MaltWhiskey/Technasium/Tech Cube/Documents/Pictures (used)/Frame test.JPEG

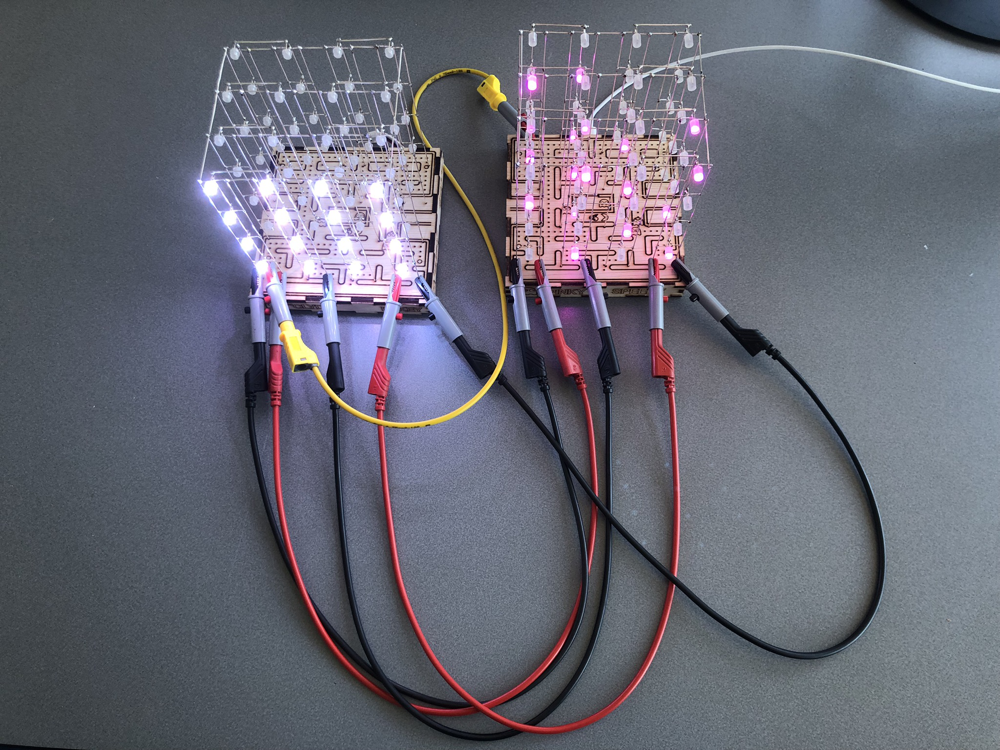
Tech Cube/Documents/Pictures (used)/Frame test.JPEG
