MaltWhiskey/Technasium/Tech Cube/Documents/Pictures/IMG_8260.JPEG

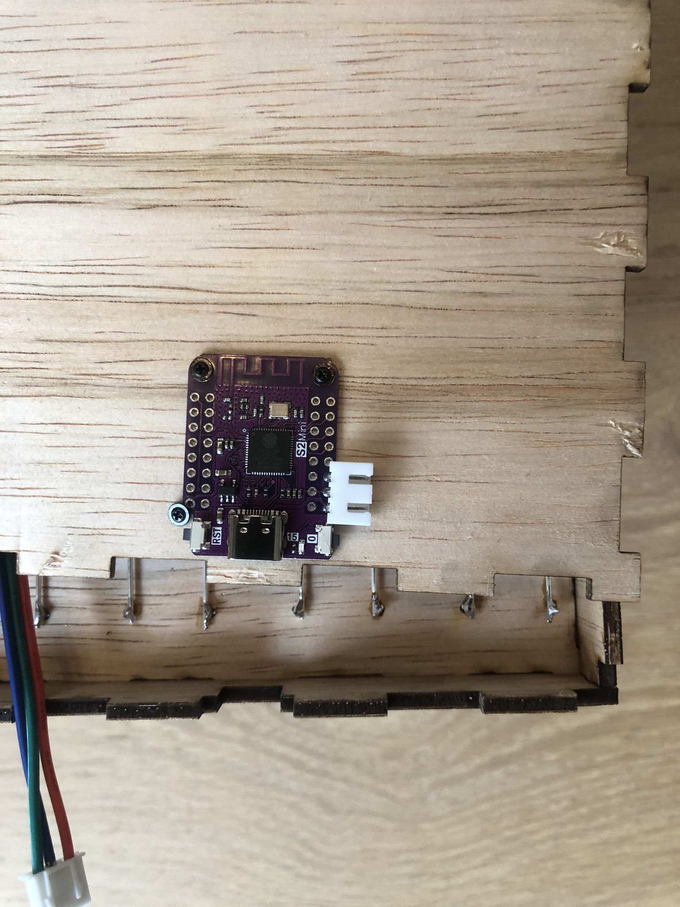
Tech Cube/Documents/Pictures/IMG_8260.JPEG
