MaltWhiskey/Technasium/Halloween/Sounds/Audacity.png

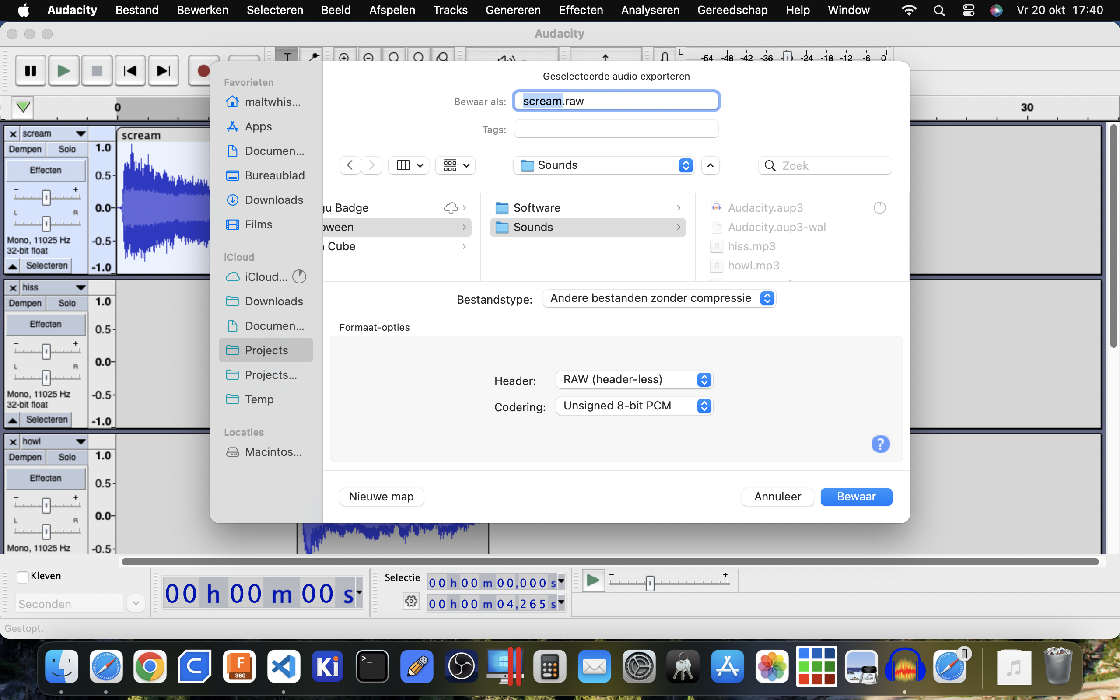
Halloween/Sounds/Audacity.png
