MaltWhiskey/Technasium/Tech Cube/Documents/Pictures (used)/Buigen.JPEG

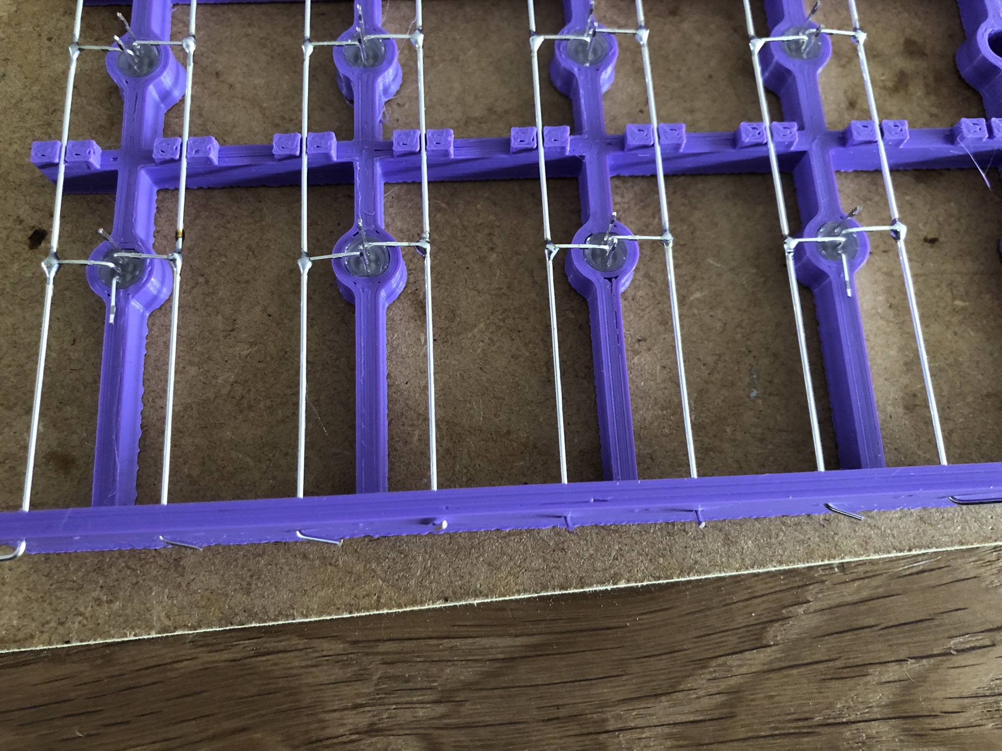
Tech Cube/Documents/Pictures (used)/Buigen.JPEG
