MaltWhiskey/Technasium/Tech Cube/Documents/Pictures (used)/F1.JPEG

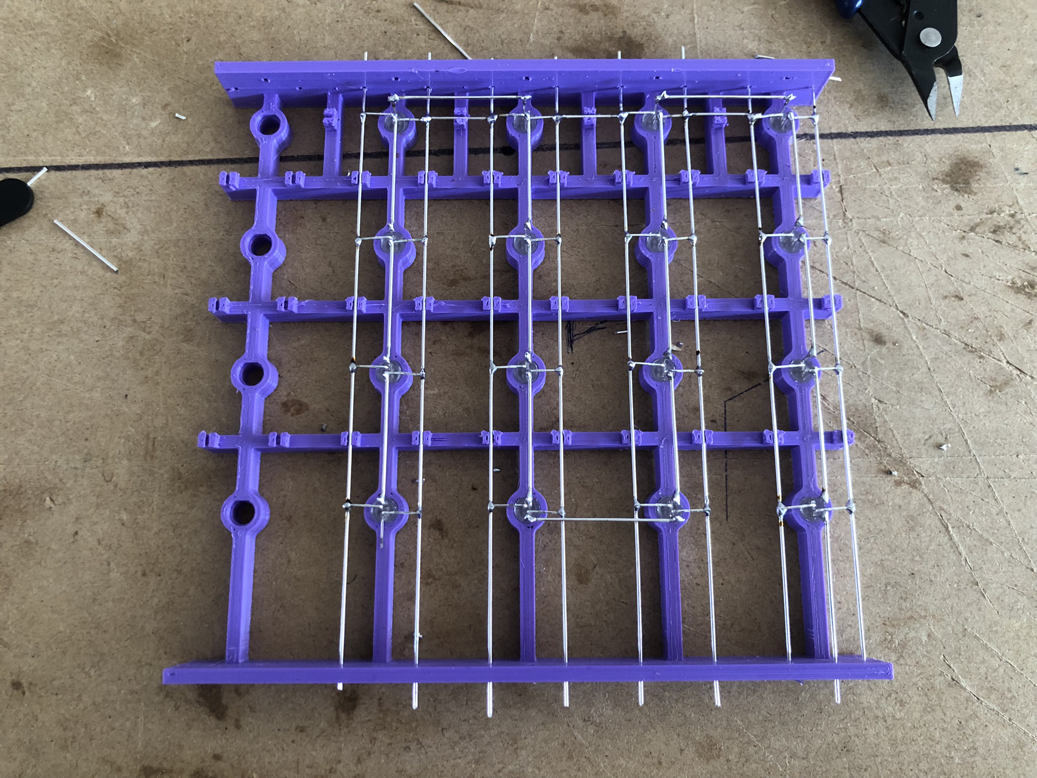
Tech Cube/Documents/Pictures (used)/F1.JPEG
