MaltWhiskey/Technasium/Tech Cube/Documents/Pictures (used)/F1F3 + Vormer.JPEG

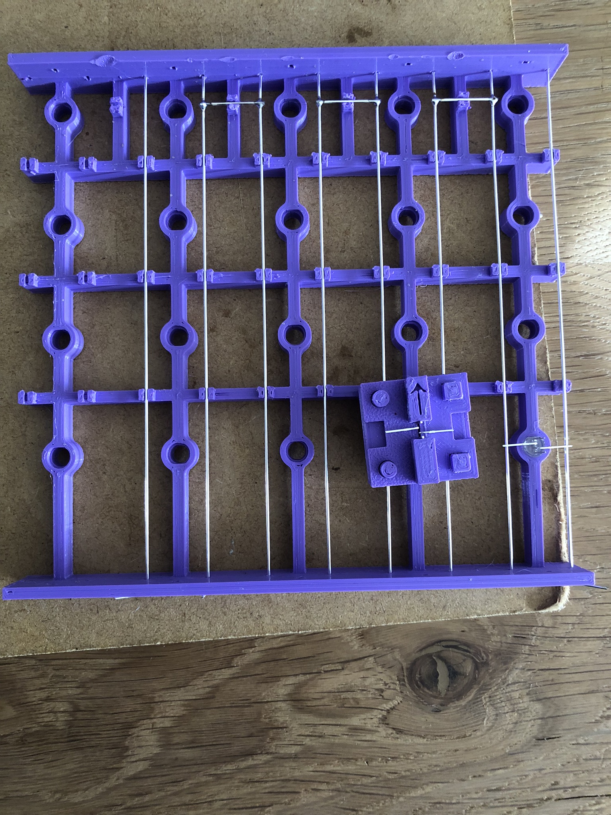
Tech Cube/Documents/Pictures (used)/F1F3 + Vormer.JPEG
