MaltWhiskey/Technasium/Tech Cube/Documents/Pictures (used)/F1F3 HOR.JPEG

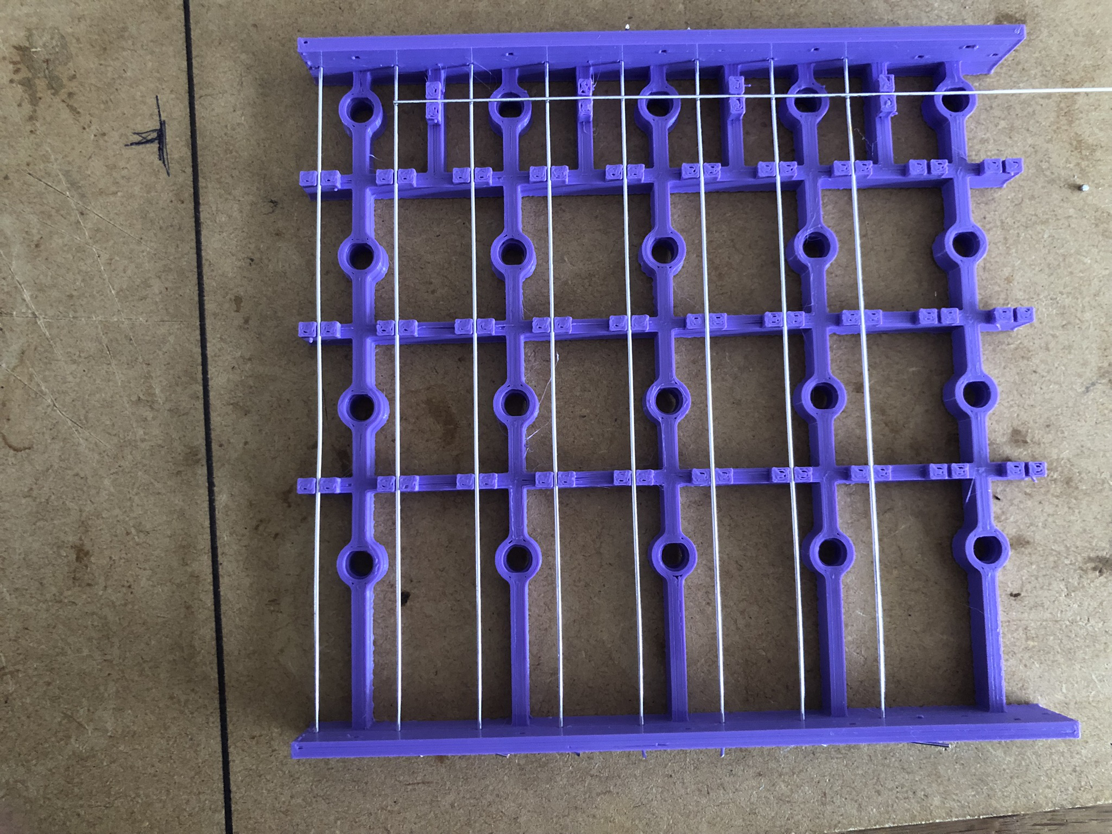
Tech Cube/Documents/Pictures (used)/F1F3 HOR.JPEG
