MaltWhiskey/Technasium/Tech Cube/Documents/Pictures (used)/F2F4 + Vormer.JPEG

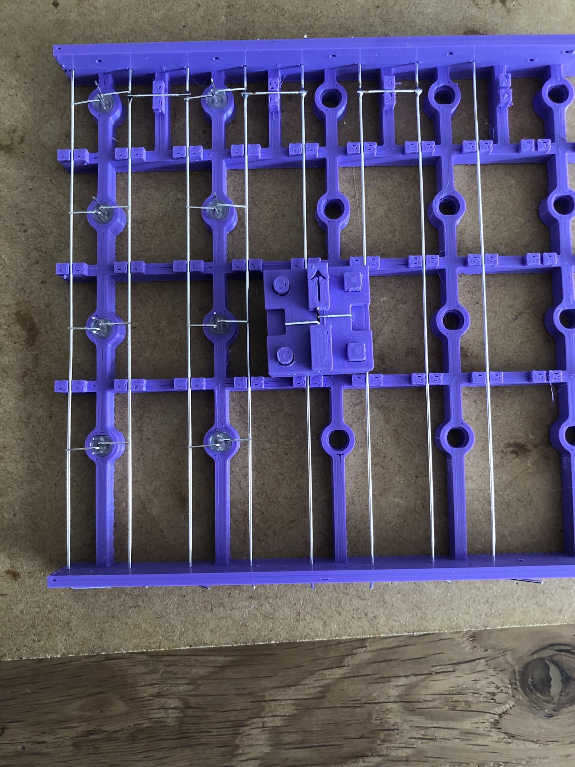
Tech Cube/Documents/Pictures (used)/F2F4 + Vormer.JPEG
