MaltWhiskey/Technasium/Tech Cube/Documents/Pictures (used)/F2F4 HOR.JPEG

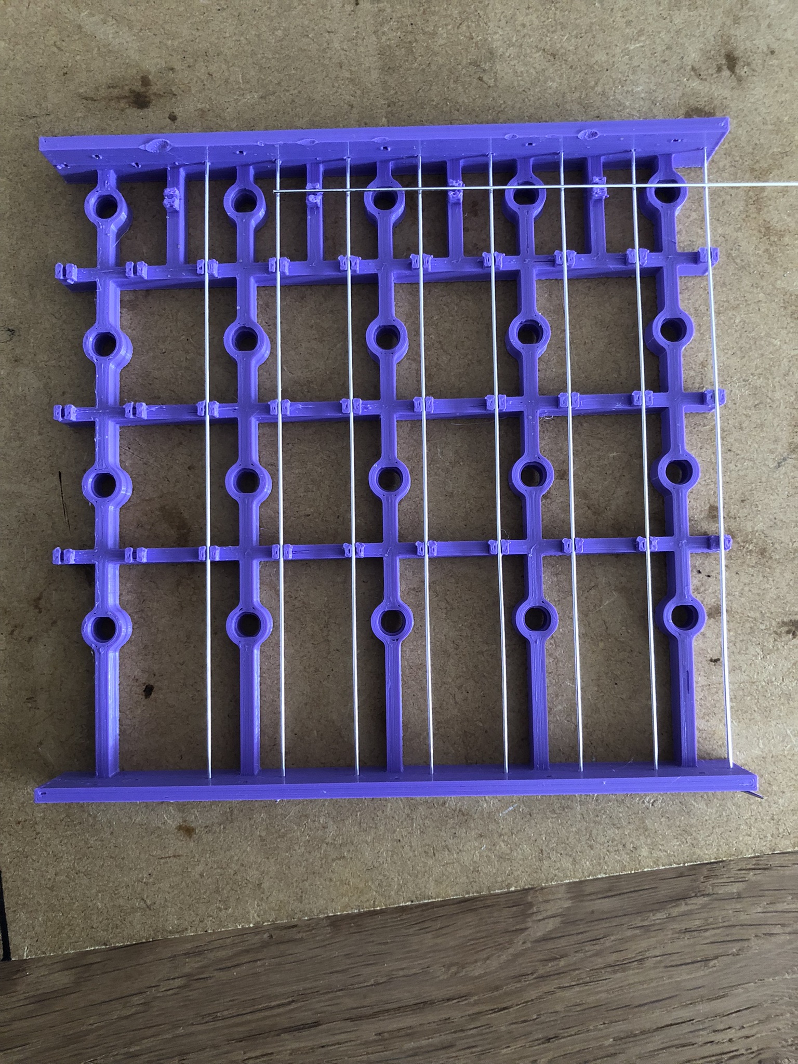
Tech Cube/Documents/Pictures (used)/F2F4 HOR.JPEG
