MaltWhiskey/Technasium/Tech Cube/Documents/Pictures (used)/H1.JPEG

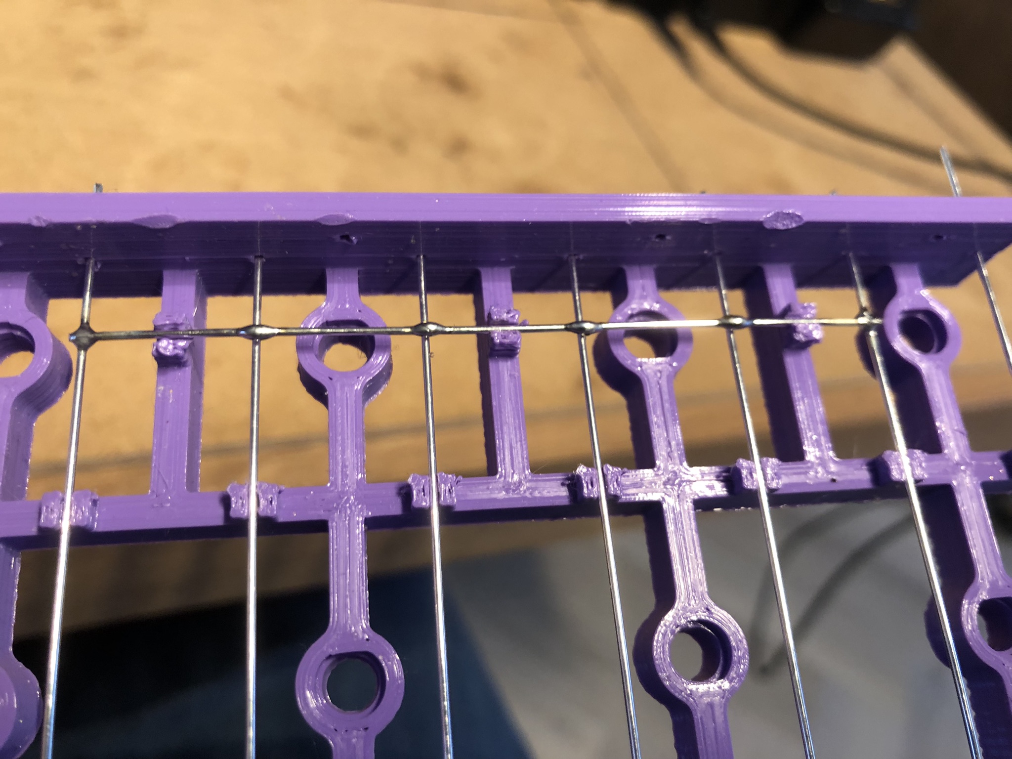
Tech Cube/Documents/Pictures (used)/H1.JPEG
