MaltWhiskey/Technasium/Tech Cube/Documents/Pictures (used)/H2.JPEG

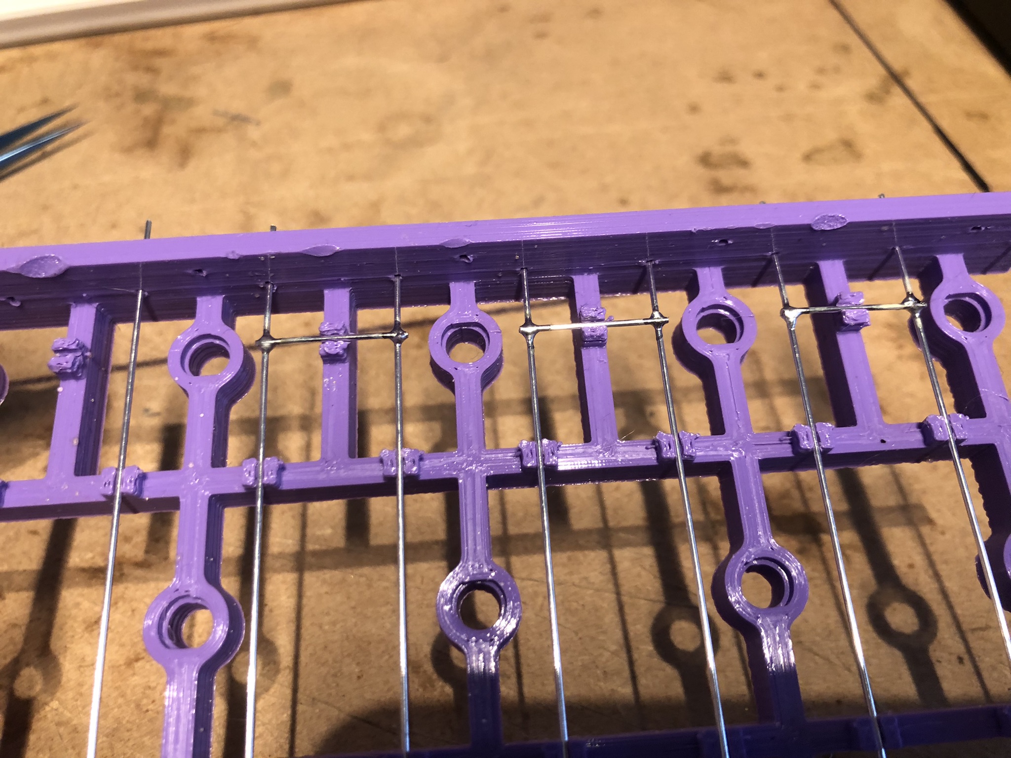
Tech Cube/Documents/Pictures (used)/H2.JPEG
