MaltWhiskey/Technasium/Tech Cube/Documents/Pictures (used)/H3.JPEG

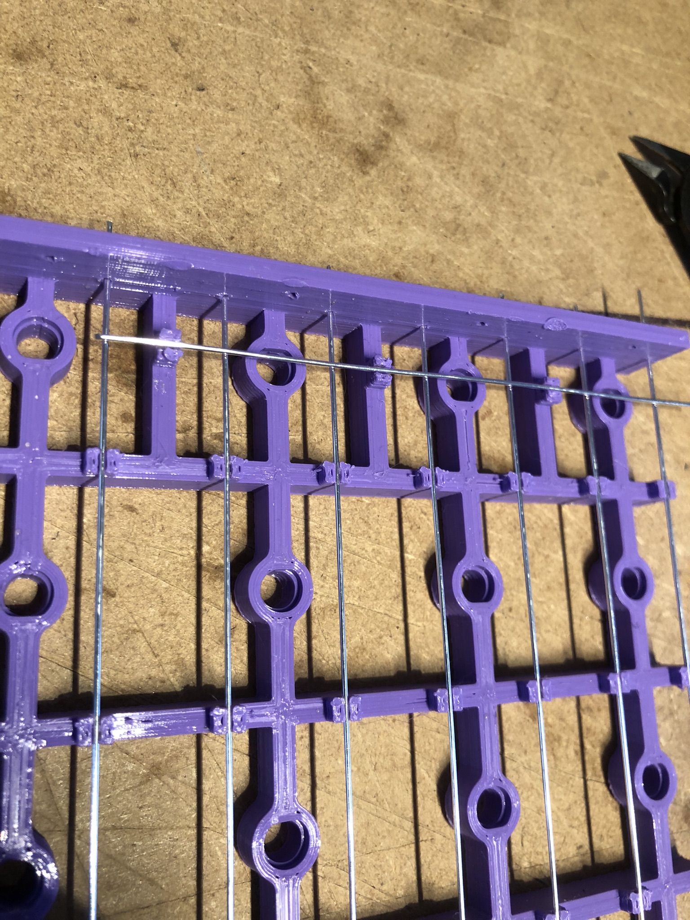
Tech Cube/Documents/Pictures (used)/H3.JPEG
