MaltWhiskey/Technasium/Tech Cube/Documents/Pictures (used)/Leds vorming.JPEG

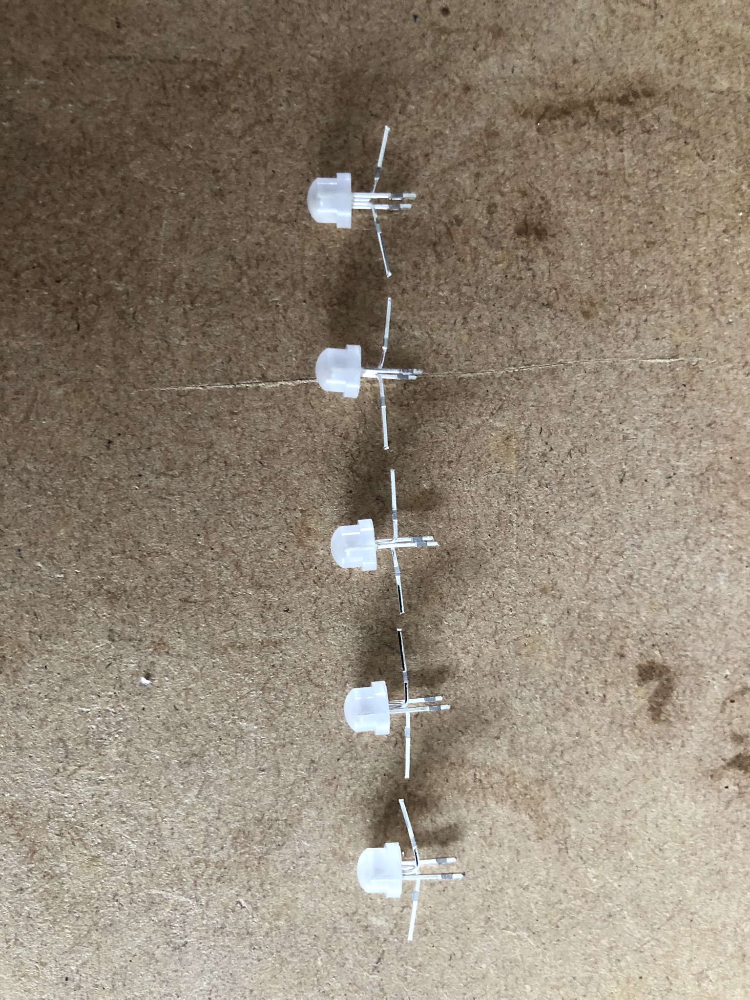
Tech Cube/Documents/Pictures (used)/Leds vorming.JPEG
