MaltWhiskey/Technasium/Tech Cube/Documents/Pictures (used)/Stangen.JPEG

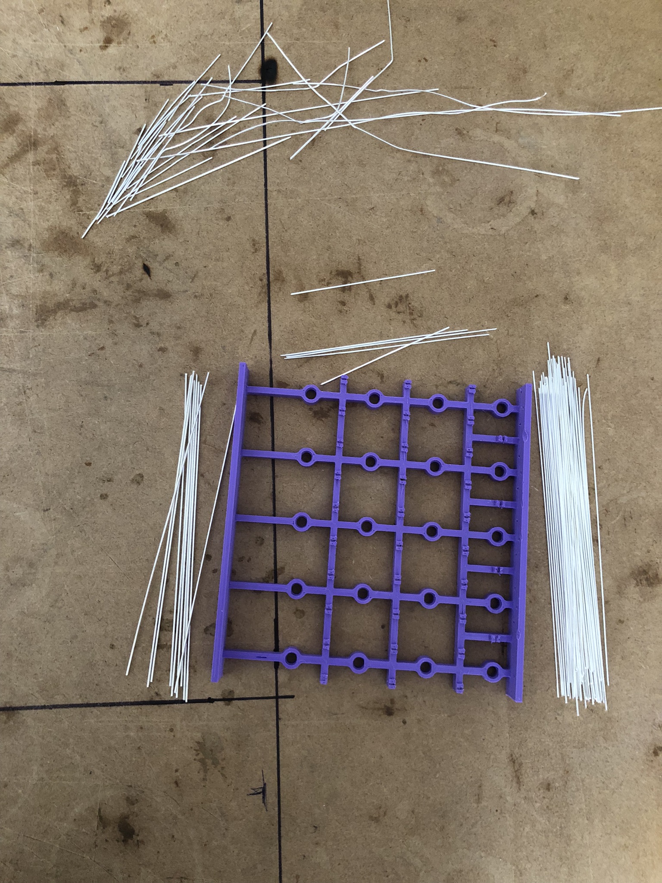
Tech Cube/Documents/Pictures (used)/Stangen.JPEG
