MaltWhiskey/Technasium/Tech Cube/Documents/Pictures (used)/Vormer.JPEG

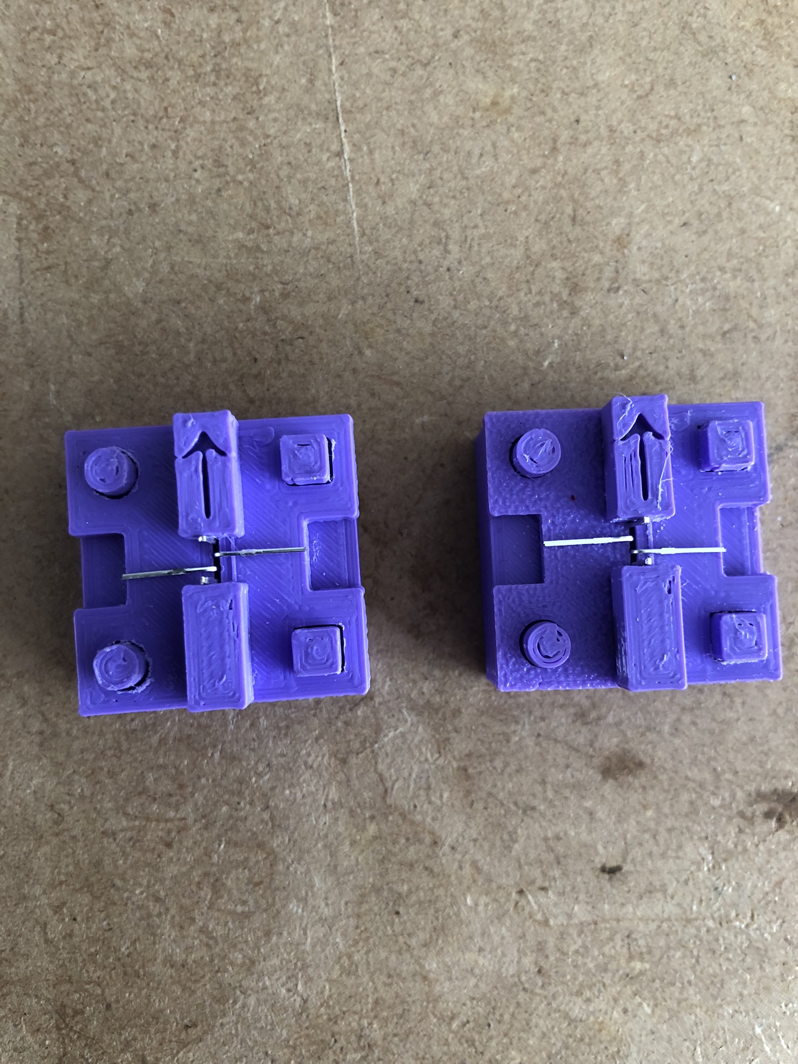
Tech Cube/Documents/Pictures (used)/Vormer.JPEG
