MaltWhiskey/Technasium/Tech Cube/Documents/Pictures (used)/Zelfde richting.JPEG

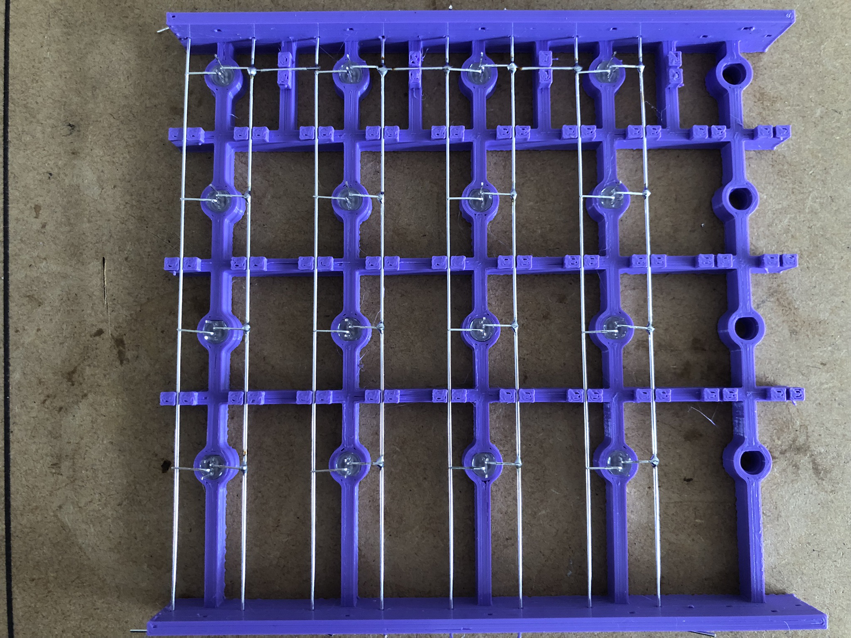
Tech Cube/Documents/Pictures (used)/Zelfde richting.JPEG
