MaltWhiskey/Technasium/Tech Cube/Documents/Pictures/IMG_1270.JPEG

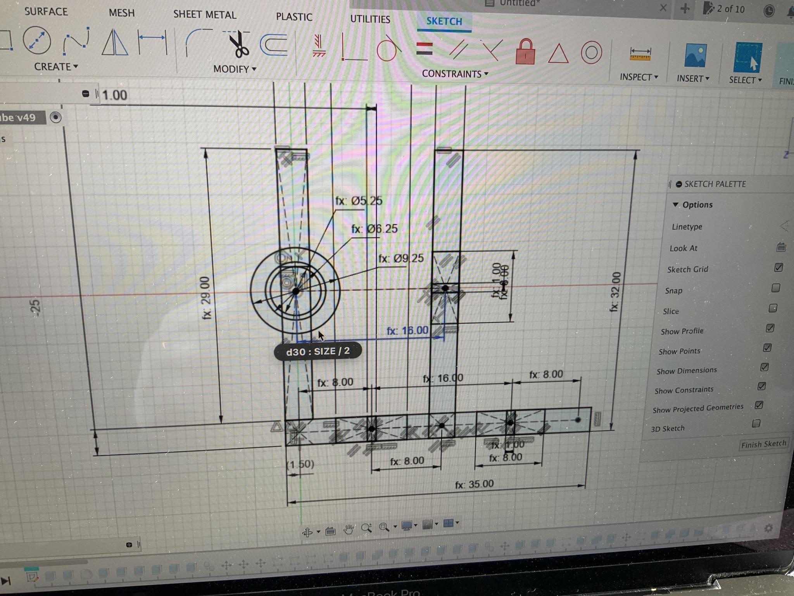
Tech Cube/Documents/Pictures/IMG_1270.JPEG
