MaltWhiskey/Technasium/Tech Cube/Documents/Pictures/IMG_8004.JPEG

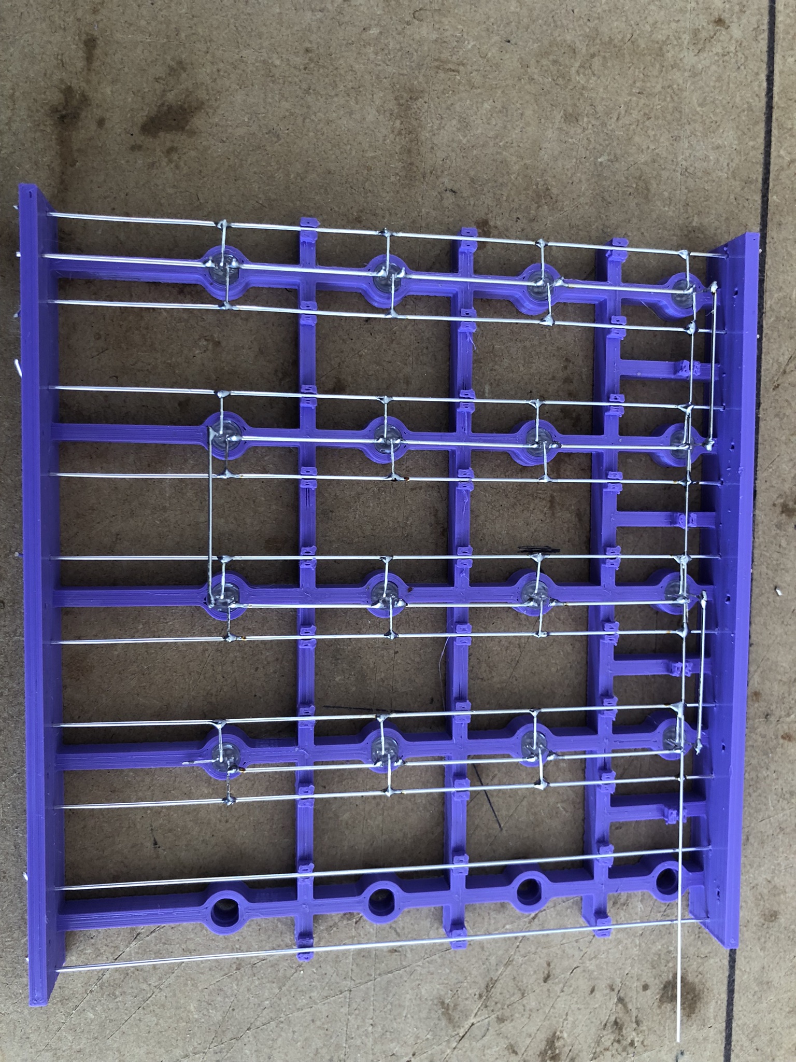
Tech Cube/Documents/Pictures/IMG_8004.JPEG
