MaltWhiskey/Technasium/Tech Cube/Documents/Pictures/IMG_8005.JPEG

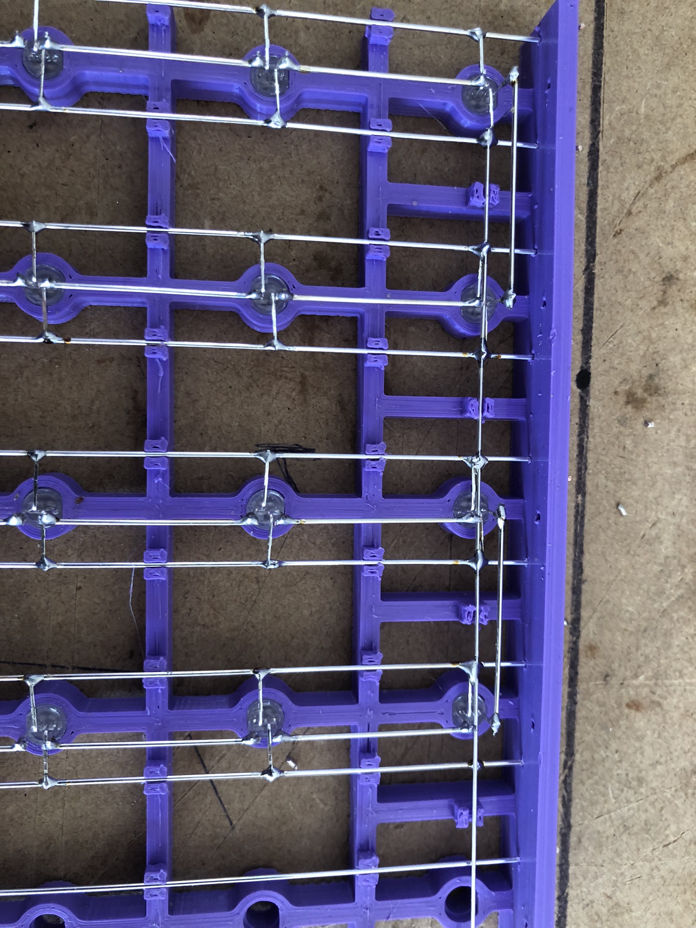
Tech Cube/Documents/Pictures/IMG_8005.JPEG
