MaltWhiskey/Technasium/Tech Cube/Documents/Pictures/IMG_8006.JPEG

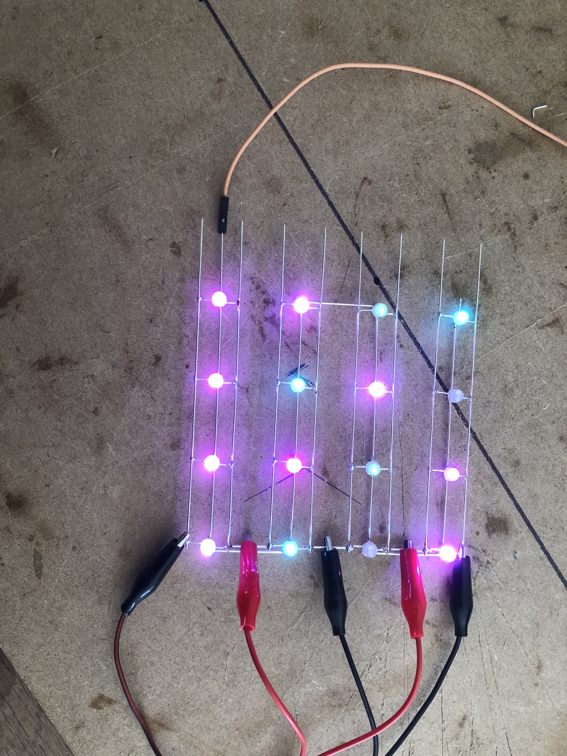
Tech Cube/Documents/Pictures/IMG_8006.JPEG
