MaltWhiskey/Technasium/Tech Cube/Documents/Pictures/IMG_8009.JPEG

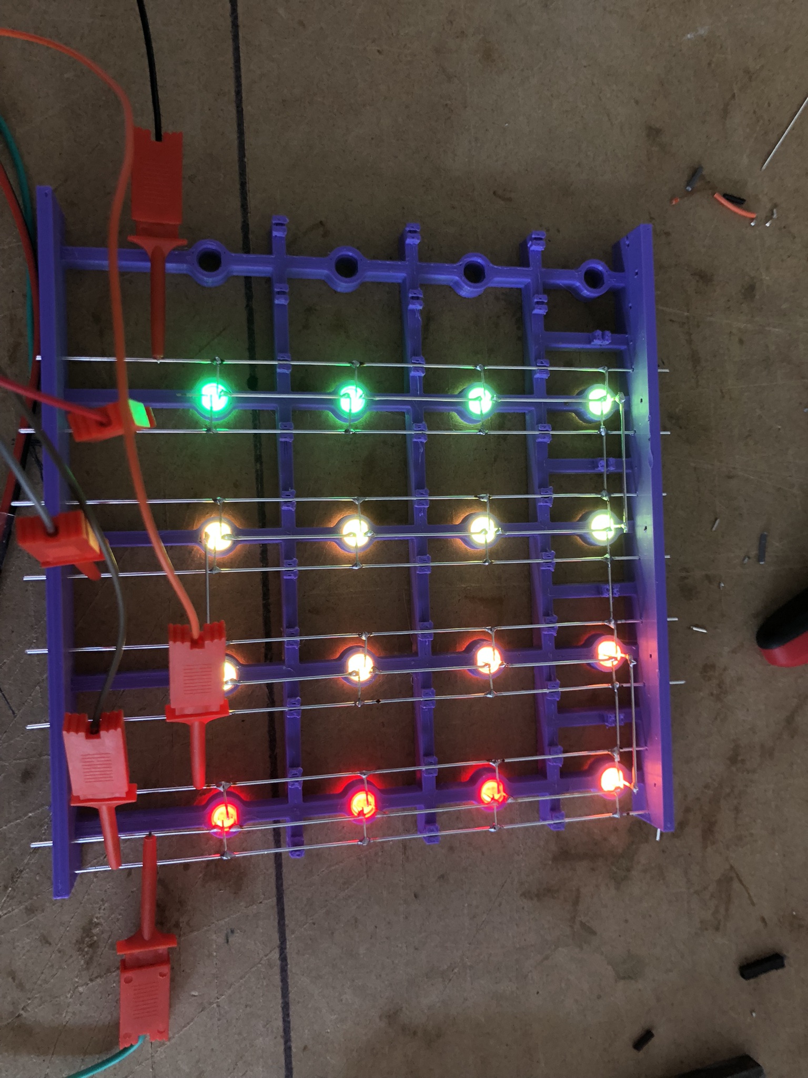
Tech Cube/Documents/Pictures/IMG_8009.JPEG
