MaltWhiskey/Technasium/Tech Cube/Documents/Pictures/IMG_8010.JPEG

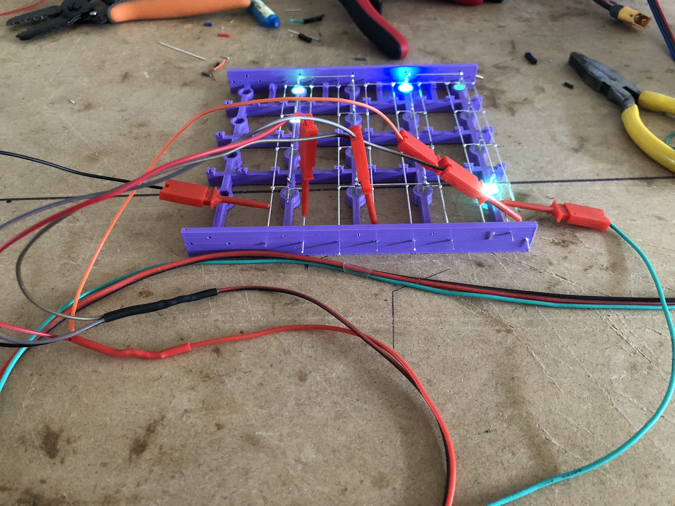
Tech Cube/Documents/Pictures/IMG_8010.JPEG
