MaltWhiskey/Technasium/Tech Cube/Documents/Pictures/IMG_8049.JPEG

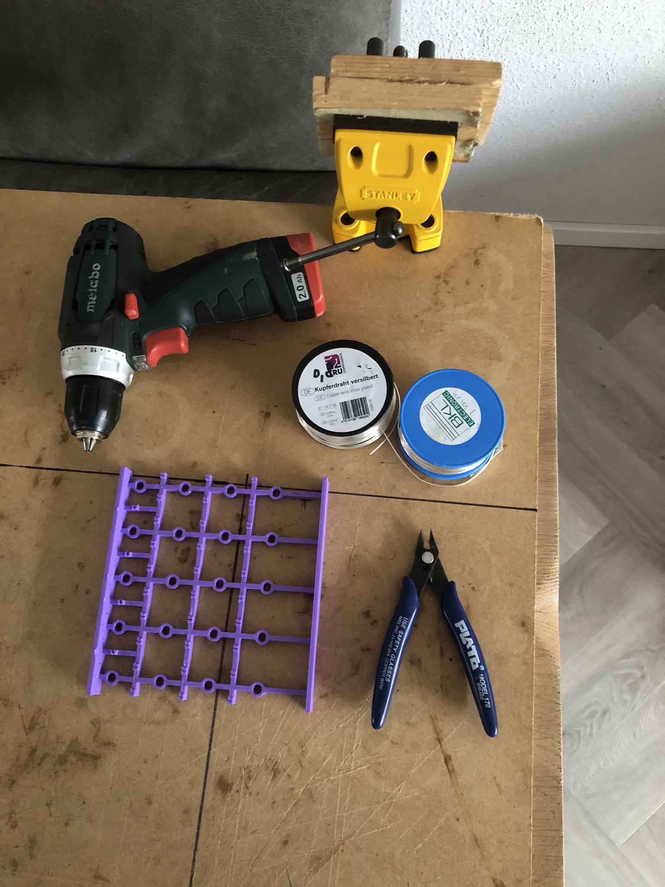
Tech Cube/Documents/Pictures/IMG_8049.JPEG
