MaltWhiskey/Technasium/Tech Cube/Documents/Pictures/IMG_8050.JPEG

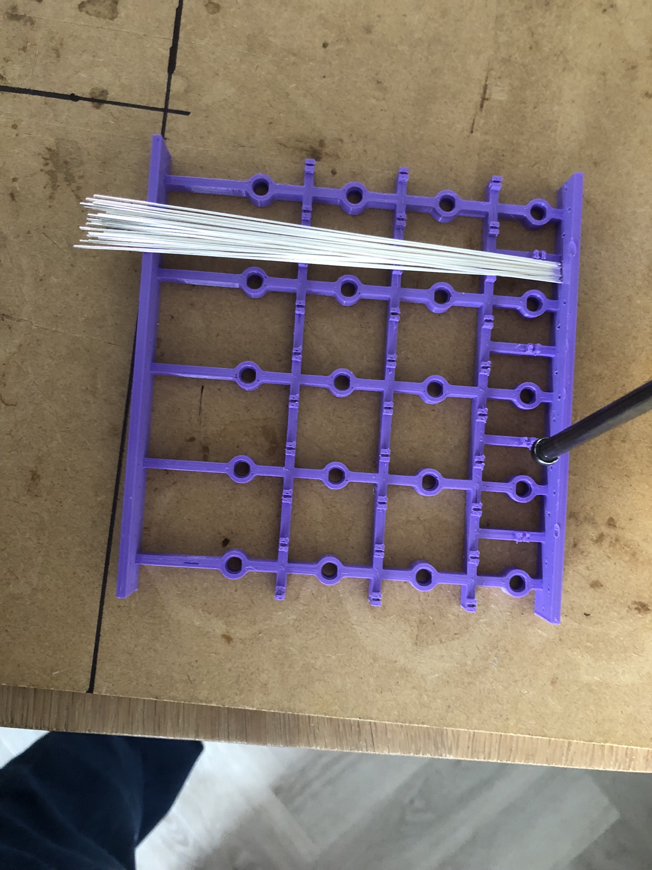
Tech Cube/Documents/Pictures/IMG_8050.JPEG
