MaltWhiskey/Technasium/Tech Cube/Documents/Pictures/IMG_8053.JPEG

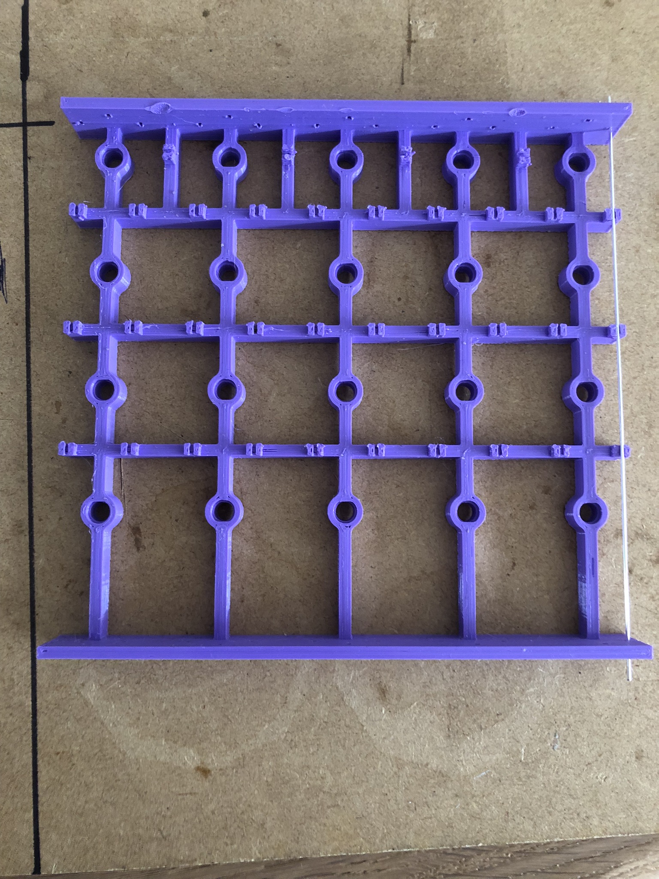
Tech Cube/Documents/Pictures/IMG_8053.JPEG
