MaltWhiskey/Technasium/Tech Cube/Documents/Pictures/IMG_8054.JPEG

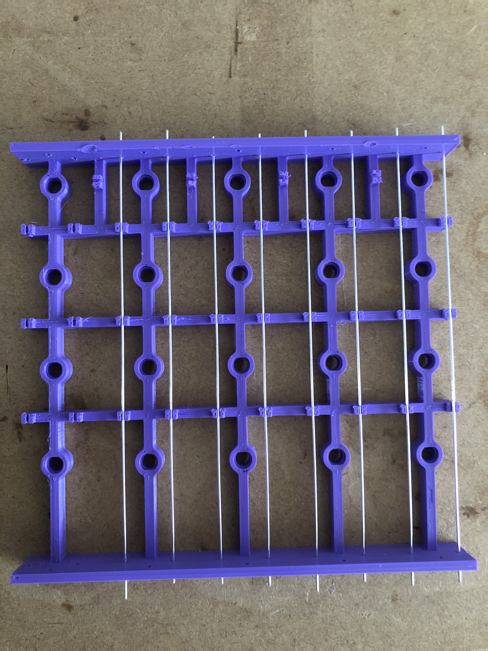
Tech Cube/Documents/Pictures/IMG_8054.JPEG
