MaltWhiskey/Technasium/Tech Cube/Documents/Pictures/IMG_8055.JPEG

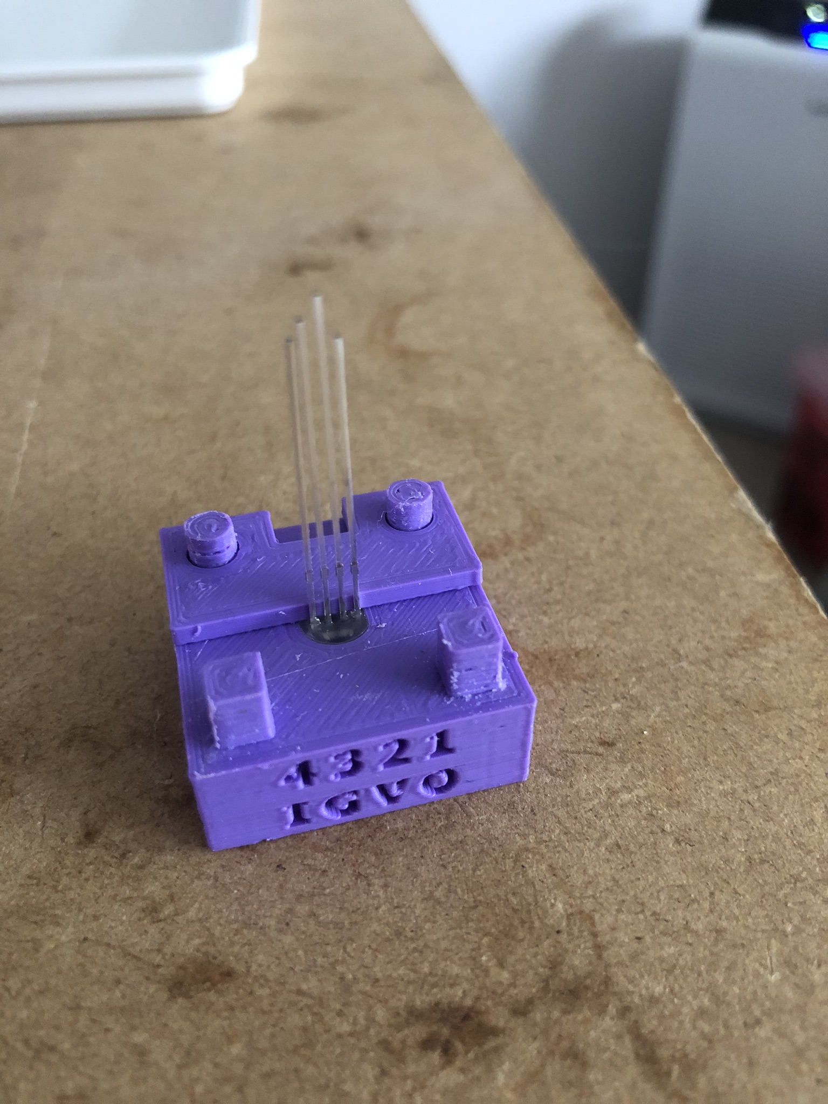
Tech Cube/Documents/Pictures/IMG_8055.JPEG
