MaltWhiskey/Technasium/Tech Cube/Documents/Pictures/IMG_8056.JPEG

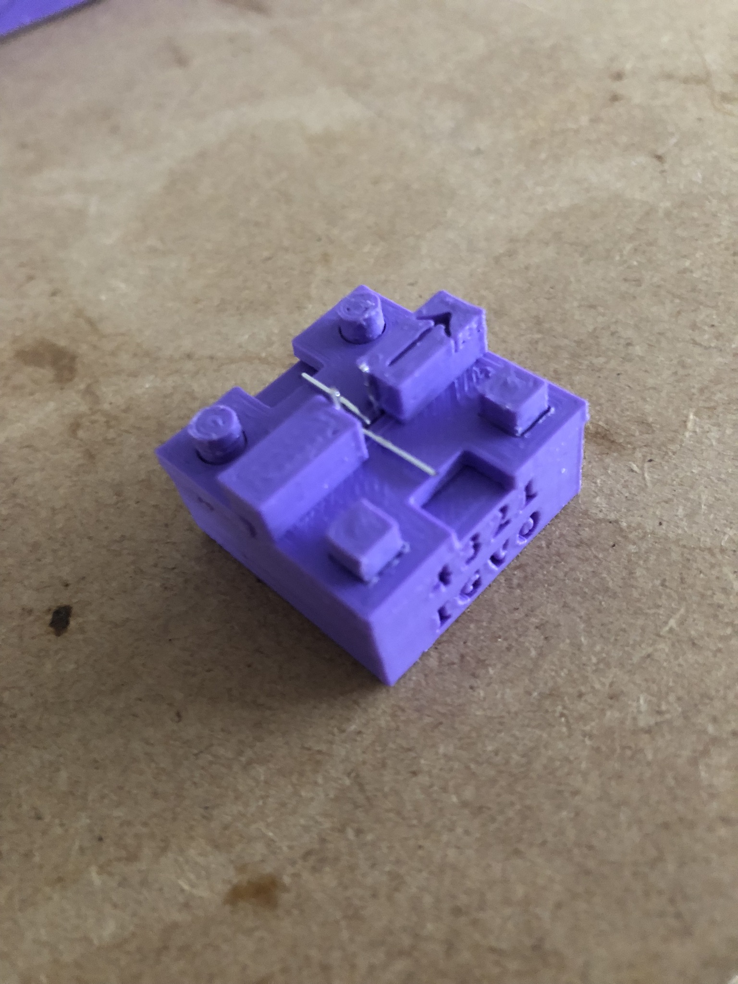
Tech Cube/Documents/Pictures/IMG_8056.JPEG
