MaltWhiskey/Technasium/Tech Cube/Documents/Pictures/IMG_8057.JPEG

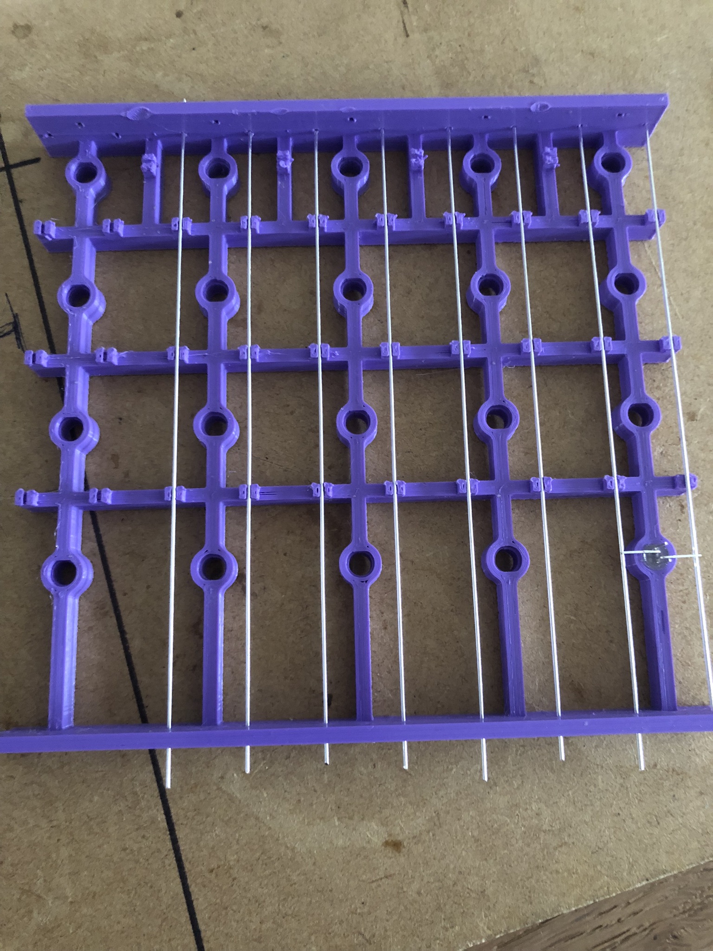
Tech Cube/Documents/Pictures/IMG_8057.JPEG
