MaltWhiskey/Technasium/Tech Cube/Documents/Pictures/IMG_8058.JPEG

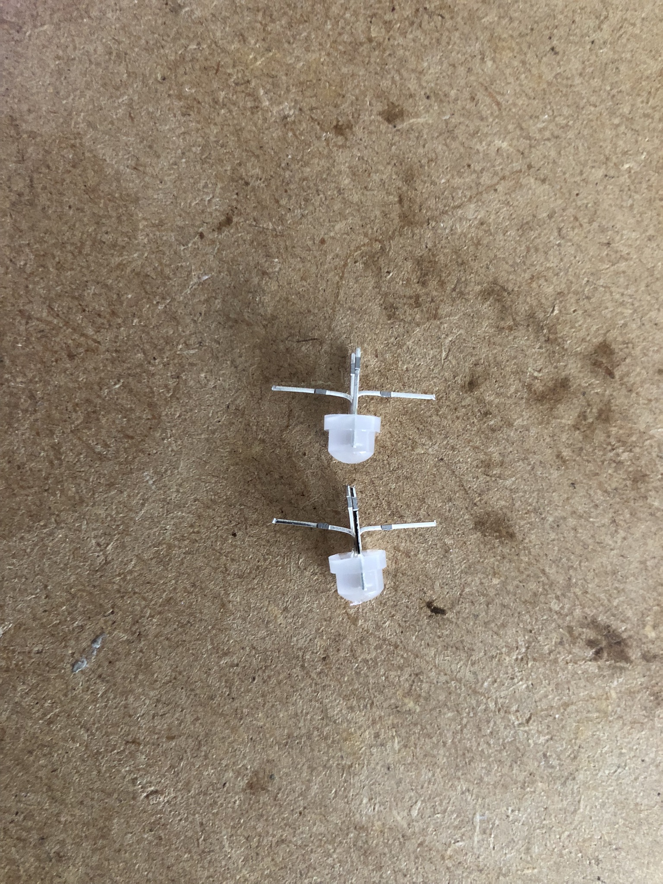
Tech Cube/Documents/Pictures/IMG_8058.JPEG
