MaltWhiskey/Technasium/Tech Cube/Documents/Pictures/IMG_8062.JPEG

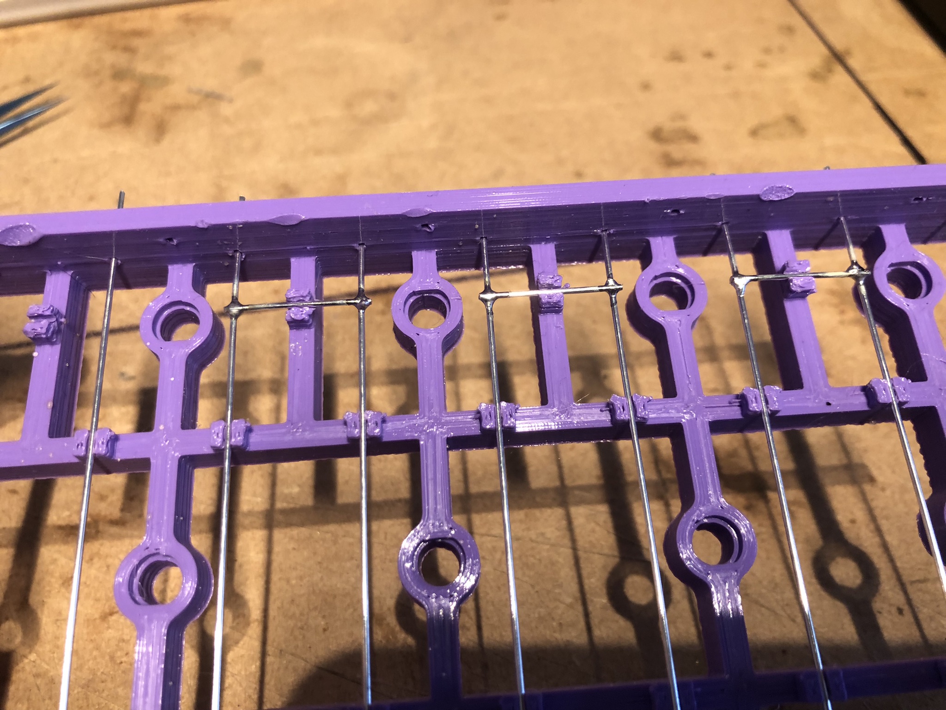
Tech Cube/Documents/Pictures/IMG_8062.JPEG
