MaltWhiskey/Technasium/Tech Cube/Documents/Pictures/IMG_8063.JPEG

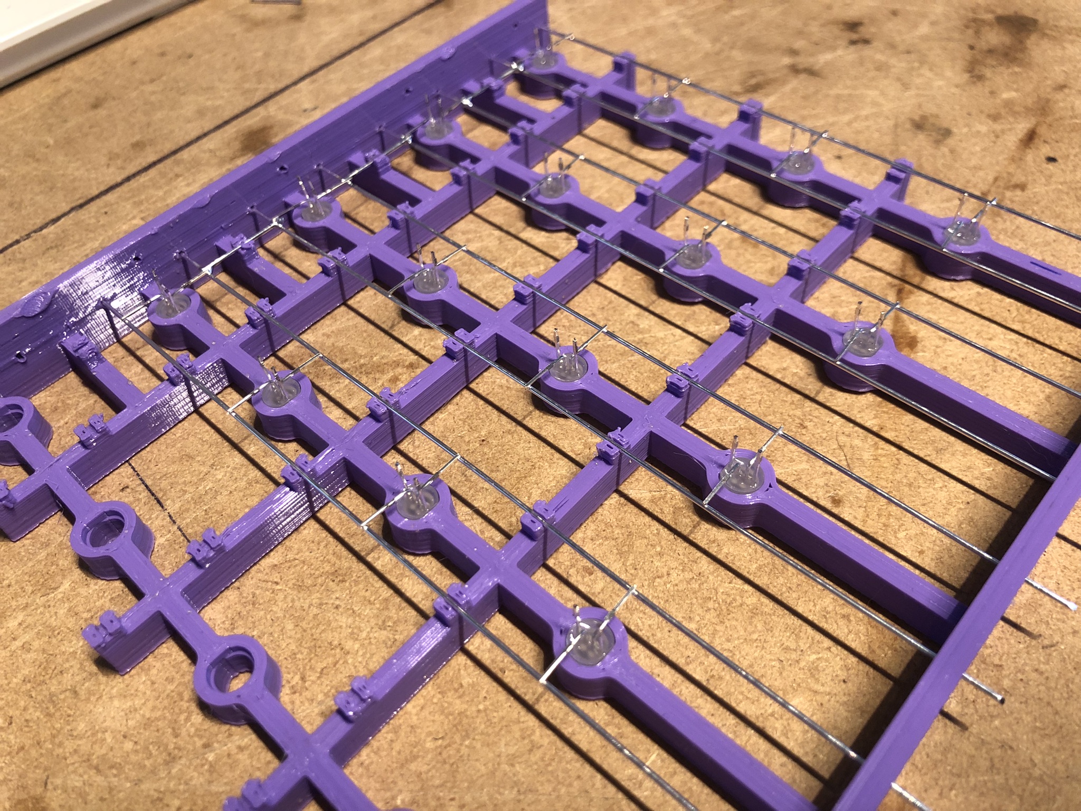
Tech Cube/Documents/Pictures/IMG_8063.JPEG
