MaltWhiskey/Technasium/Tech Cube/Documents/Pictures/IMG_8064.JPEG

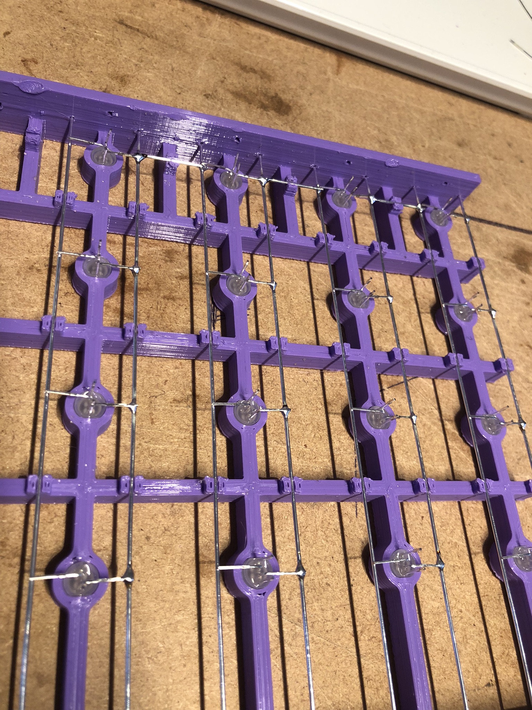
Tech Cube/Documents/Pictures/IMG_8064.JPEG
