MaltWhiskey/Technasium/Tech Cube/Documents/Pictures/IMG_8065.JPEG

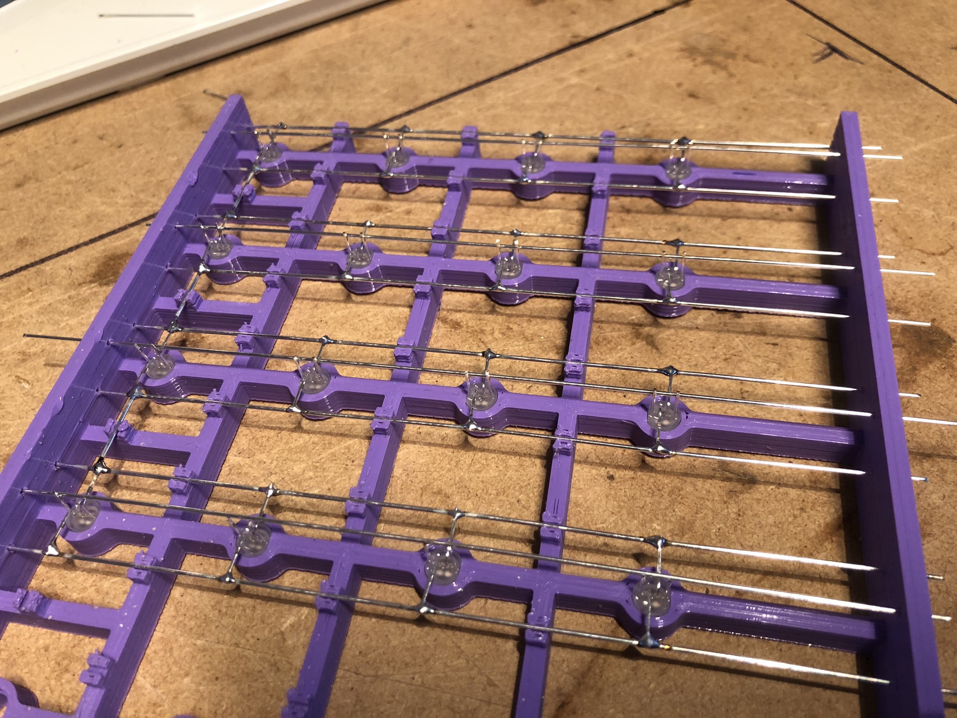
Tech Cube/Documents/Pictures/IMG_8065.JPEG
