MaltWhiskey/Technasium/Tech Cube/Documents/Pictures/IMG_8066.JPEG

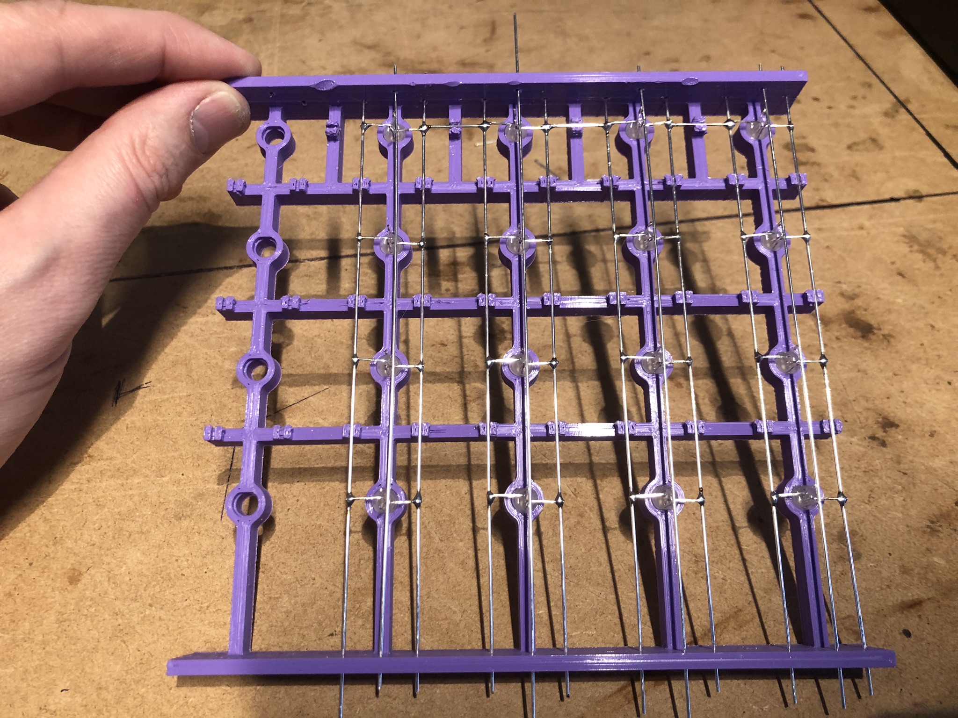
Tech Cube/Documents/Pictures/IMG_8066.JPEG
