MaltWhiskey/Technasium/Tech Cube/Documents/Pictures/IMG_8067.JPEG

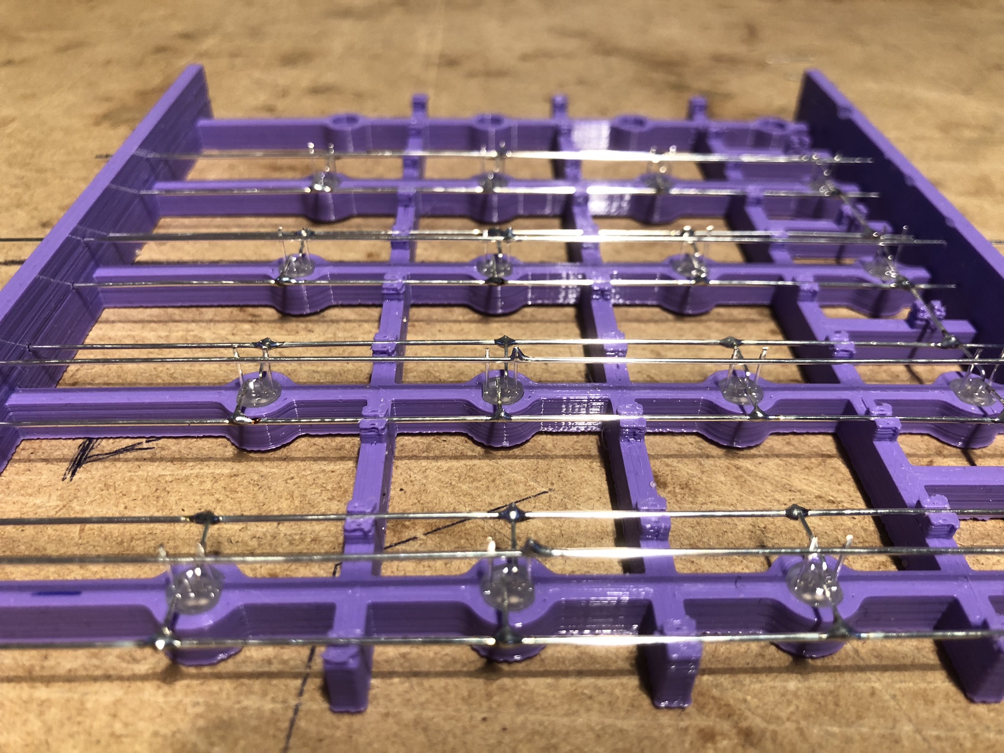
Tech Cube/Documents/Pictures/IMG_8067.JPEG
