MaltWhiskey/Technasium/Tech Cube/Documents/Pictures/IMG_8068.JPEG

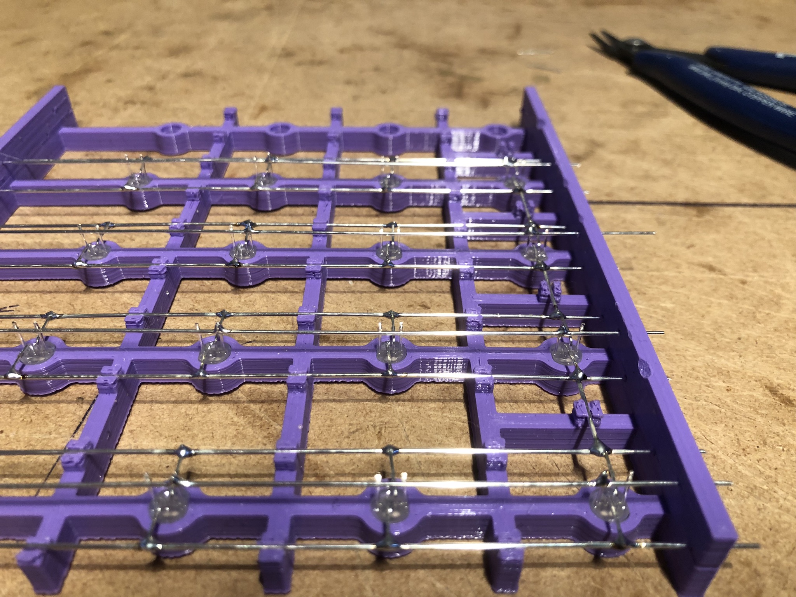
Tech Cube/Documents/Pictures/IMG_8068.JPEG
