MaltWhiskey/Technasium/Tech Cube/Documents/Pictures/IMG_8069.JPEG

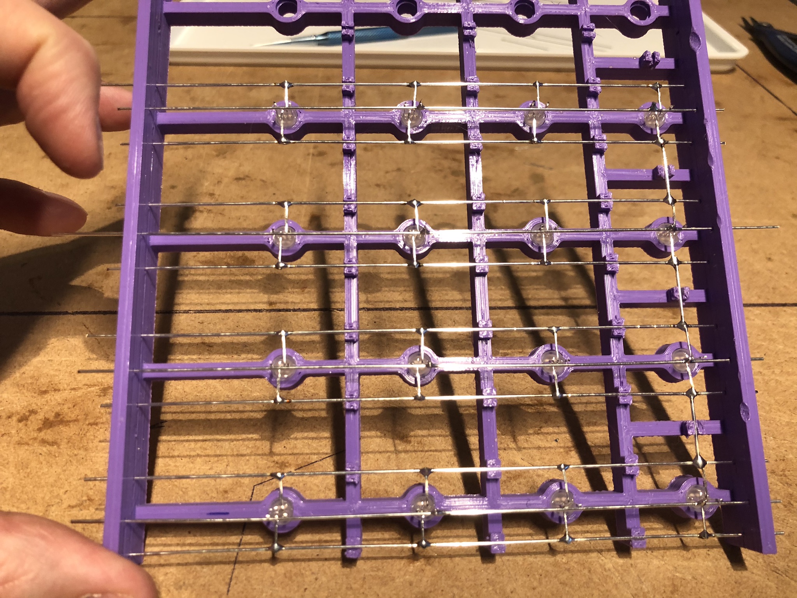
Tech Cube/Documents/Pictures/IMG_8069.JPEG
