MaltWhiskey/Technasium/Tech Cube/Documents/Pictures/IMG_8070.JPEG

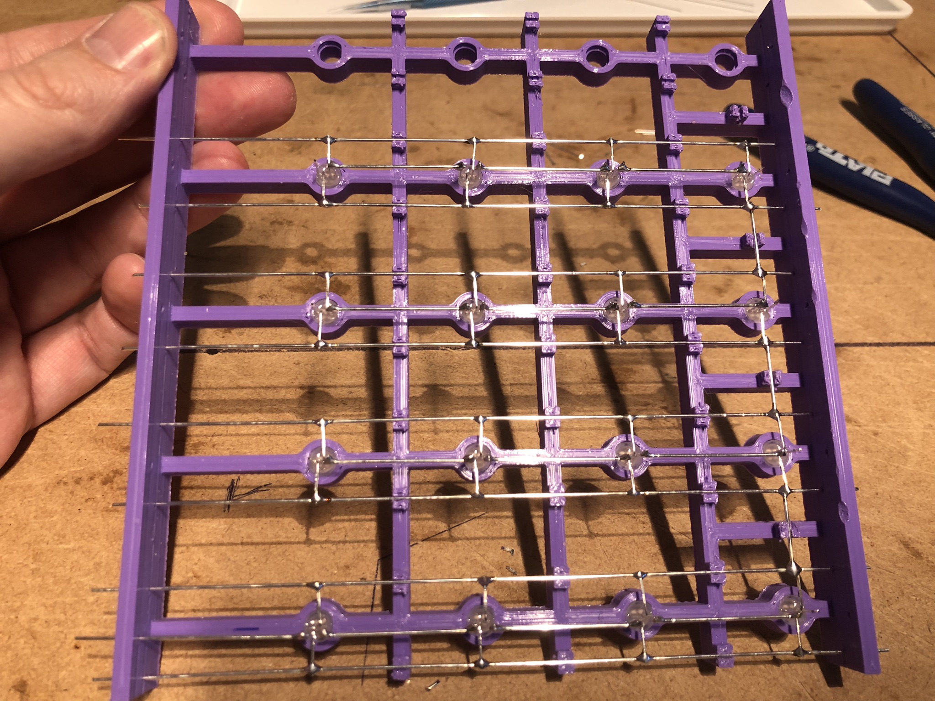
Tech Cube/Documents/Pictures/IMG_8070.JPEG
