MaltWhiskey/Technasium/Tech Cube/Documents/Pictures/IMG_8072.JPEG

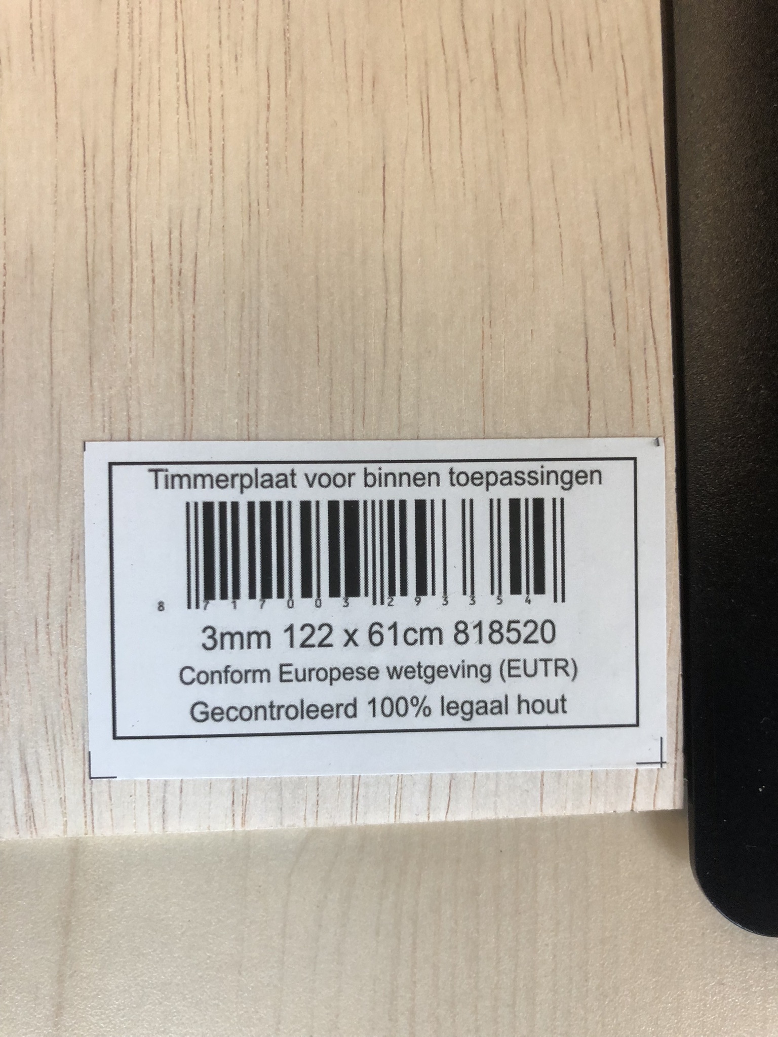
Tech Cube/Documents/Pictures/IMG_8072.JPEG
