MaltWhiskey/Technasium/Tech Cube/Documents/Pictures/IMG_8073.JPEG

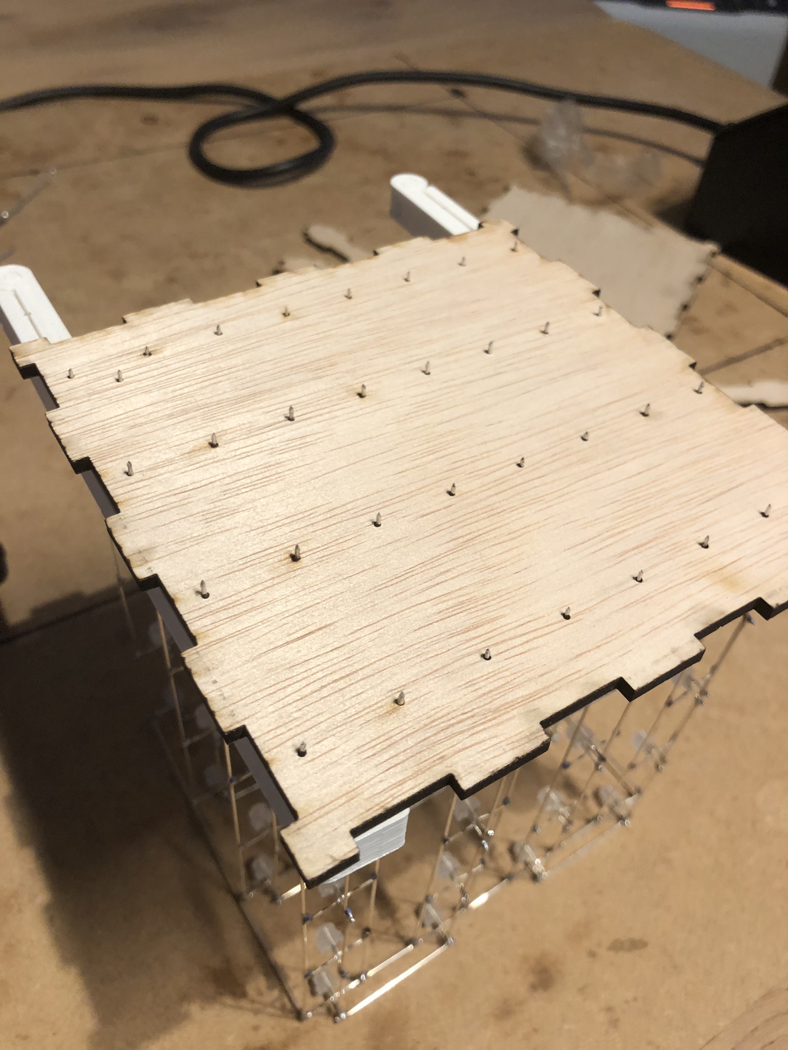
Tech Cube/Documents/Pictures/IMG_8073.JPEG
