MaltWhiskey/Technasium/Tech Cube/Documents/Pictures/IMG_8074.JPEG

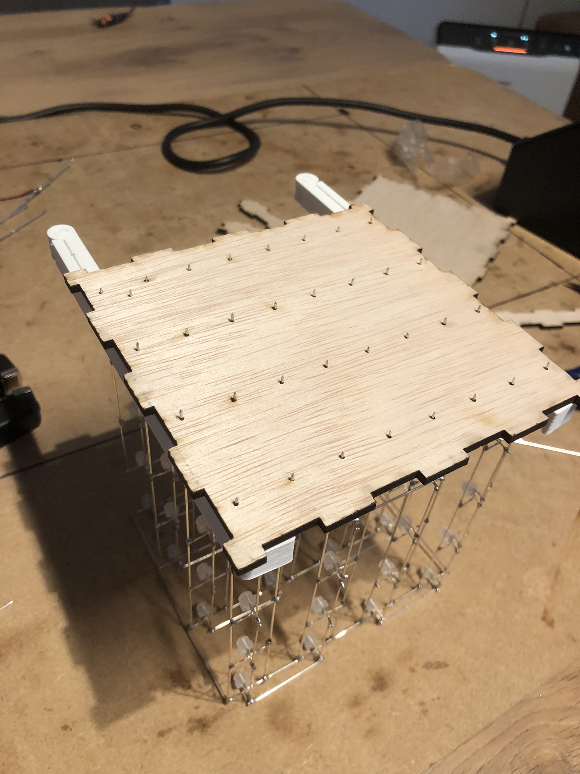
Tech Cube/Documents/Pictures/IMG_8074.JPEG
