MaltWhiskey/Technasium/Tech Cube/Documents/Pictures/IMG_8075.JPEG

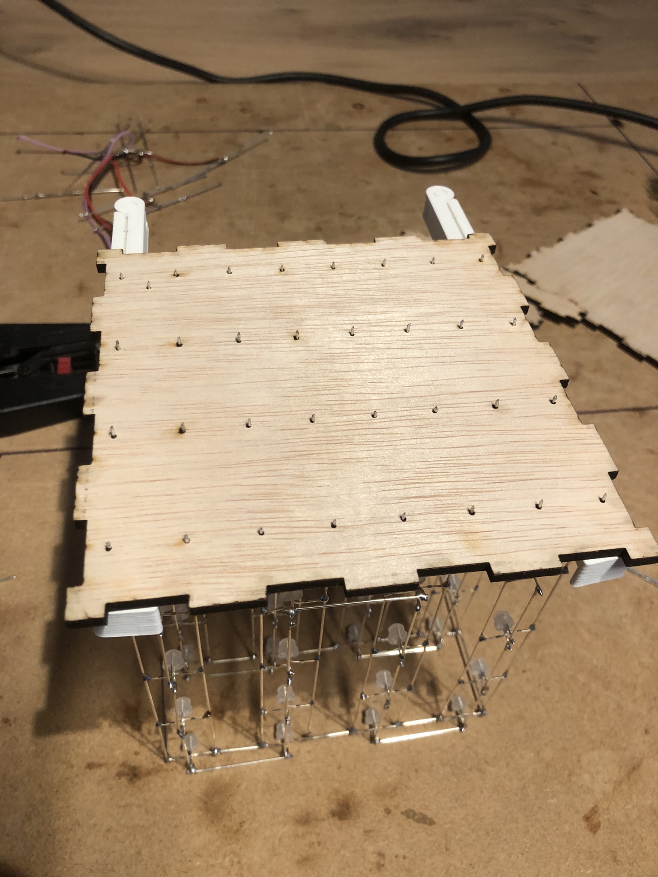
Tech Cube/Documents/Pictures/IMG_8075.JPEG
