MaltWhiskey/Technasium/Tech Cube/Documents/Pictures/IMG_8076.JPEG

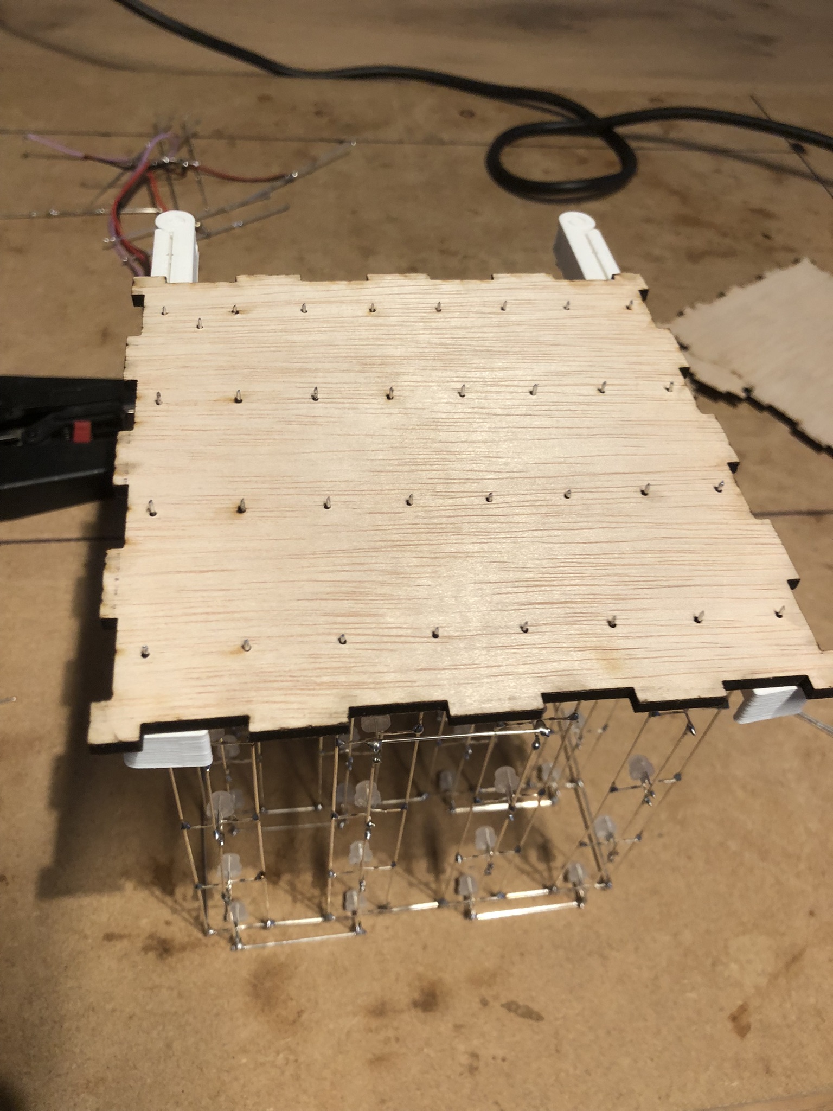
Tech Cube/Documents/Pictures/IMG_8076.JPEG
