MaltWhiskey/Technasium/Tech Cube/Documents/Pictures/IMG_8077.JPEG

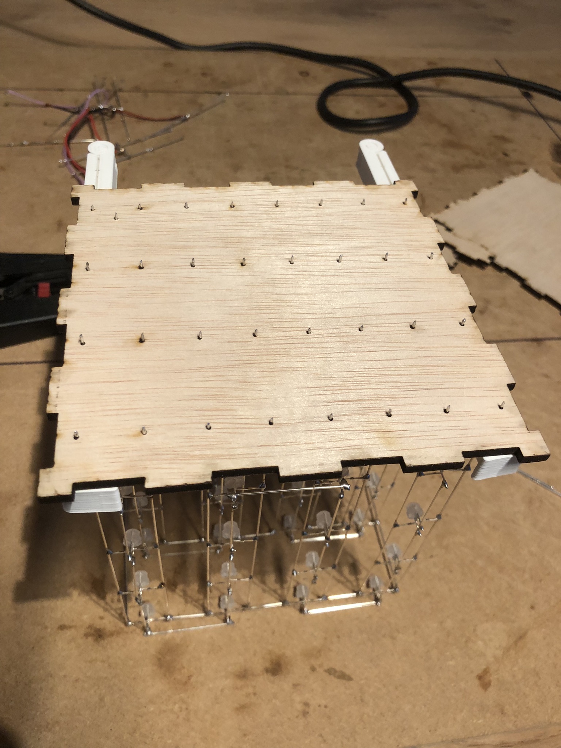
Tech Cube/Documents/Pictures/IMG_8077.JPEG
