MaltWhiskey/Technasium/Tech Cube/Documents/Pictures/IMG_8078.JPEG

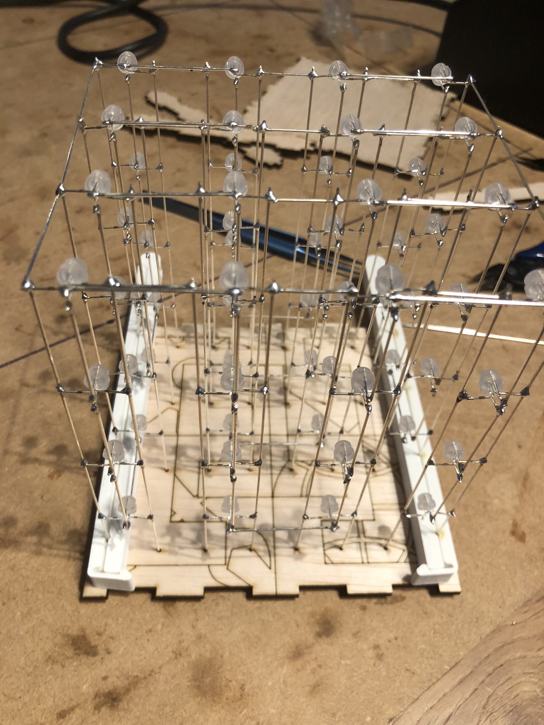
Tech Cube/Documents/Pictures/IMG_8078.JPEG
