MaltWhiskey/Technasium/Tech Cube/Documents/Pictures/IMG_8079.JPEG

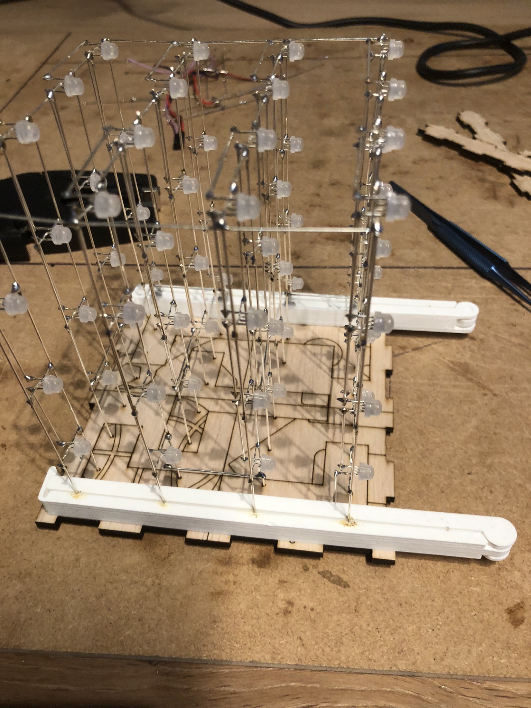
Tech Cube/Documents/Pictures/IMG_8079.JPEG
