MaltWhiskey/Technasium/Tech Cube/Documents/Pictures/IMG_8080.JPEG

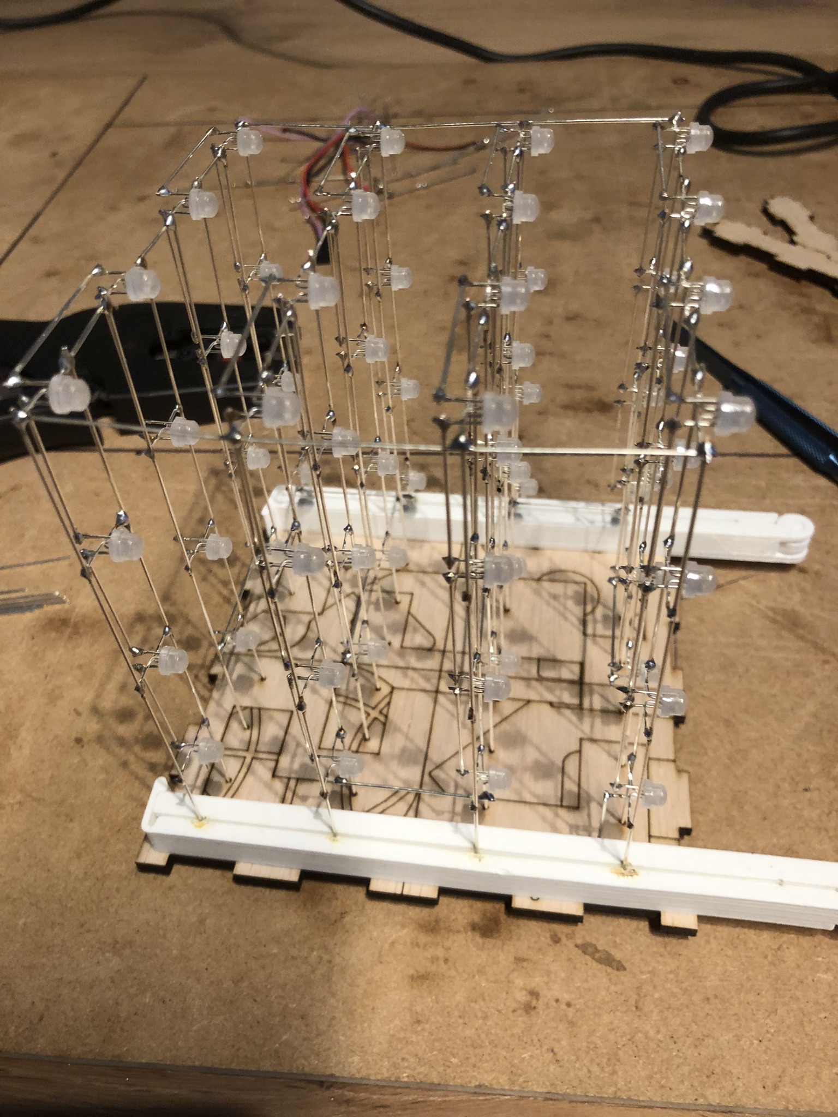
Tech Cube/Documents/Pictures/IMG_8080.JPEG
