MaltWhiskey/Technasium/Tech Cube/Documents/Pictures/IMG_8081.JPEG

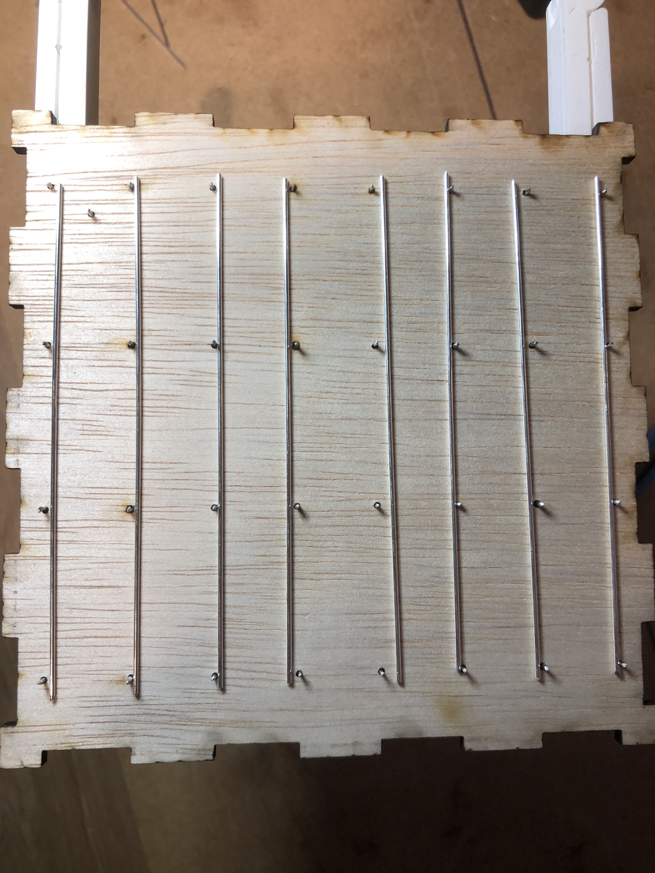
Tech Cube/Documents/Pictures/IMG_8081.JPEG
