MaltWhiskey/Technasium/Tech Cube/Documents/Pictures/IMG_8083.JPEG

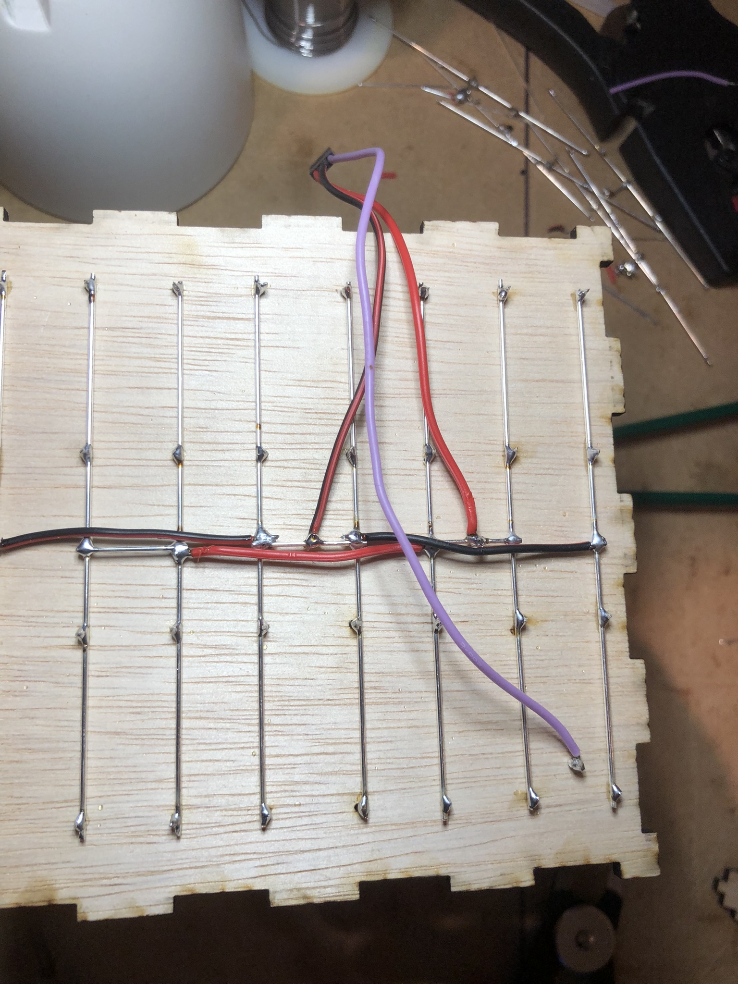
Tech Cube/Documents/Pictures/IMG_8083.JPEG
