MaltWhiskey/Technasium/Tech Cube/Documents/Pictures/IMG_8084.JPEG

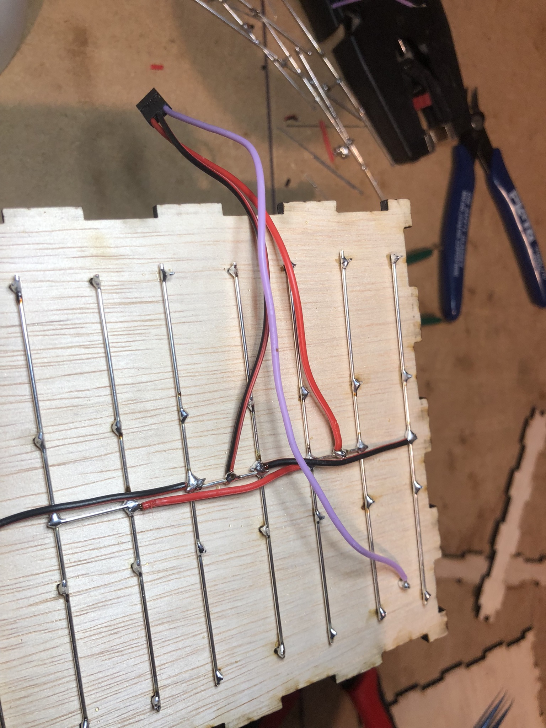
Tech Cube/Documents/Pictures/IMG_8084.JPEG
