MaltWhiskey/Technasium/Tech Cube/Documents/Pictures/IMG_8085.JPEG

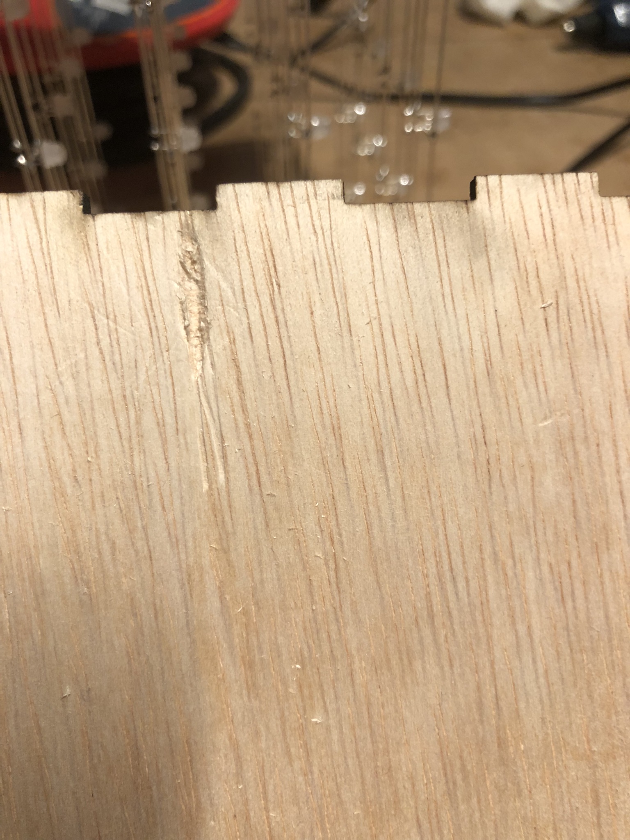
Tech Cube/Documents/Pictures/IMG_8085.JPEG
