MaltWhiskey/Technasium/Tech Cube/Documents/Pictures/IMG_8086.JPEG

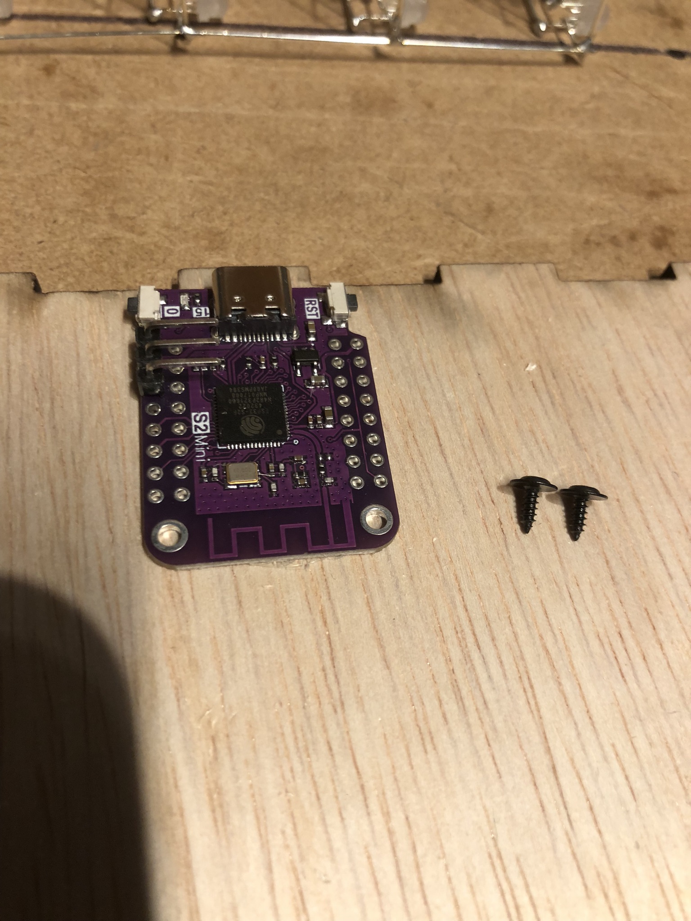
Tech Cube/Documents/Pictures/IMG_8086.JPEG
