MaltWhiskey/Technasium/Tech Cube/Documents/Pictures/IMG_8087.JPEG

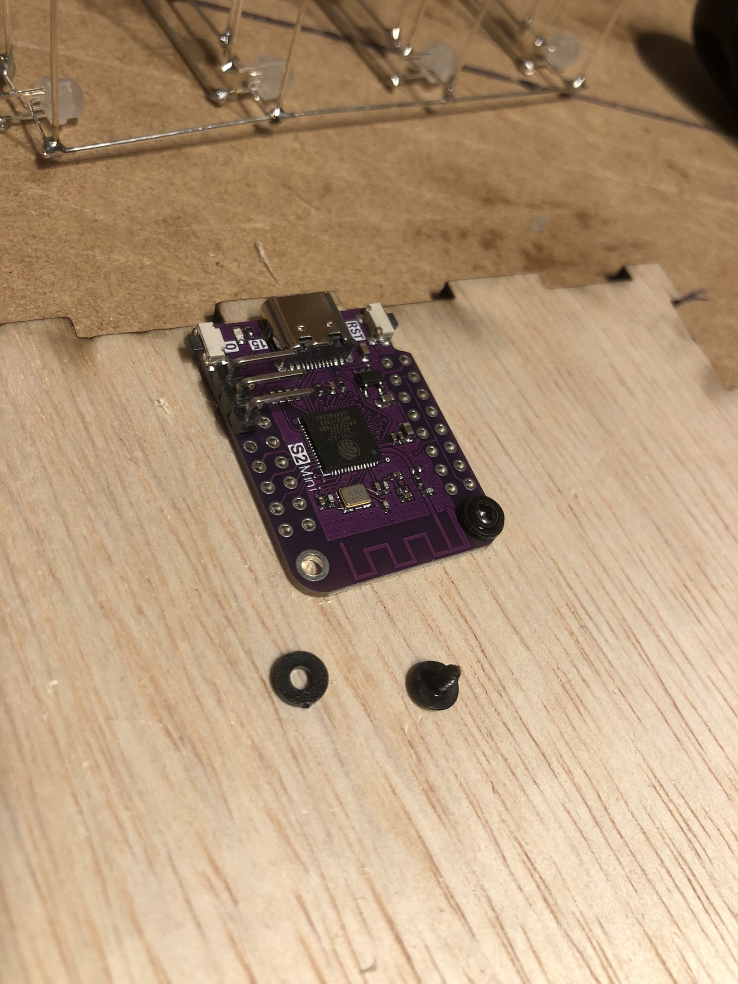
Tech Cube/Documents/Pictures/IMG_8087.JPEG
