MaltWhiskey/Technasium/Tech Cube/Documents/Pictures/IMG_8091.JPEG

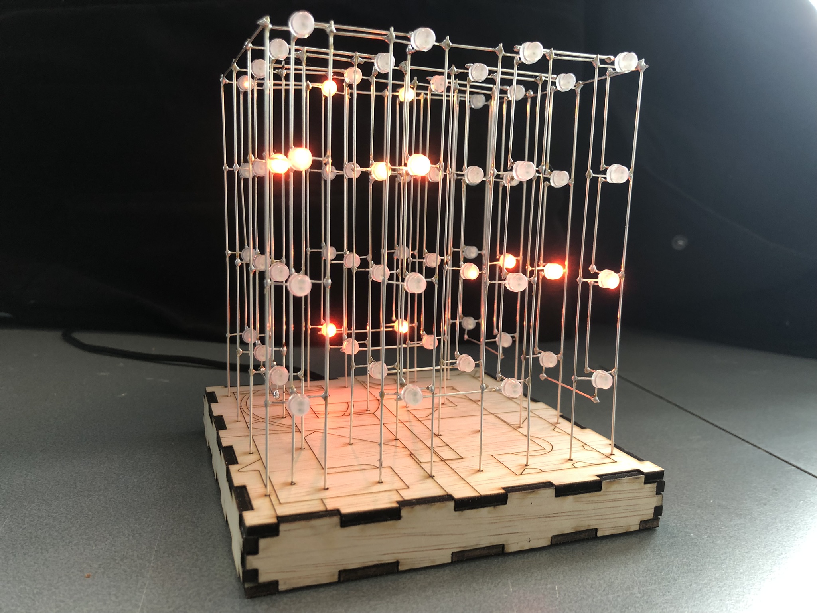
Tech Cube/Documents/Pictures/IMG_8091.JPEG
