MaltWhiskey/Technasium/Tech Cube/Documents/Pictures/IMG_8092.JPEG

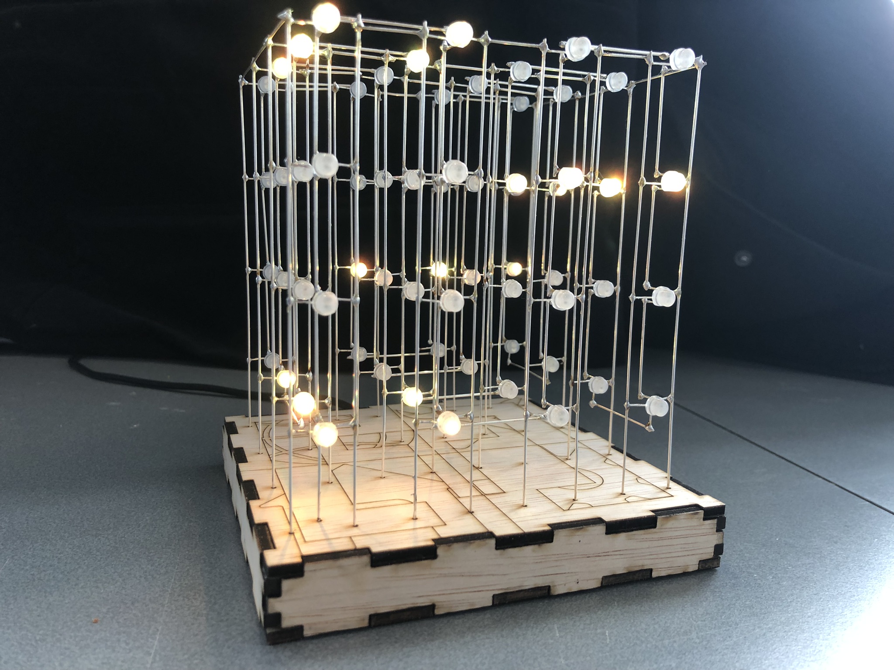
Tech Cube/Documents/Pictures/IMG_8092.JPEG
