MaltWhiskey/Technasium/Tech Cube/Documents/Pictures/IMG_8093.JPEG

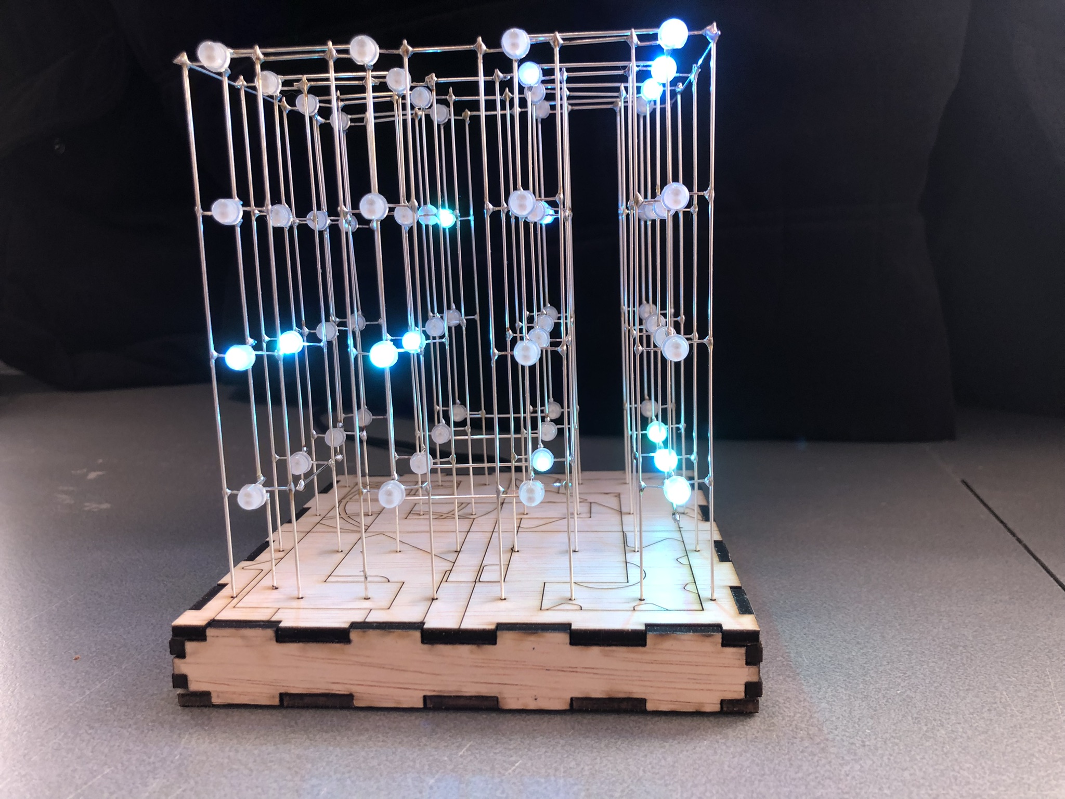
Tech Cube/Documents/Pictures/IMG_8093.JPEG
