MaltWhiskey/Technasium/Tech Cube/Documents/Pictures/IMG_8094.JPEG

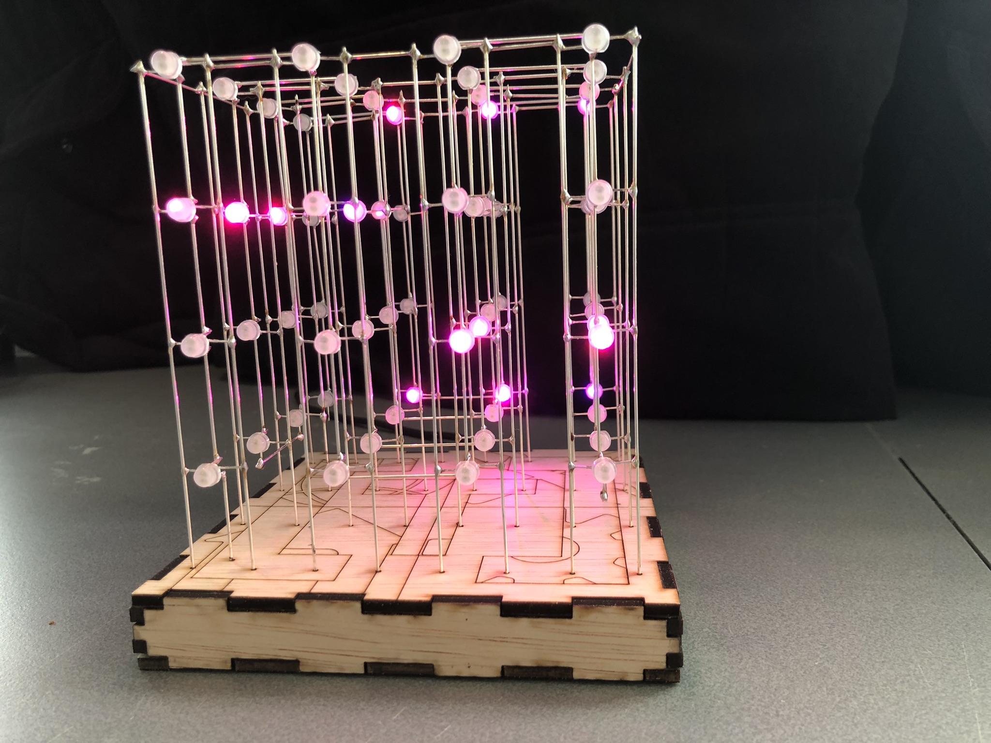
Tech Cube/Documents/Pictures/IMG_8094.JPEG
