MaltWhiskey/Technasium/Tech Cube/Documents/Pictures/IMG_8095.JPEG

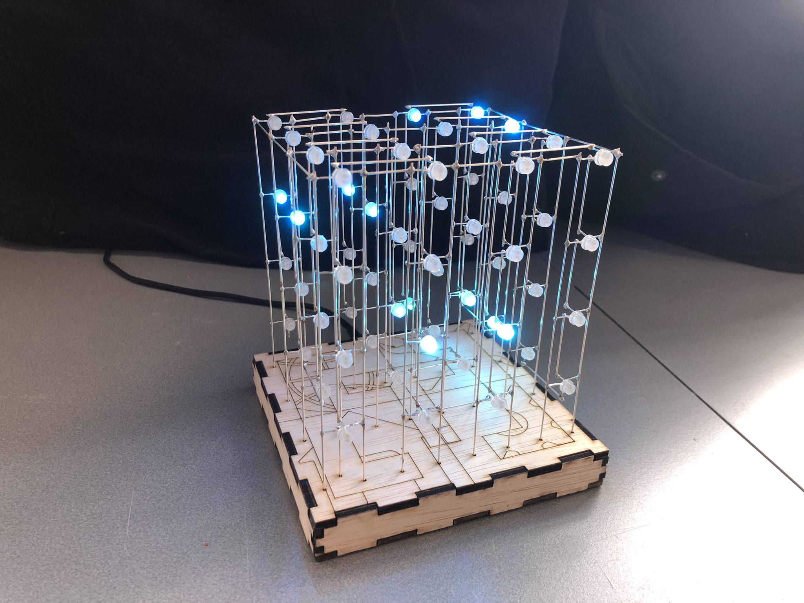
Tech Cube/Documents/Pictures/IMG_8095.JPEG
