MaltWhiskey/Technasium/Tech Cube/Documents/Pictures/IMG_8096.JPEG

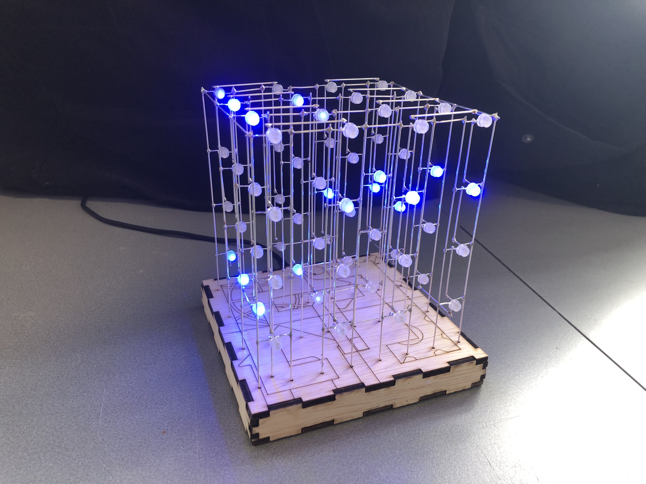
Tech Cube/Documents/Pictures/IMG_8096.JPEG
