MaltWhiskey/Technasium/Tech Cube/Documents/Pictures/IMG_8102.JPEG

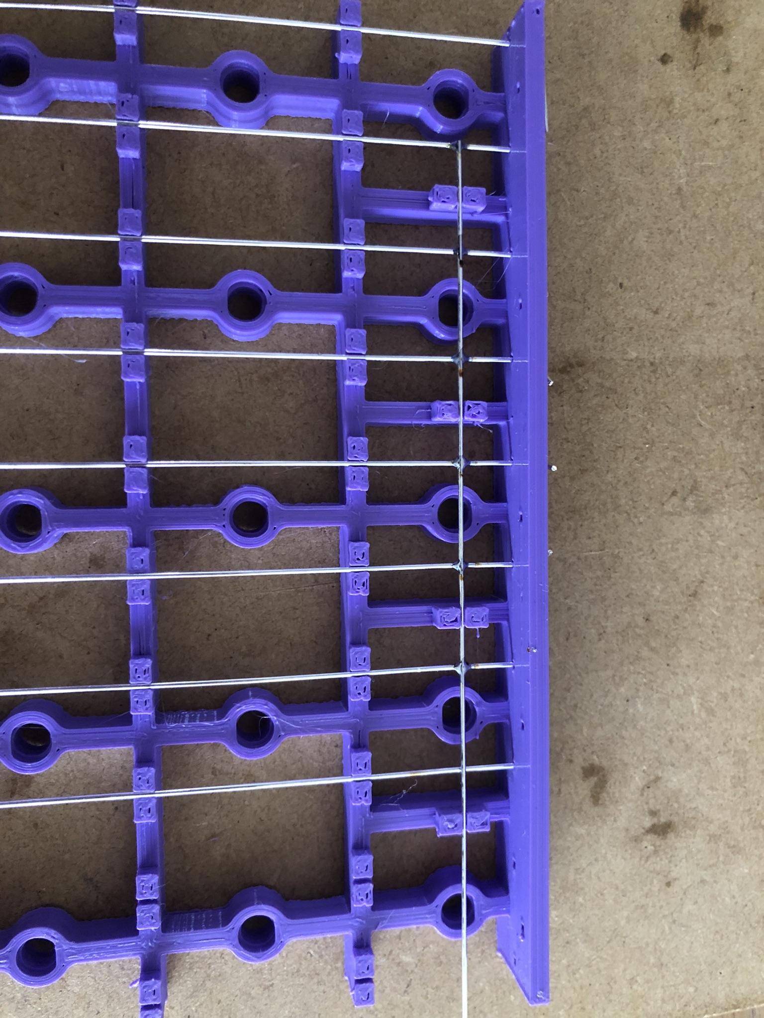
Tech Cube/Documents/Pictures/IMG_8102.JPEG
