MaltWhiskey/Technasium/Tech Cube/Documents/Pictures/IMG_8103.JPEG

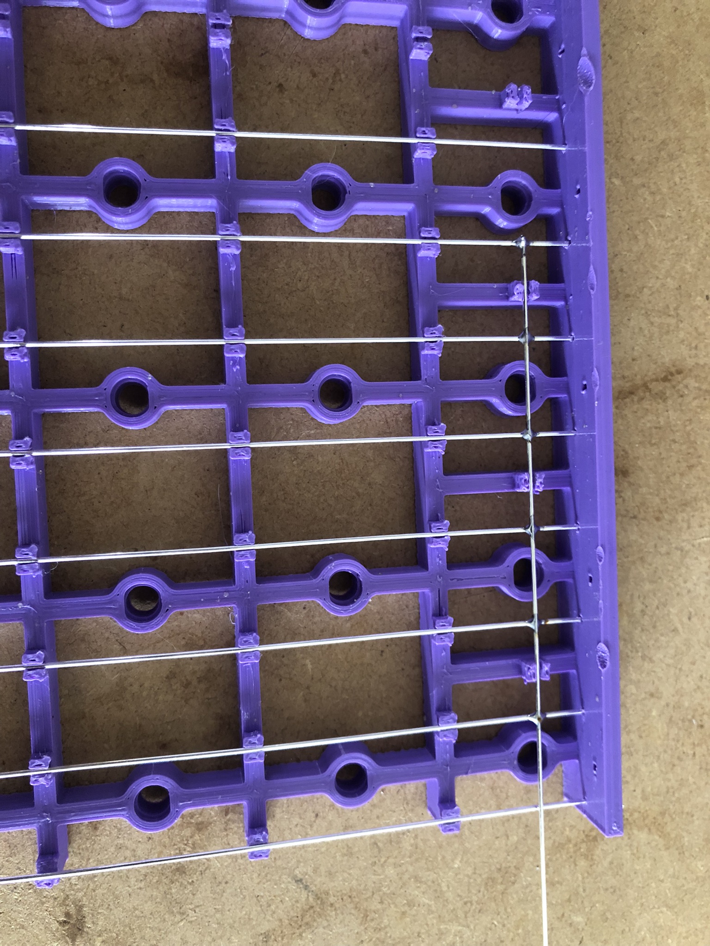
Tech Cube/Documents/Pictures/IMG_8103.JPEG
