MaltWhiskey/Technasium/Tech Cube/Documents/Pictures/IMG_8104.JPEG

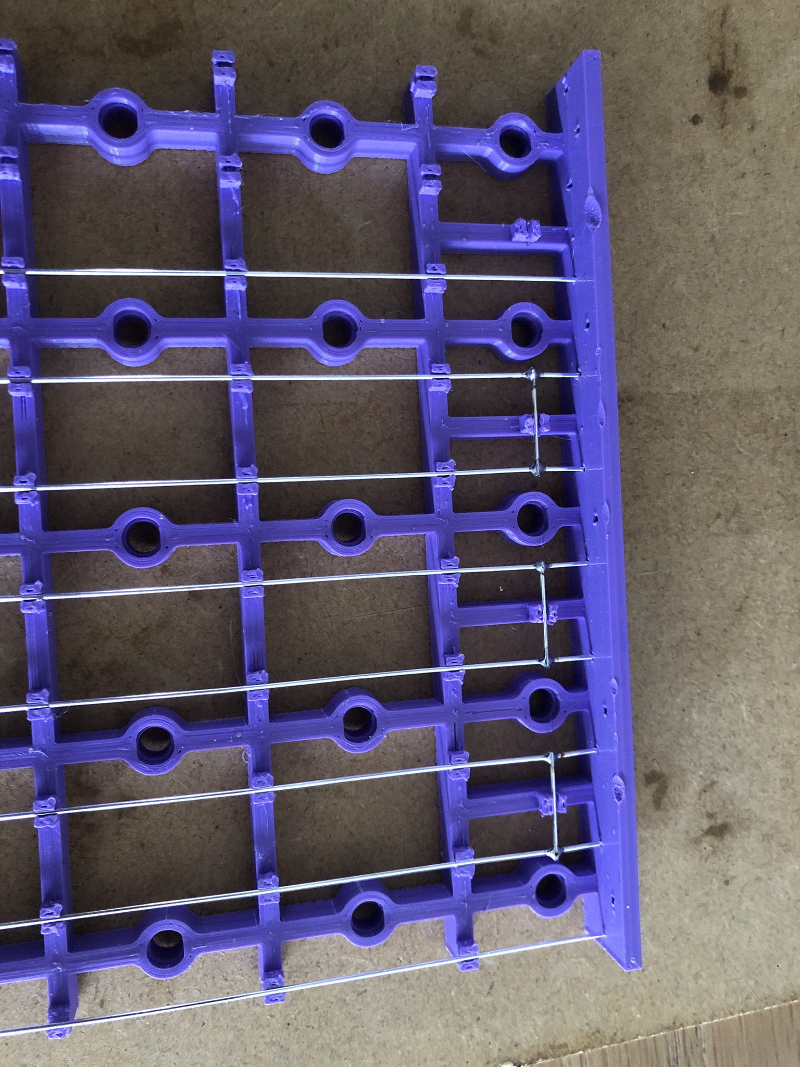
Tech Cube/Documents/Pictures/IMG_8104.JPEG
