MaltWhiskey/Technasium/Tech Cube/Documents/Pictures/IMG_8105.JPEG

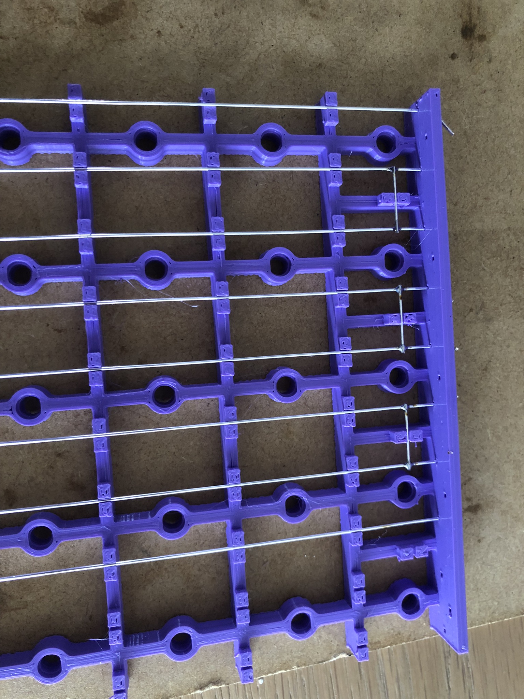
Tech Cube/Documents/Pictures/IMG_8105.JPEG
