MaltWhiskey/Technasium/Tech Cube/Documents/Pictures/IMG_8106.JPEG

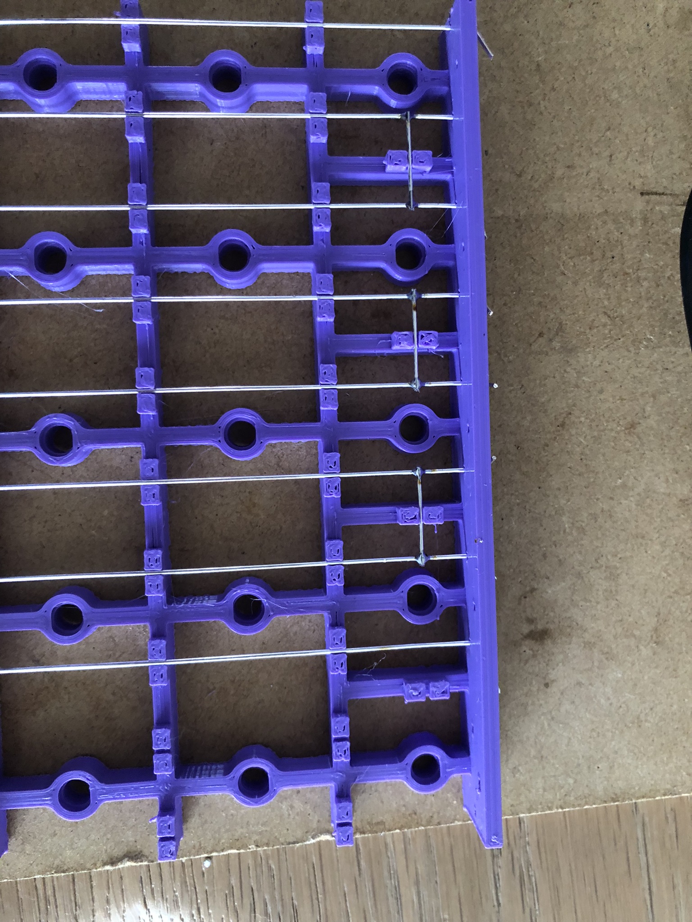
Tech Cube/Documents/Pictures/IMG_8106.JPEG
