MaltWhiskey/Technasium/Tech Cube/Documents/Pictures/IMG_8107.JPEG

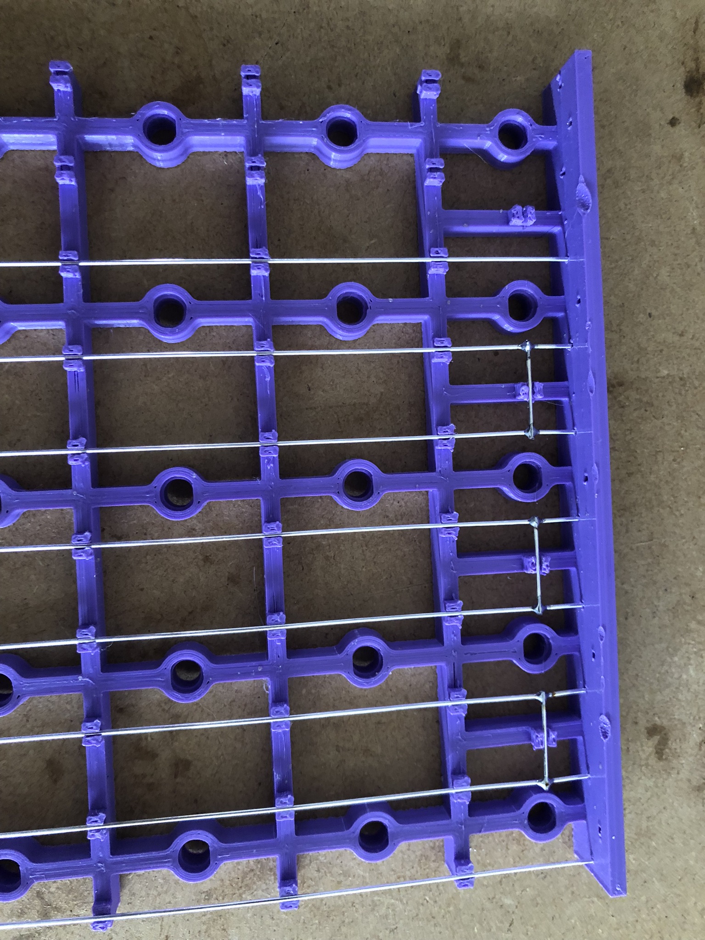
Tech Cube/Documents/Pictures/IMG_8107.JPEG
