MaltWhiskey/Technasium/Tech Cube/Documents/Pictures/IMG_8110.JPEG

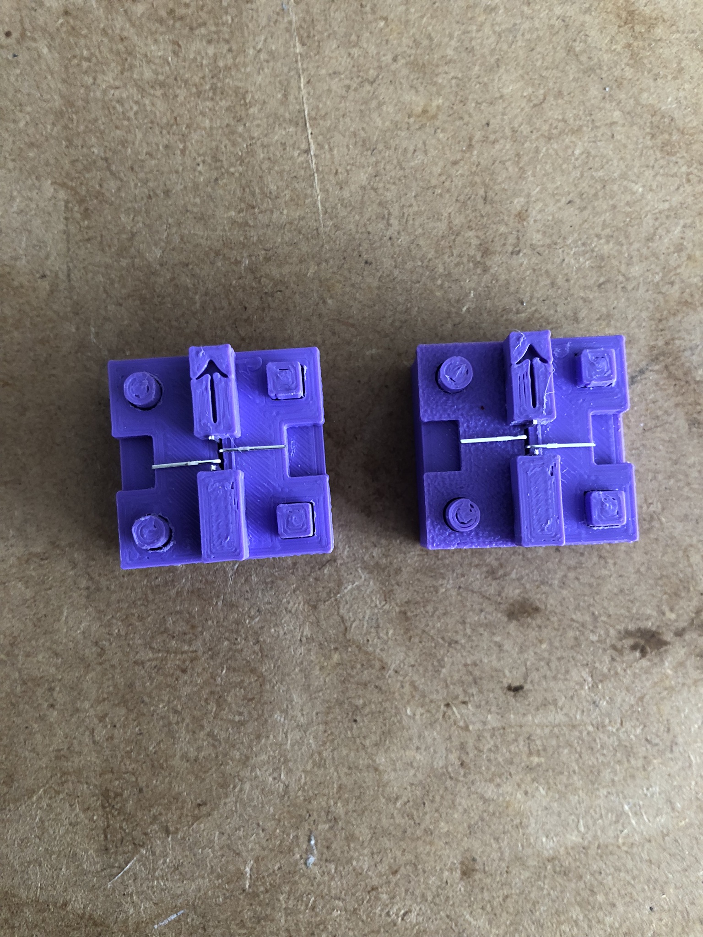
Tech Cube/Documents/Pictures/IMG_8110.JPEG
