MaltWhiskey/Technasium/Tech Cube/Documents/Pictures/IMG_8112.JPEG

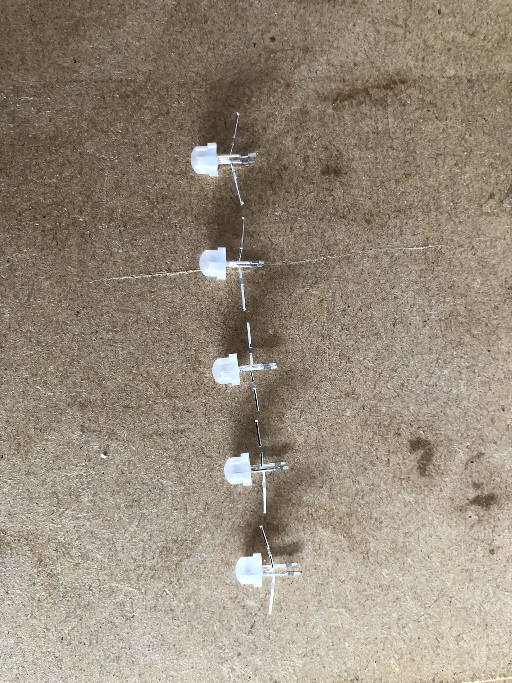
Tech Cube/Documents/Pictures/IMG_8112.JPEG
