MaltWhiskey/Technasium/Tech Cube/Documents/Pictures/IMG_8113.JPEG

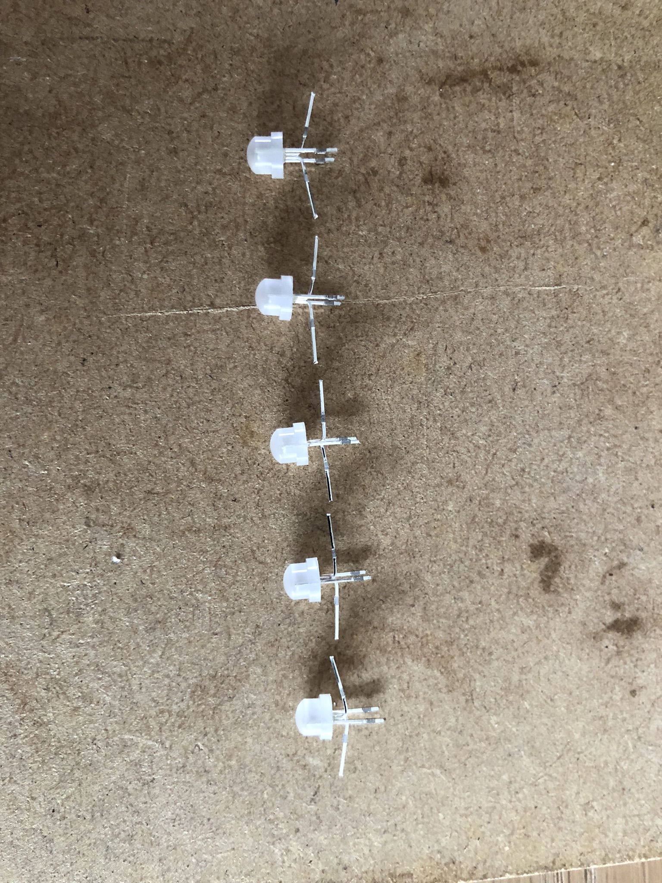
Tech Cube/Documents/Pictures/IMG_8113.JPEG
