MaltWhiskey/Technasium/Tech Cube/Documents/Pictures/IMG_8117.JPEG

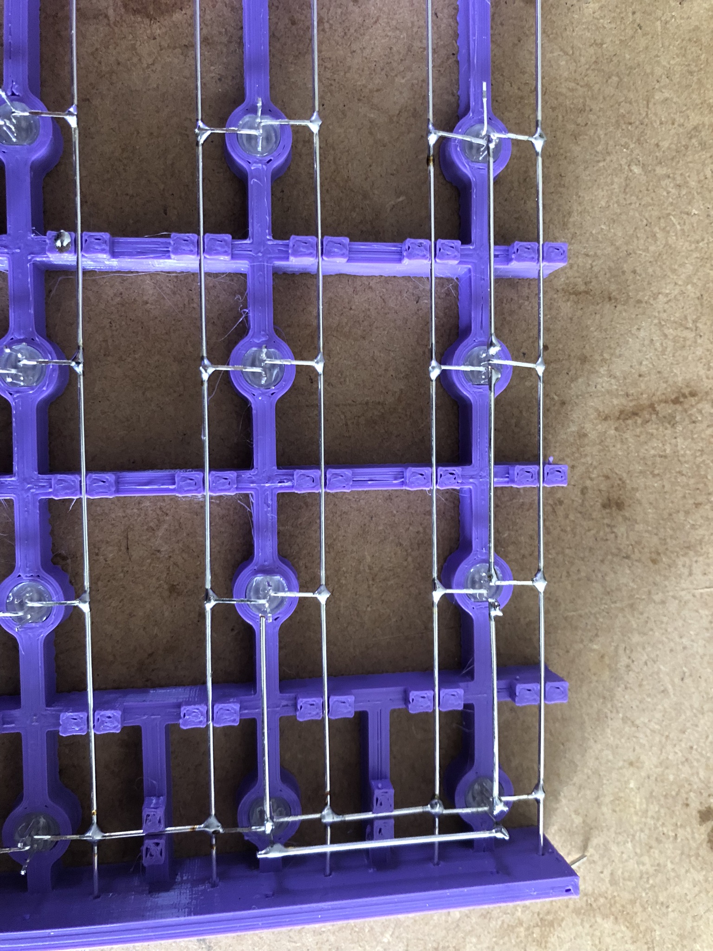
Tech Cube/Documents/Pictures/IMG_8117.JPEG
