MaltWhiskey/Technasium/Tech Cube/Documents/Pictures/IMG_8118.JPEG

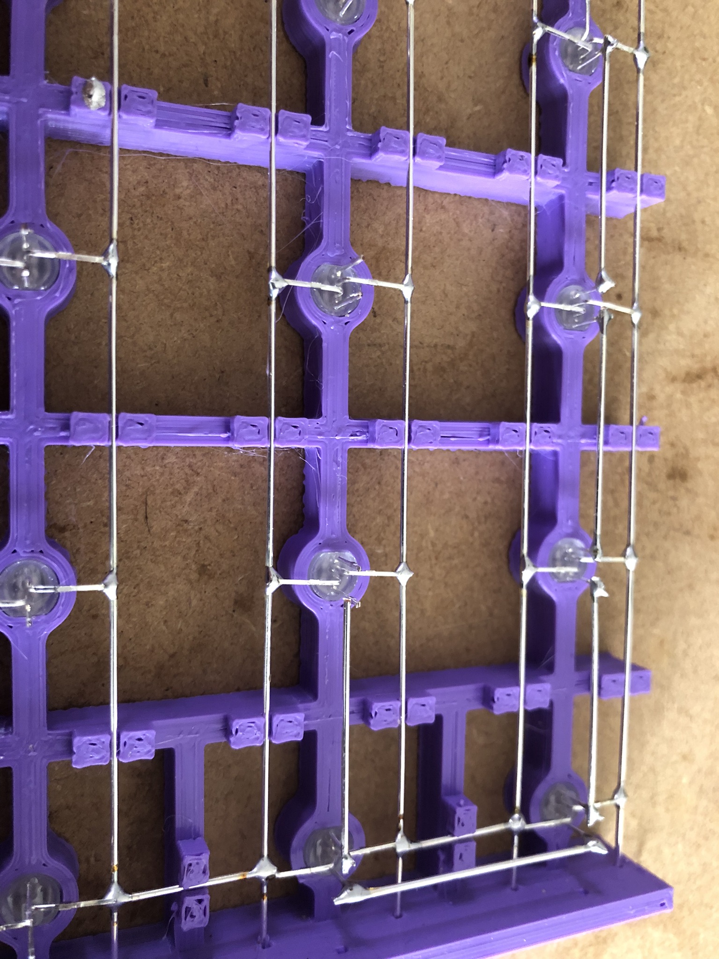
Tech Cube/Documents/Pictures/IMG_8118.JPEG
