MaltWhiskey/Technasium/Tech Cube/Documents/Pictures/IMG_8119.JPEG

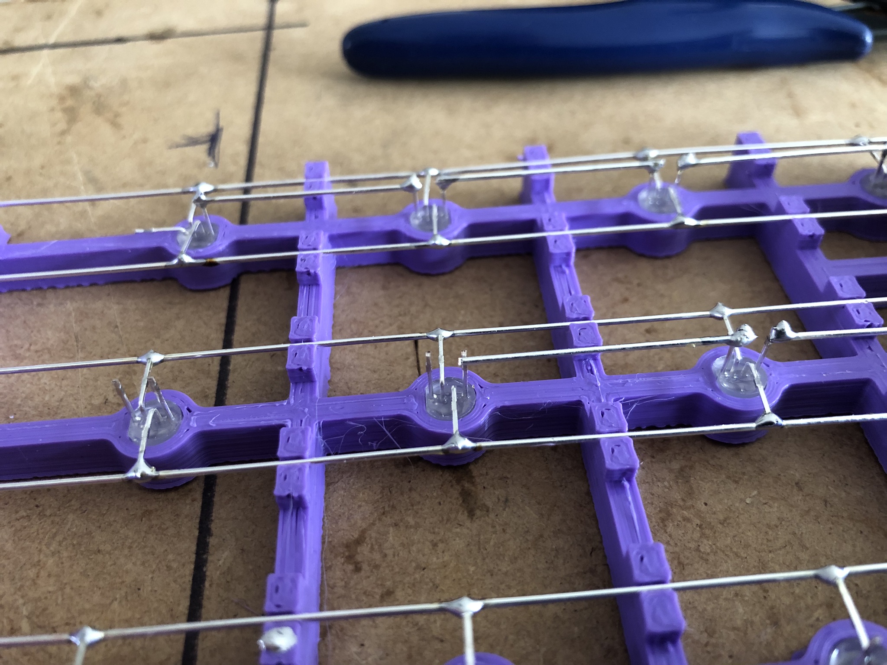
Tech Cube/Documents/Pictures/IMG_8119.JPEG
