MaltWhiskey/Technasium/Tech Cube/Documents/Pictures/IMG_8120.JPEG

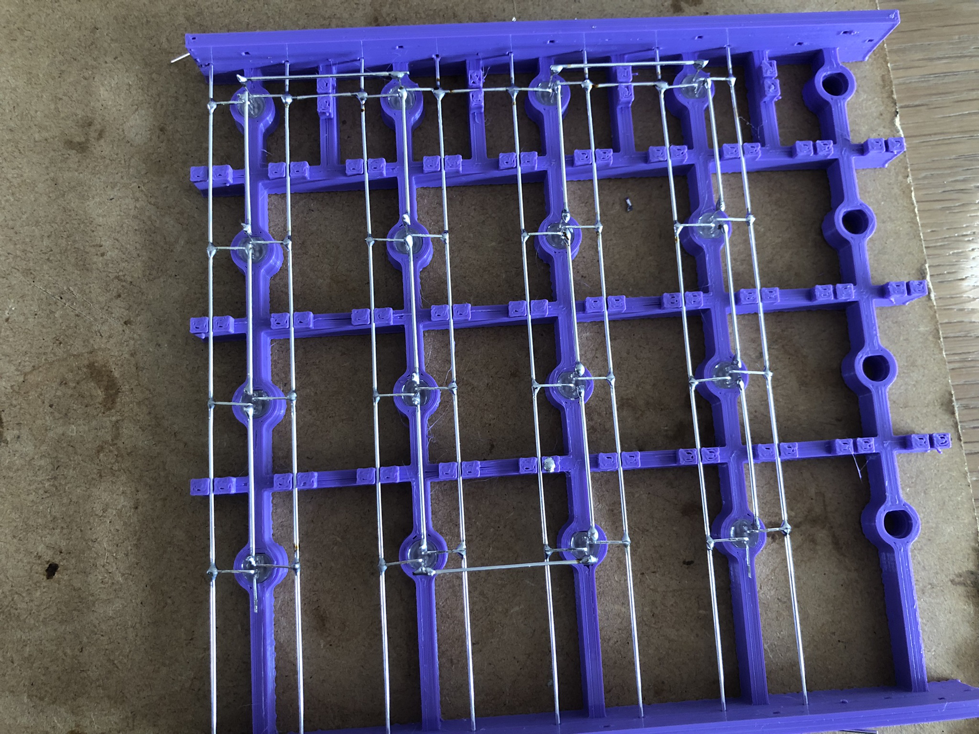
Tech Cube/Documents/Pictures/IMG_8120.JPEG
