MaltWhiskey/Technasium/Tech Cube/Documents/Pictures/IMG_8121.JPEG

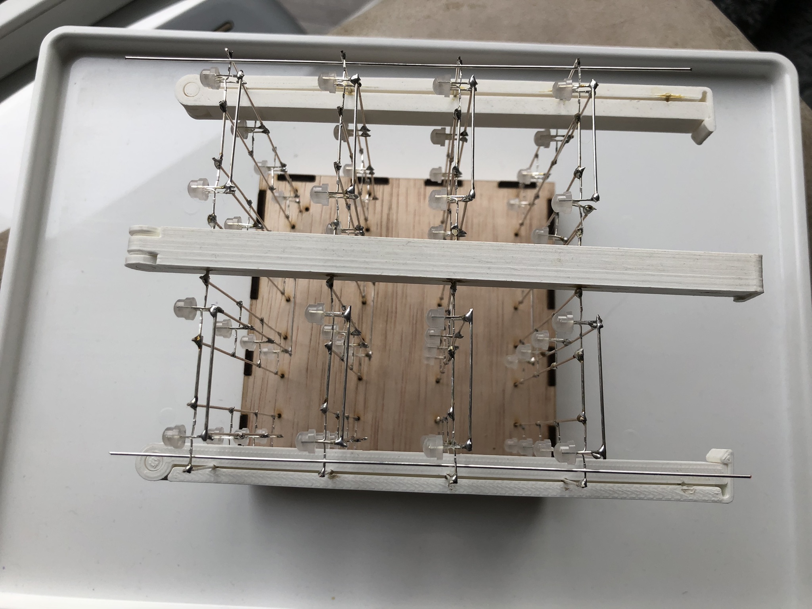
Tech Cube/Documents/Pictures/IMG_8121.JPEG
