MaltWhiskey/Technasium/Tech Cube/Documents/Pictures/IMG_8123.JPEG

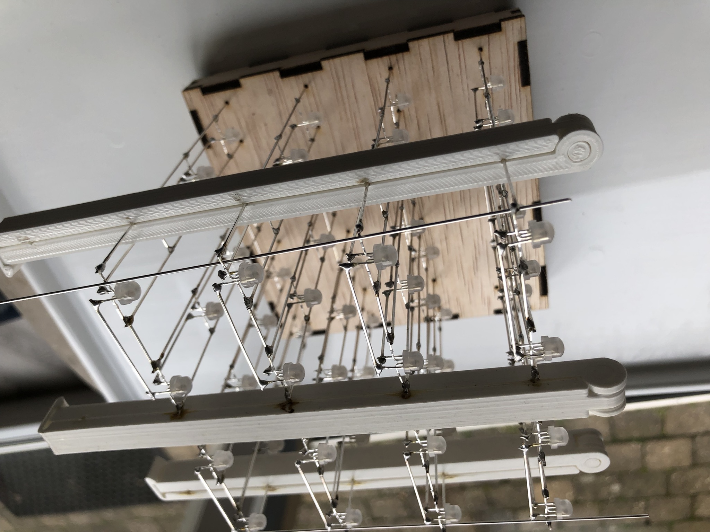
Tech Cube/Documents/Pictures/IMG_8123.JPEG
