MaltWhiskey/Technasium/Tech Cube/Documents/Pictures/IMG_8124.JPEG

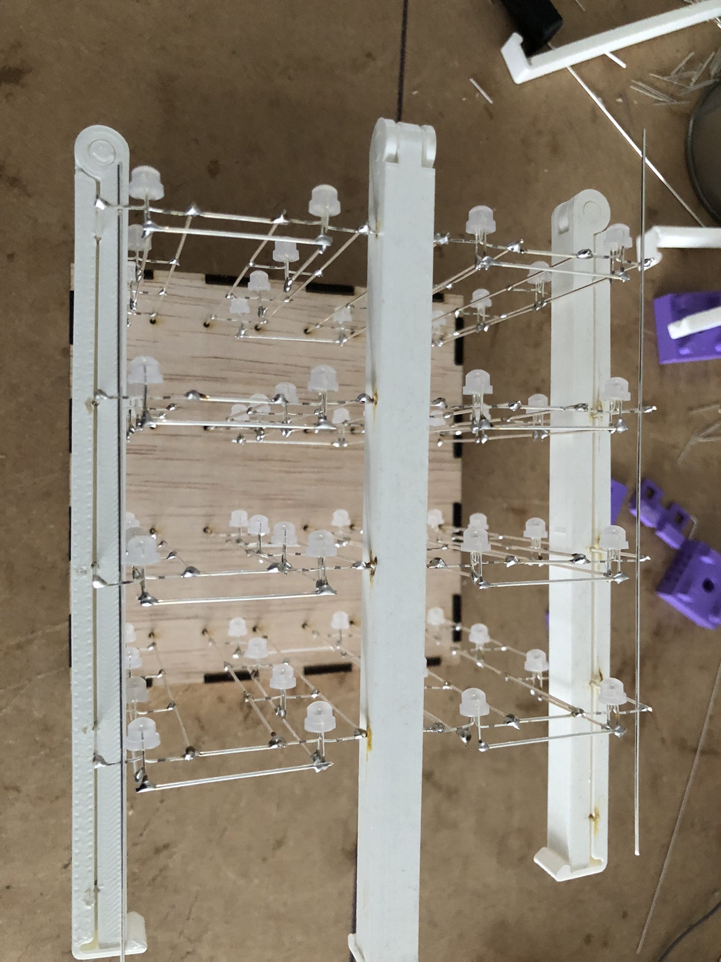
Tech Cube/Documents/Pictures/IMG_8124.JPEG
