MaltWhiskey/Technasium/Tech Cube/Documents/Pictures/IMG_8125.JPEG

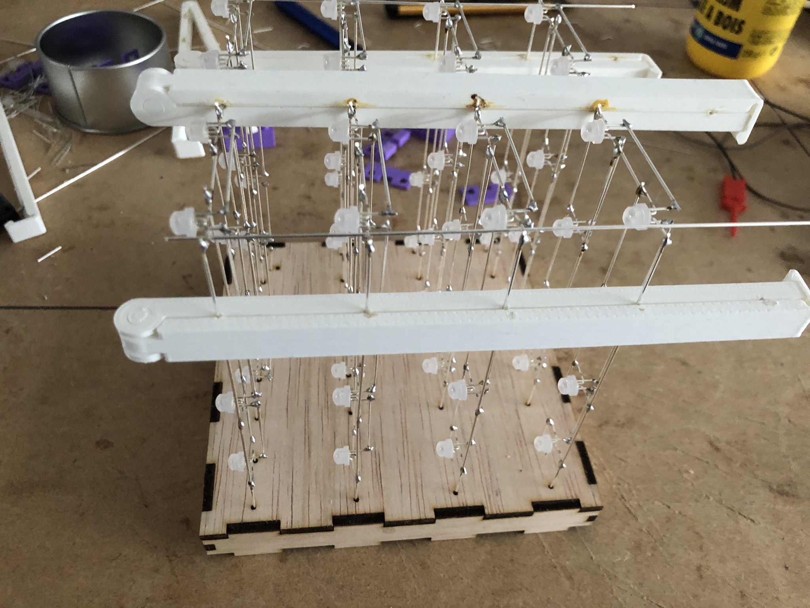
Tech Cube/Documents/Pictures/IMG_8125.JPEG
