MaltWhiskey/Technasium/Tech Cube/Documents/Pictures/IMG_8126.JPEG

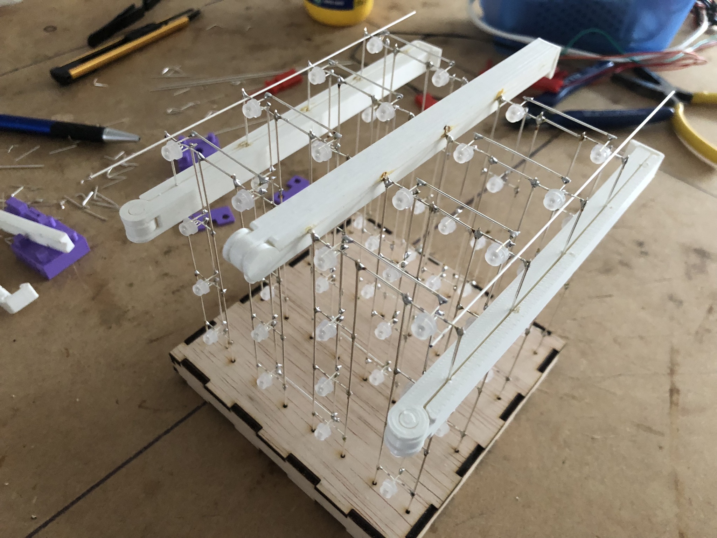
Tech Cube/Documents/Pictures/IMG_8126.JPEG
