MaltWhiskey/Technasium/Tech Cube/Documents/Pictures/IMG_8129.JPEG

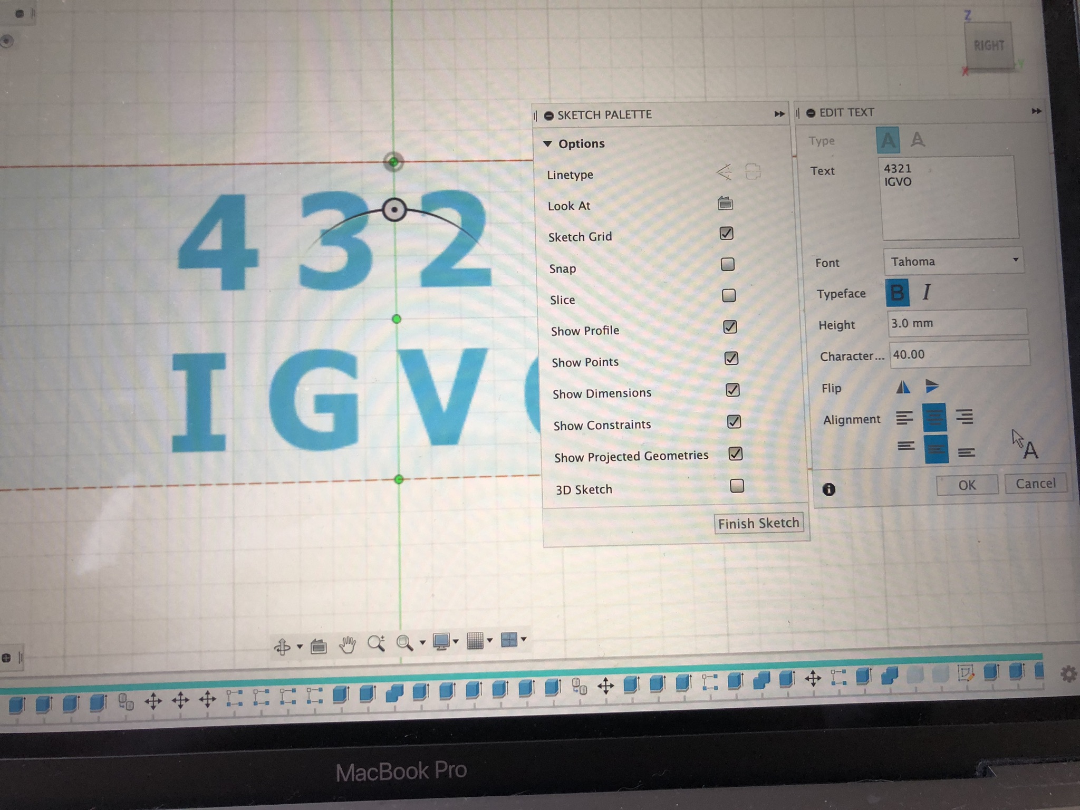
Tech Cube/Documents/Pictures/IMG_8129.JPEG
