MaltWhiskey/Technasium/Tech Cube/Documents/Pictures/IMG_8130.JPEG

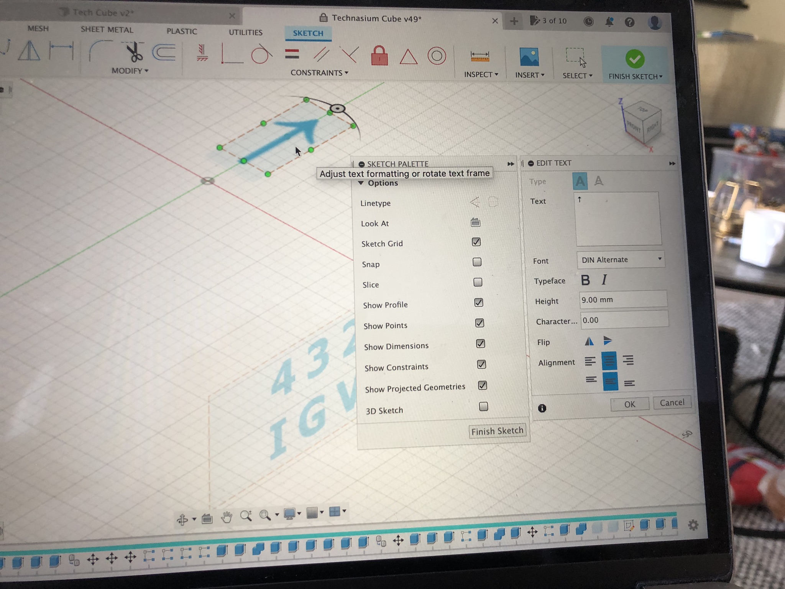
Tech Cube/Documents/Pictures/IMG_8130.JPEG
