MaltWhiskey/Technasium/Tech Cube/Documents/Pictures/IMG_8151.JPEG

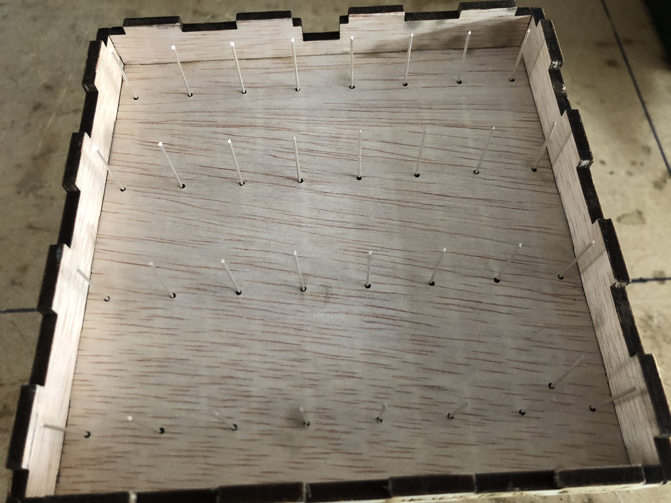
Tech Cube/Documents/Pictures/IMG_8151.JPEG
