MaltWhiskey/Technasium/Tech Cube/Documents/Pictures/IMG_8152.JPEG

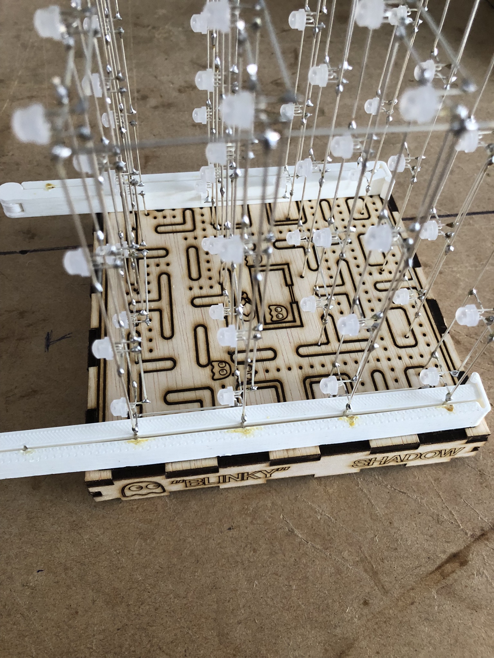
Tech Cube/Documents/Pictures/IMG_8152.JPEG
