MaltWhiskey/Technasium/Tech Cube/Documents/Pictures/IMG_8153.JPEG

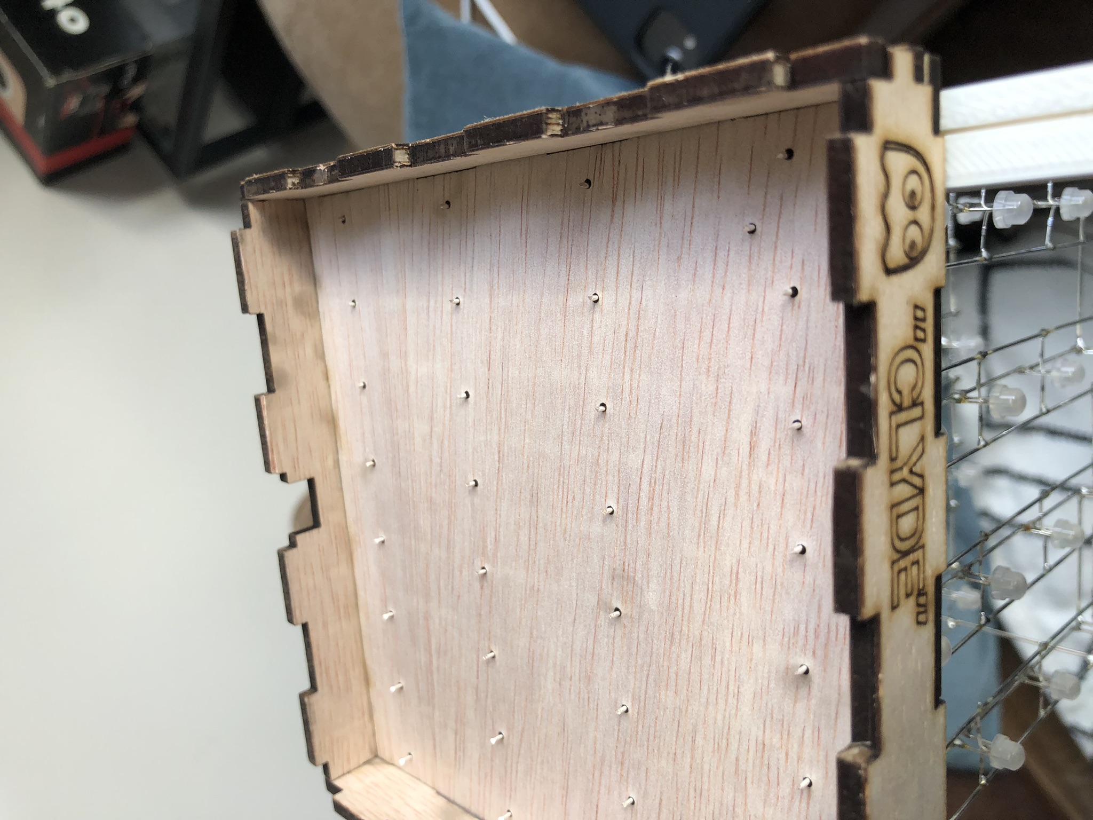
Tech Cube/Documents/Pictures/IMG_8153.JPEG
