MaltWhiskey/Technasium/Tech Cube/Documents/Pictures/IMG_8154.JPEG

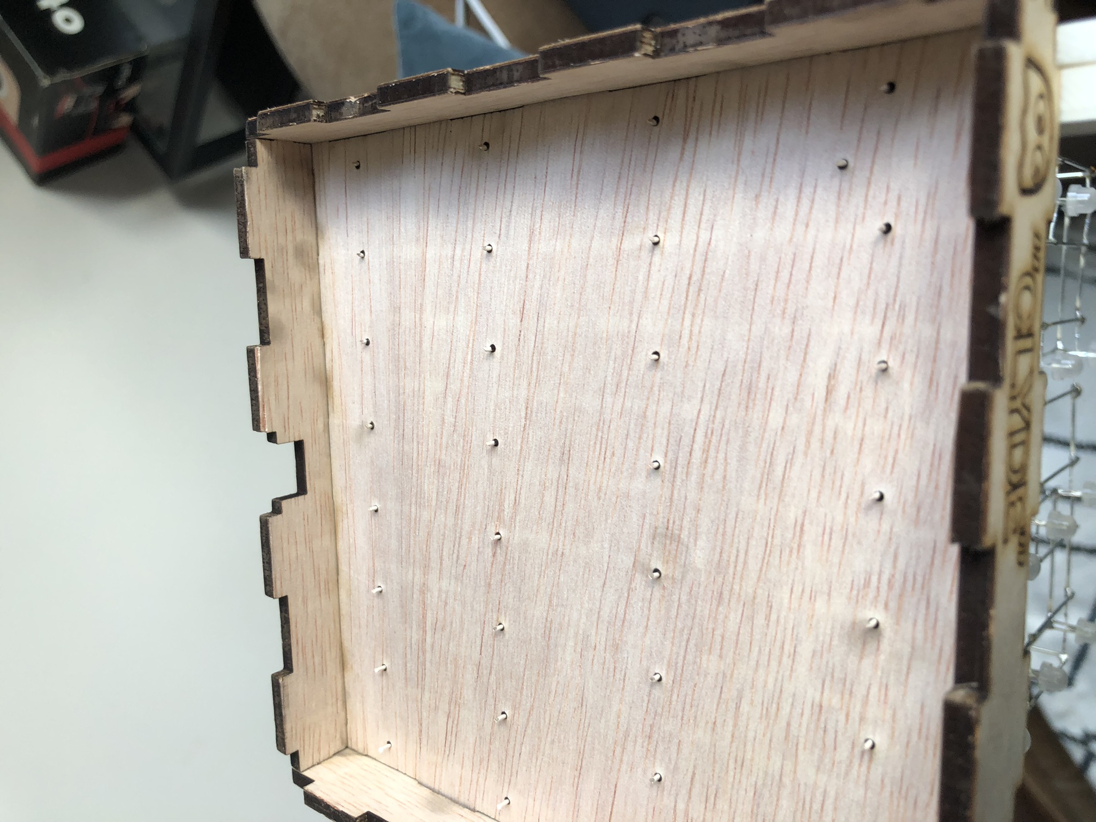
Tech Cube/Documents/Pictures/IMG_8154.JPEG
