MaltWhiskey/Technasium/Tech Cube/Documents/Pictures/IMG_8155.JPEG

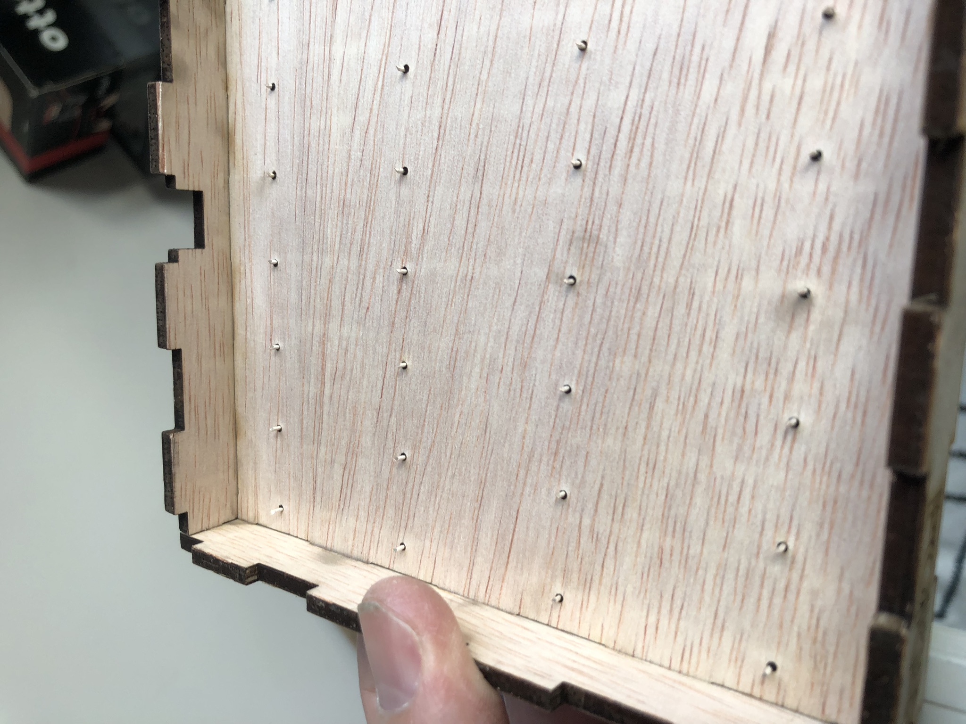
Tech Cube/Documents/Pictures/IMG_8155.JPEG
