MaltWhiskey/Technasium/Tech Cube/Documents/Pictures/IMG_8156.JPEG

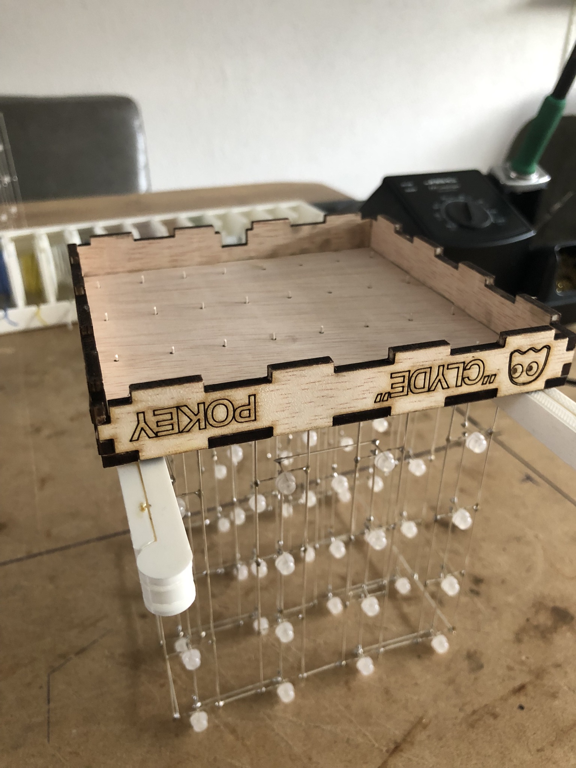
Tech Cube/Documents/Pictures/IMG_8156.JPEG
