MaltWhiskey/Technasium/Tech Cube/Documents/Pictures/IMG_8157.JPEG

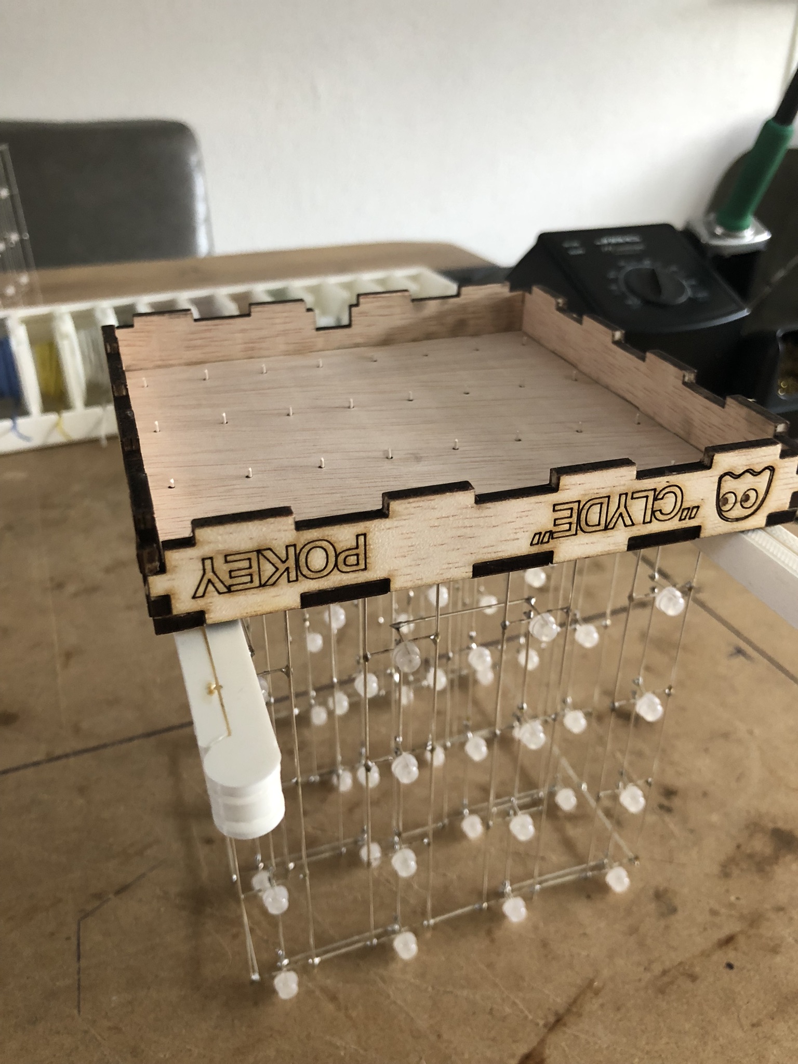
Tech Cube/Documents/Pictures/IMG_8157.JPEG
