MaltWhiskey/Technasium/Tech Cube/Documents/Pictures/IMG_8158.JPEG

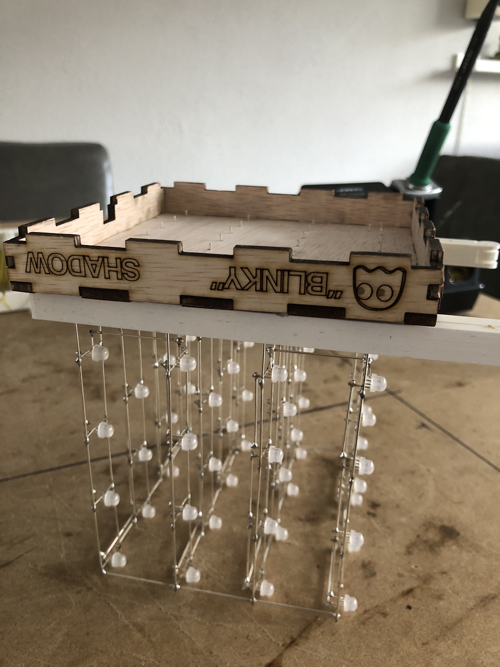
Tech Cube/Documents/Pictures/IMG_8158.JPEG
