MaltWhiskey/Technasium/Tech Cube/Documents/Pictures/IMG_8159.JPEG

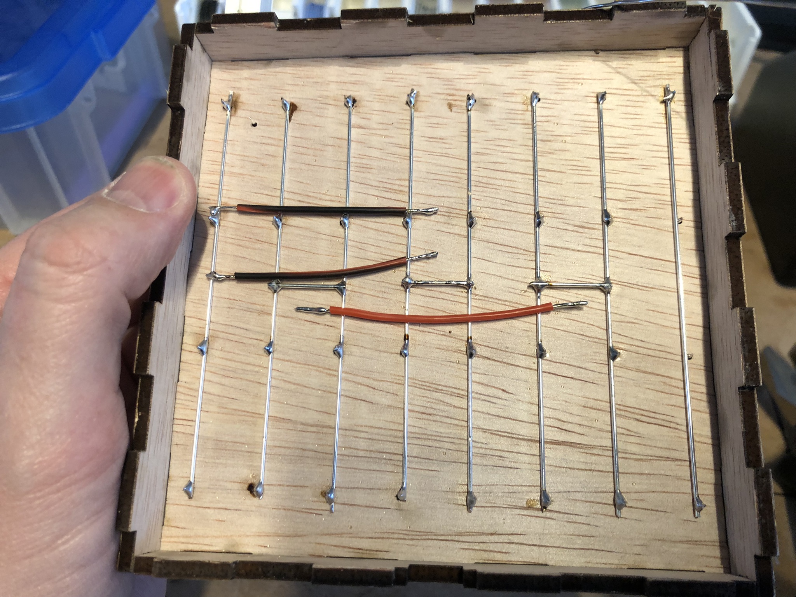
Tech Cube/Documents/Pictures/IMG_8159.JPEG
