MaltWhiskey/Technasium/Tech Cube/Documents/Pictures/IMG_8160.JPEG

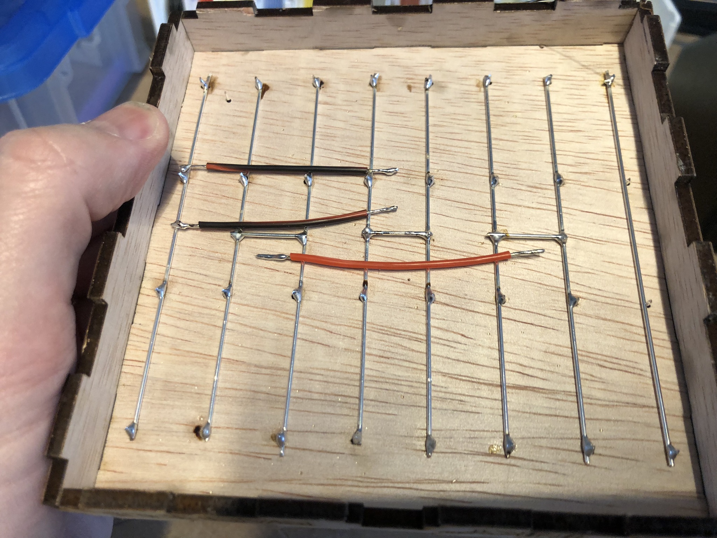
Tech Cube/Documents/Pictures/IMG_8160.JPEG
