MaltWhiskey/Technasium/Tech Cube/Documents/Pictures/IMG_8161.JPEG

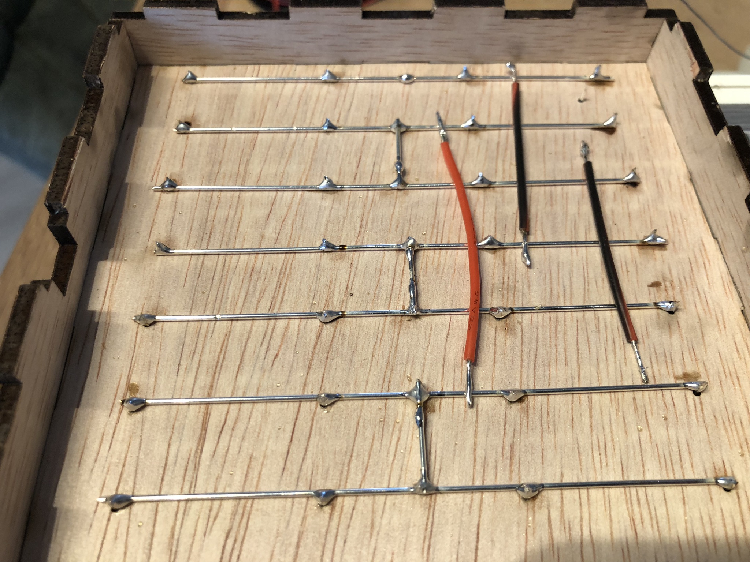
Tech Cube/Documents/Pictures/IMG_8161.JPEG
