MaltWhiskey/Technasium/Tech Cube/Documents/Pictures/IMG_8162.JPEG

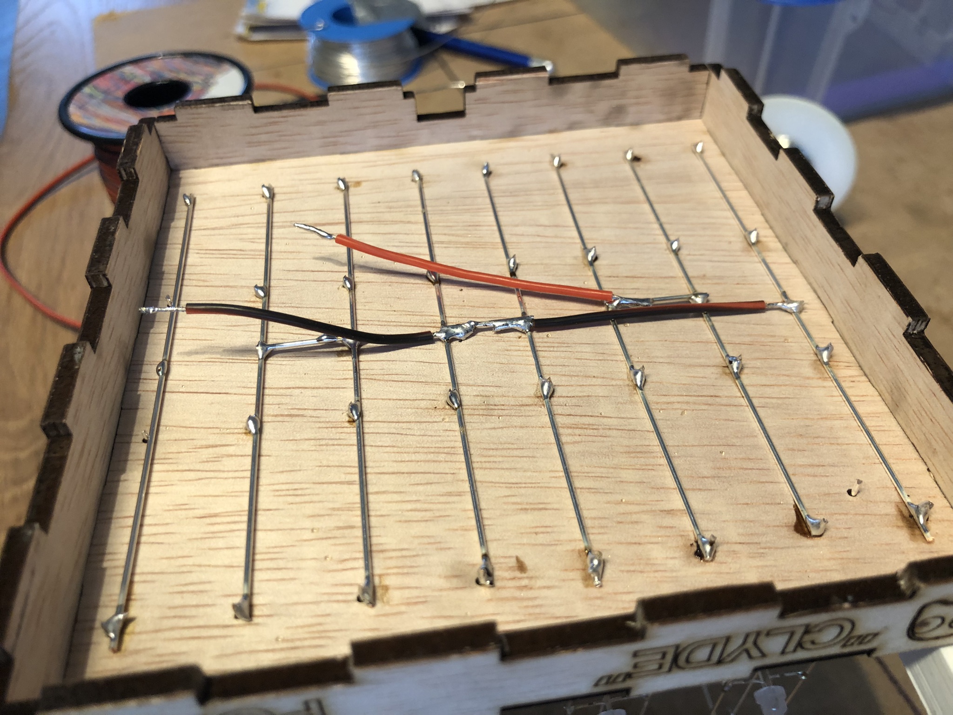
Tech Cube/Documents/Pictures/IMG_8162.JPEG
