MaltWhiskey/Technasium/Tech Cube/Documents/Pictures/IMG_8163.JPEG

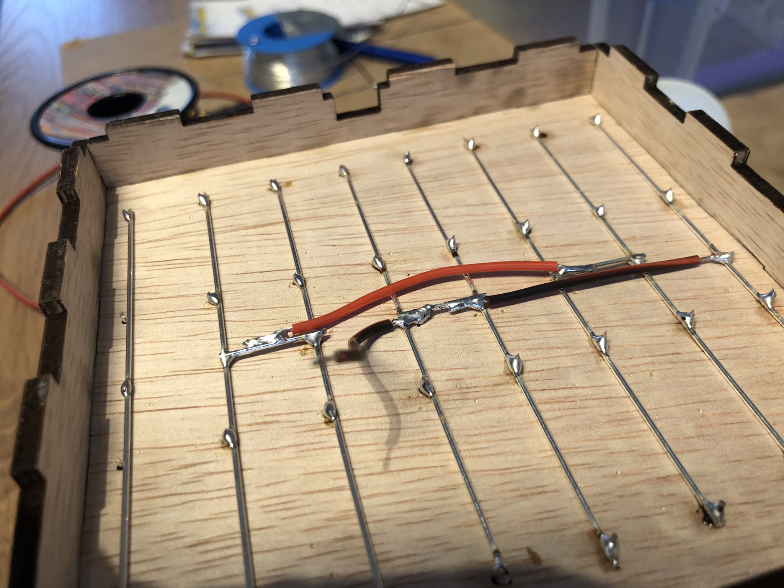
Tech Cube/Documents/Pictures/IMG_8163.JPEG
