MaltWhiskey/Technasium/Tech Cube/Documents/Pictures/IMG_8164.JPEG

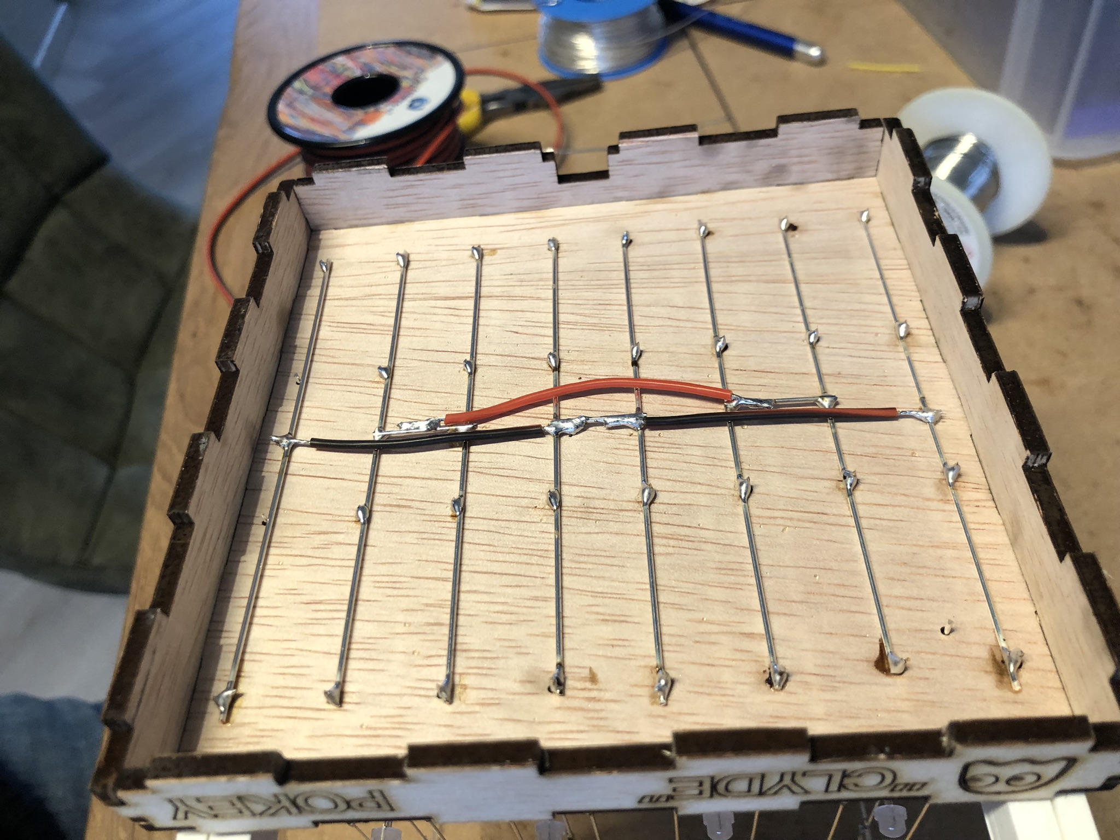
Tech Cube/Documents/Pictures/IMG_8164.JPEG
