MaltWhiskey/Technasium/Tech Cube/Documents/Pictures/IMG_8165.JPEG

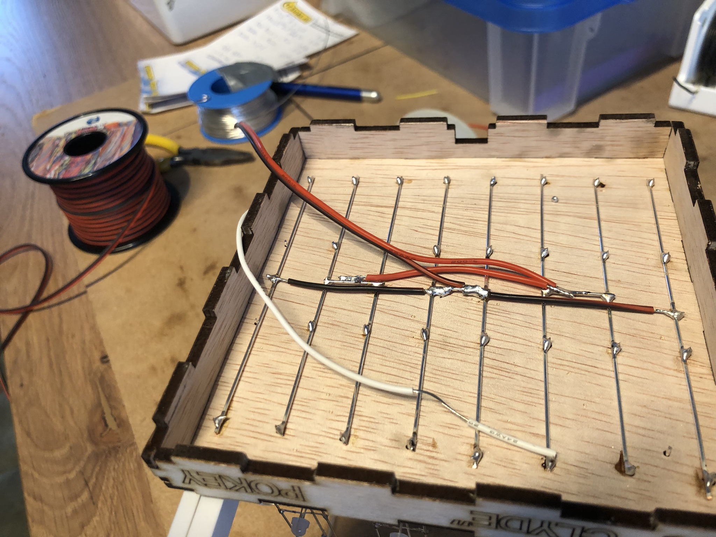
Tech Cube/Documents/Pictures/IMG_8165.JPEG
