MaltWhiskey/Technasium/Tech Cube/Documents/Pictures/IMG_8166.JPEG

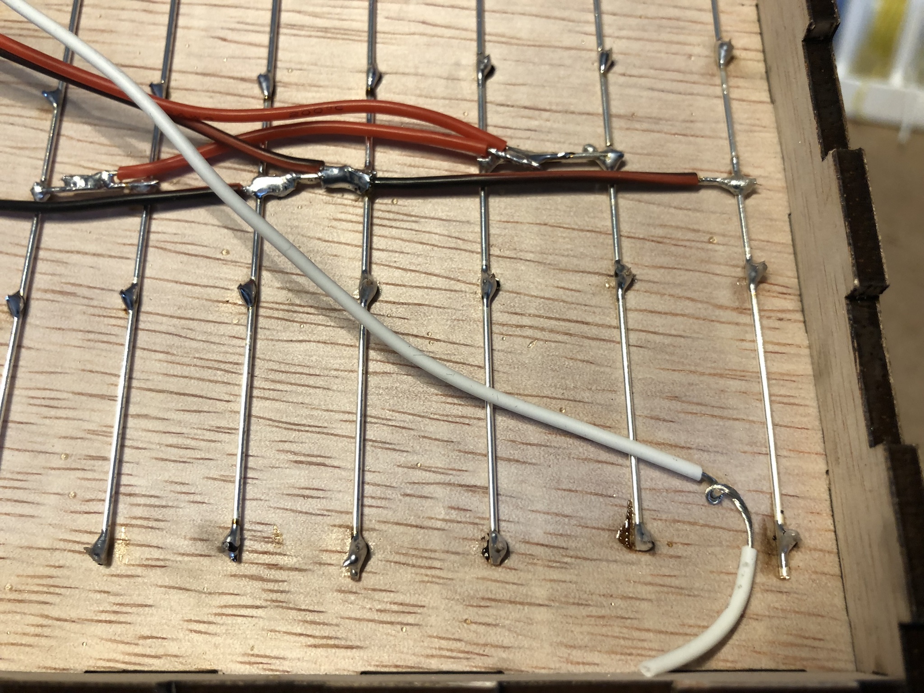
Tech Cube/Documents/Pictures/IMG_8166.JPEG
