MaltWhiskey/Technasium/Tech Cube/Documents/Pictures/IMG_8167.JPEG

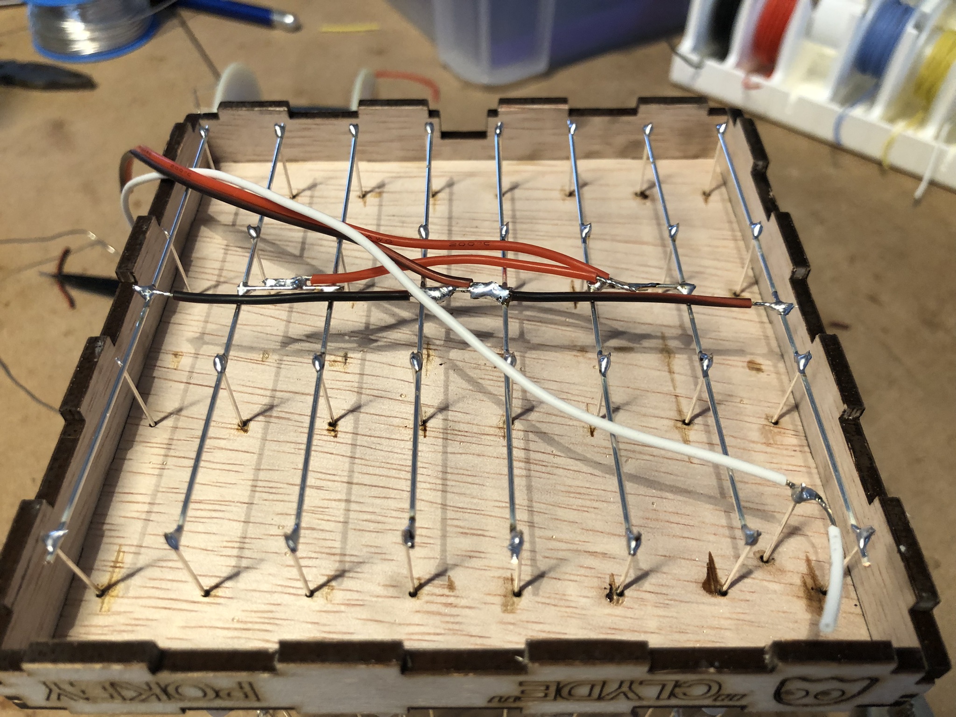
Tech Cube/Documents/Pictures/IMG_8167.JPEG
