MaltWhiskey/Technasium/Tech Cube/Documents/Pictures/IMG_8168.JPEG

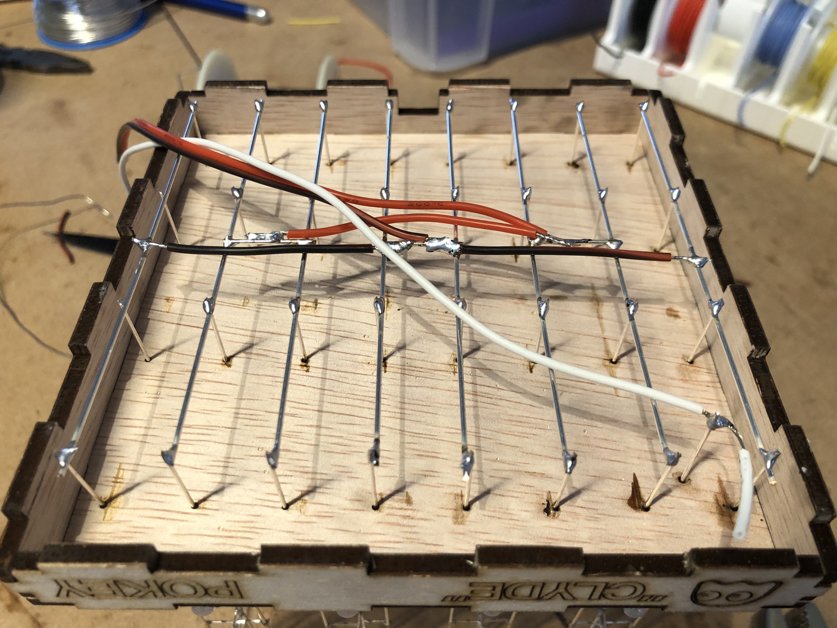
Tech Cube/Documents/Pictures/IMG_8168.JPEG
