MaltWhiskey/Technasium/Tech Cube/Documents/Pictures/IMG_8209.jpeg

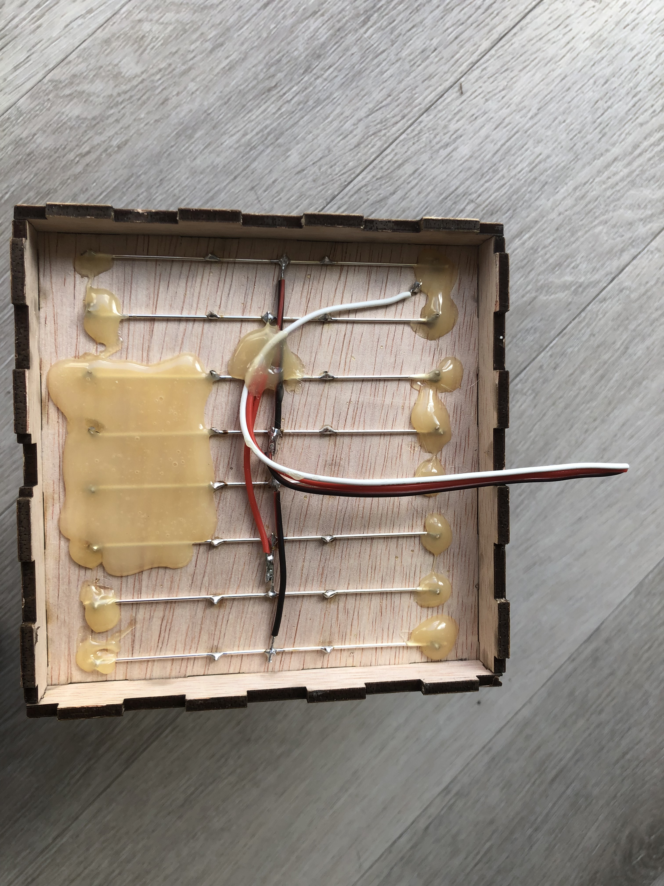
Tech Cube/Documents/Pictures/IMG_8209.jpeg
