MaltWhiskey/Technasium/Tech Cube/Documents/Pictures/IMG_8210.jpeg

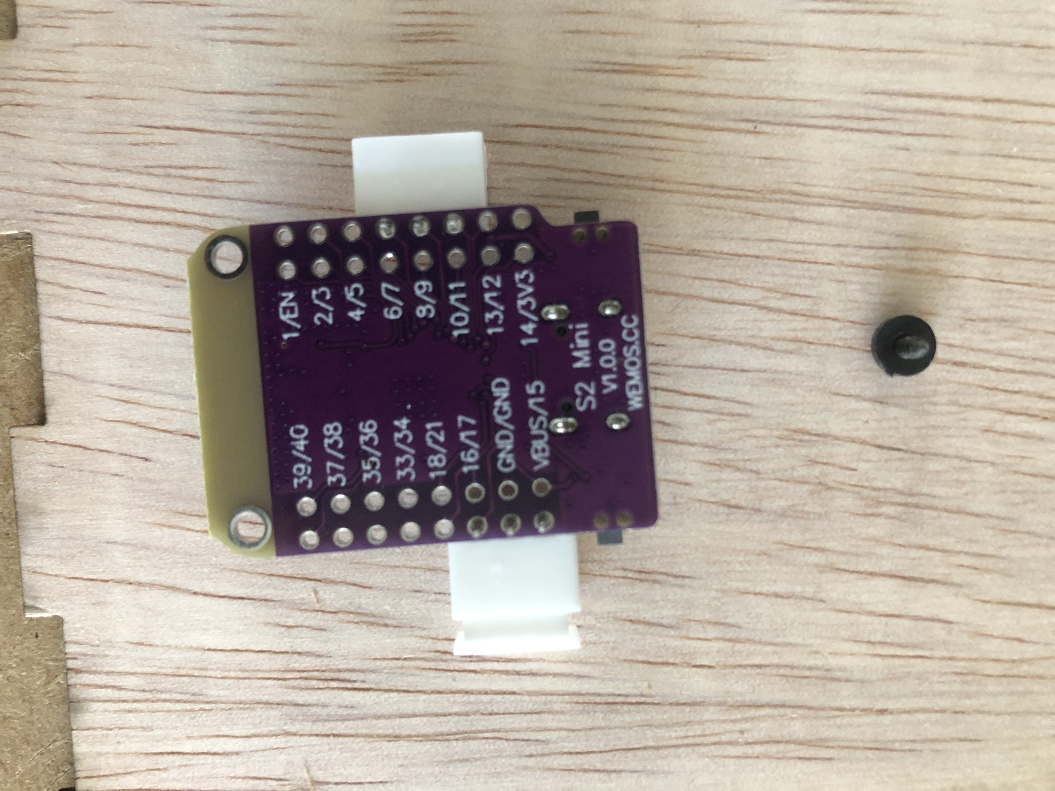
Tech Cube/Documents/Pictures/IMG_8210.jpeg
