MaltWhiskey/Technasium/Tech Cube/Documents/Pictures/IMG_8211.jpeg

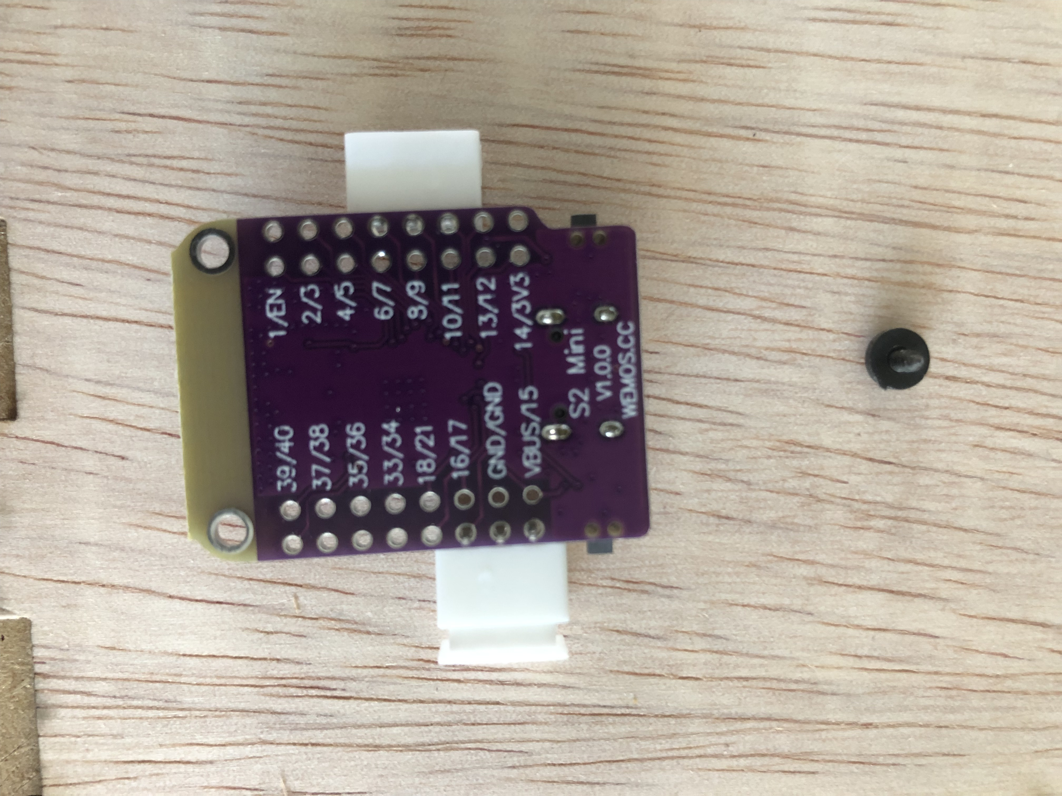
Tech Cube/Documents/Pictures/IMG_8211.jpeg
