MaltWhiskey/Technasium/Tech Cube/Documents/Pictures/IMG_8212.jpeg

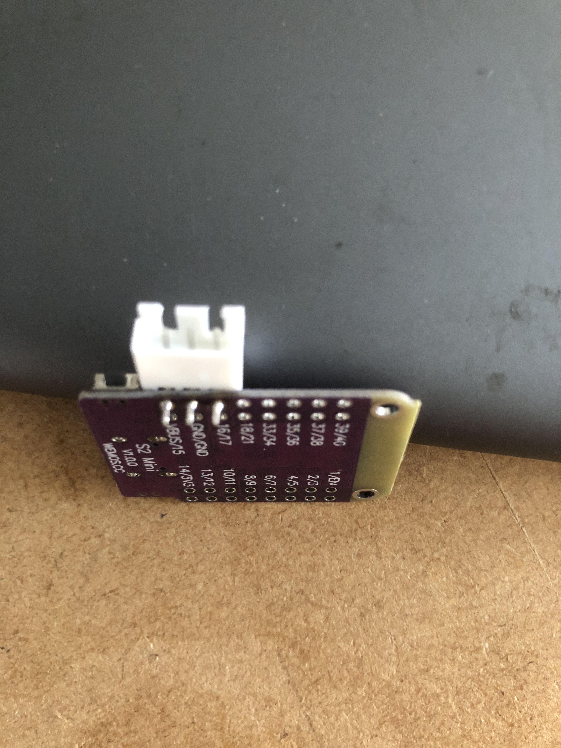
Tech Cube/Documents/Pictures/IMG_8212.jpeg
