MaltWhiskey/Technasium/Tech Cube/Documents/Pictures/IMG_8213.jpeg

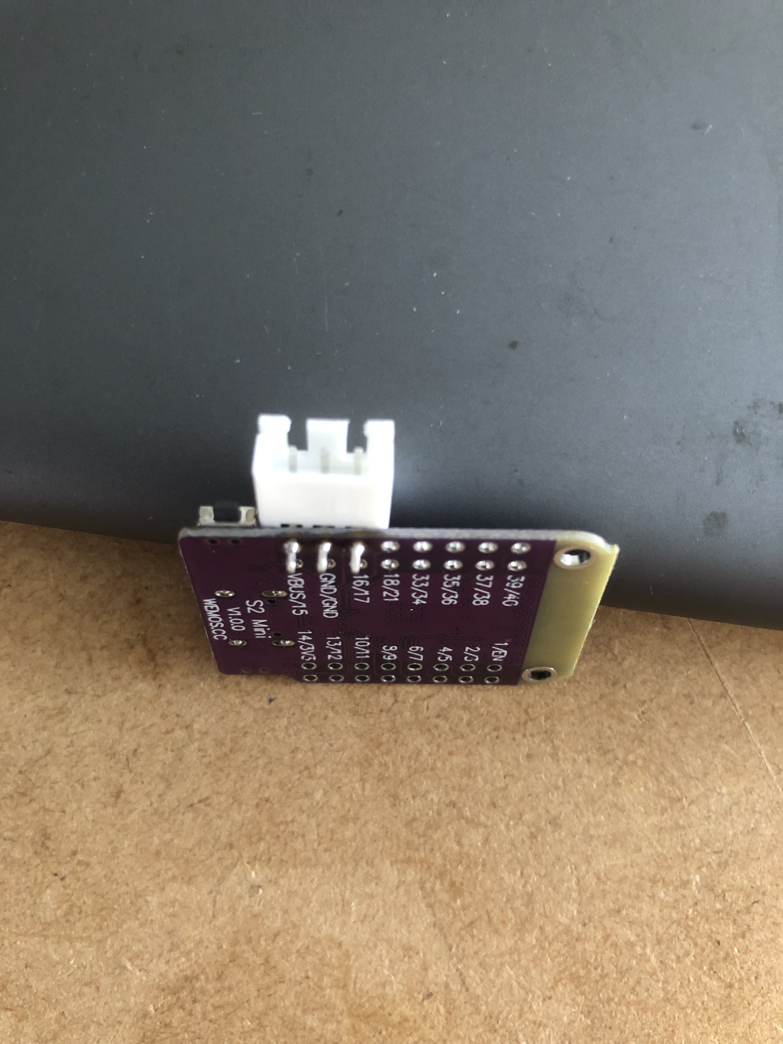
Tech Cube/Documents/Pictures/IMG_8213.jpeg
