MaltWhiskey/Technasium/Tech Cube/Documents/Pictures/IMG_8214.jpeg

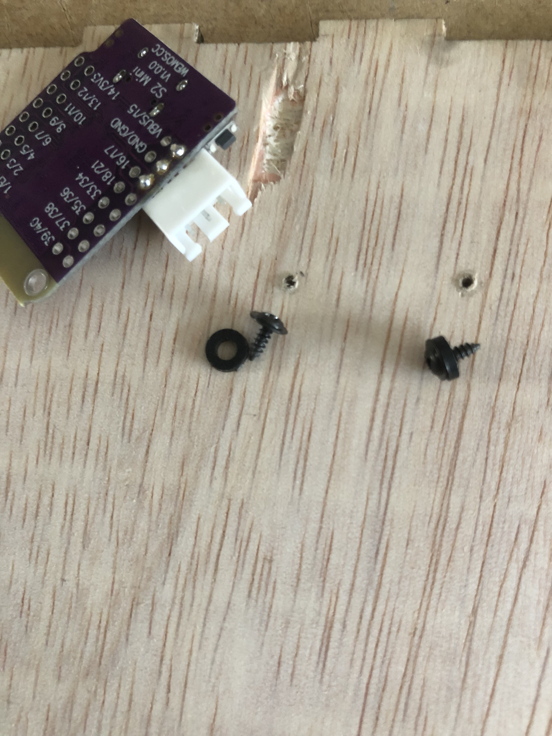
Tech Cube/Documents/Pictures/IMG_8214.jpeg
