MaltWhiskey/Technasium/Tech Cube/Documents/Pictures/IMG_8215.jpeg

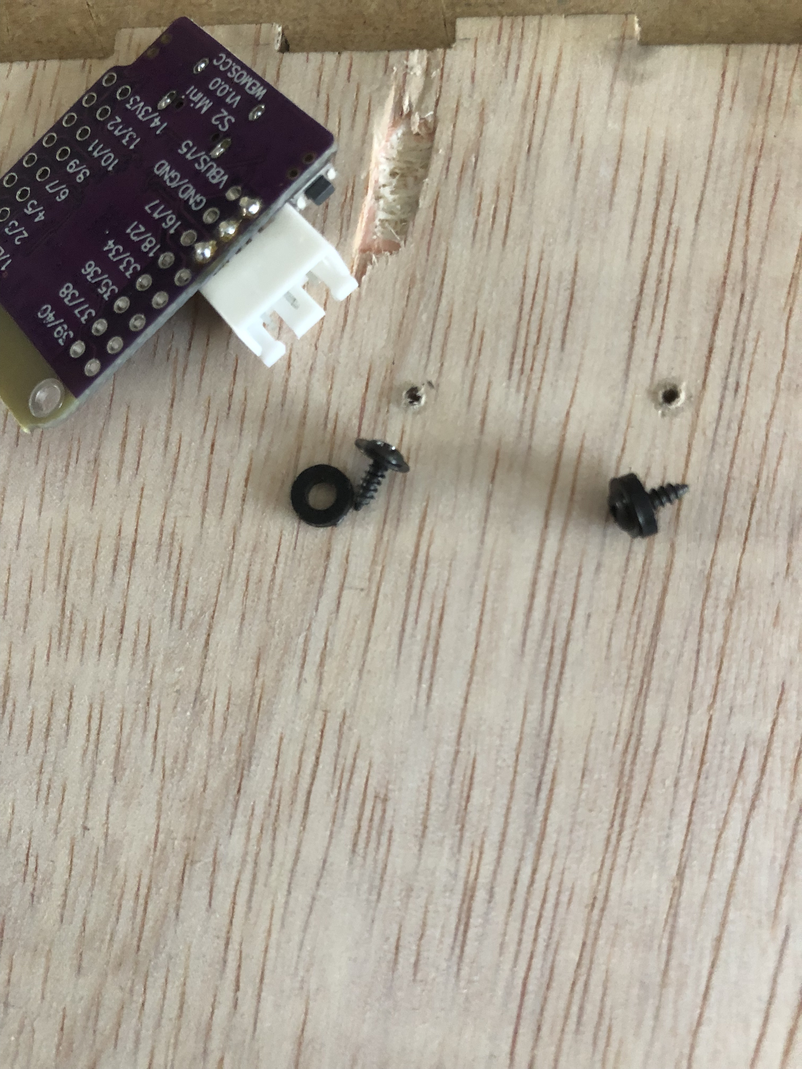
Tech Cube/Documents/Pictures/IMG_8215.jpeg
