MaltWhiskey/Technasium/Tech Cube/Documents/Pictures/IMG_8216.jpeg

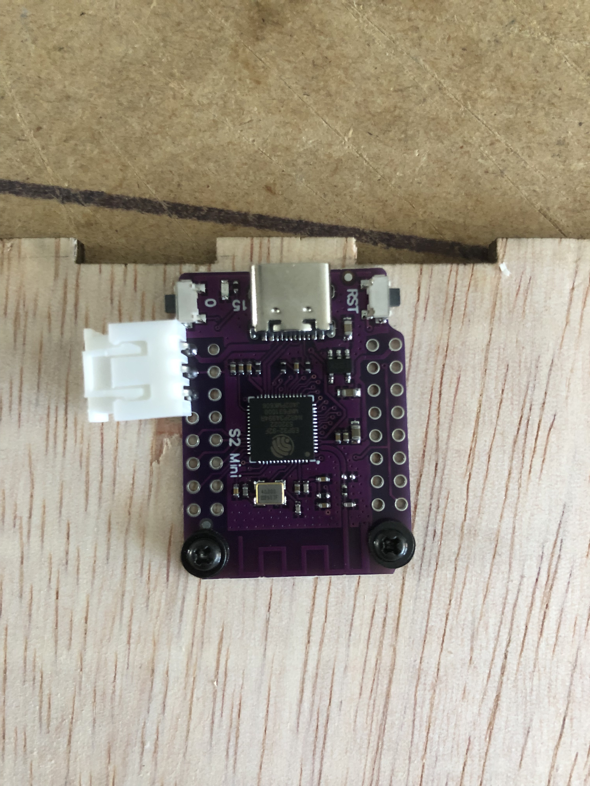
Tech Cube/Documents/Pictures/IMG_8216.jpeg
