MaltWhiskey/Technasium/Tech Cube/Documents/Pictures/IMG_8217.jpeg

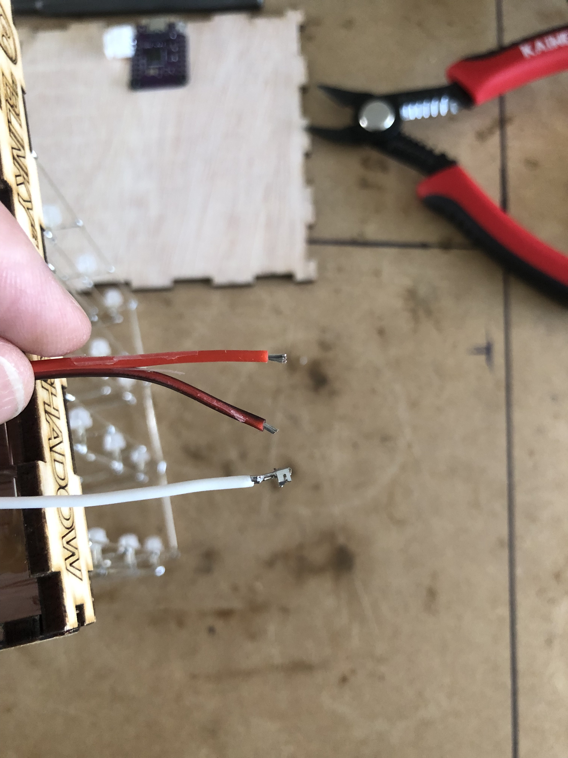
Tech Cube/Documents/Pictures/IMG_8217.jpeg
