MaltWhiskey/Technasium/Tech Cube/Documents/Pictures/IMG_8218.jpeg

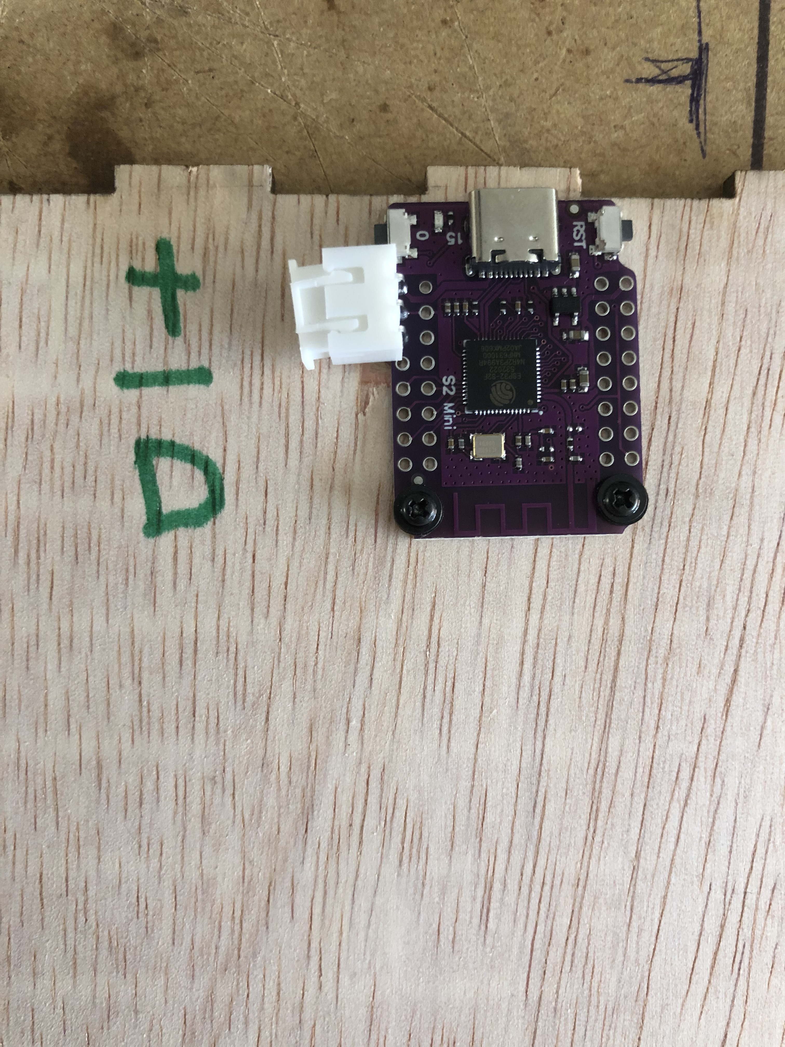
Tech Cube/Documents/Pictures/IMG_8218.jpeg
