MaltWhiskey/Technasium/Tech Cube/Documents/Pictures/IMG_8219.jpeg

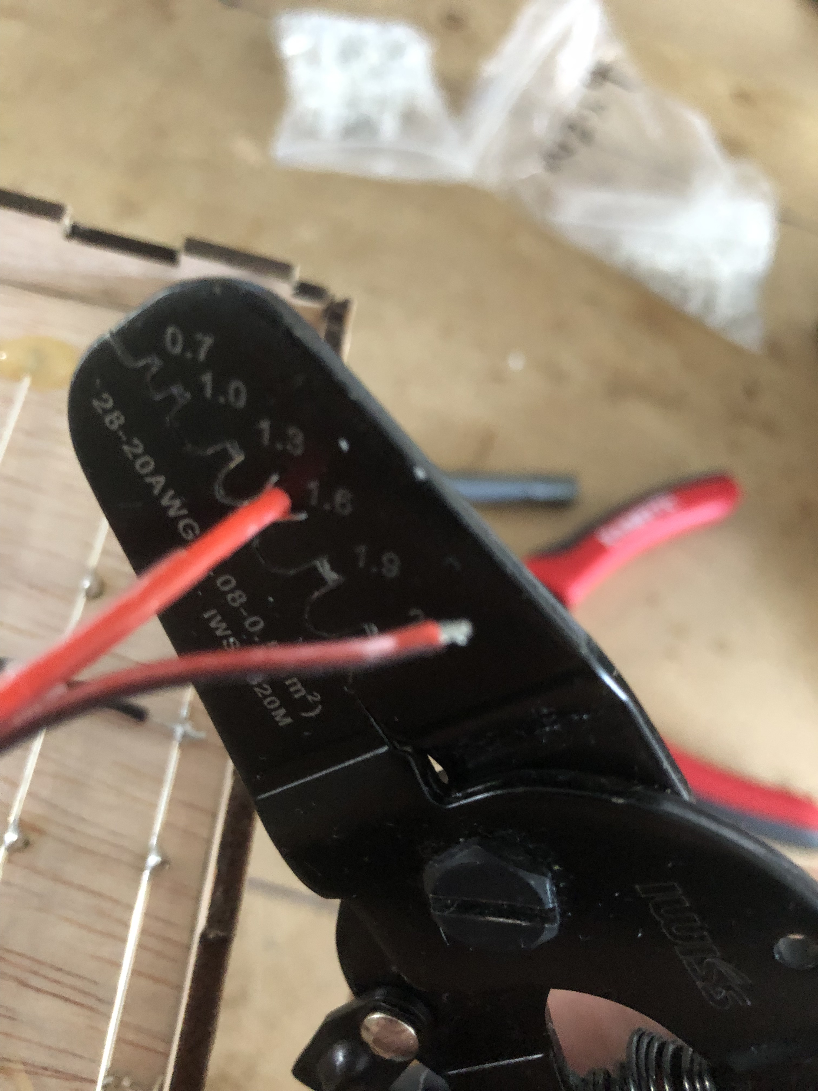
Tech Cube/Documents/Pictures/IMG_8219.jpeg
