MaltWhiskey/Technasium/Tech Cube/Documents/Pictures/IMG_8220.jpeg

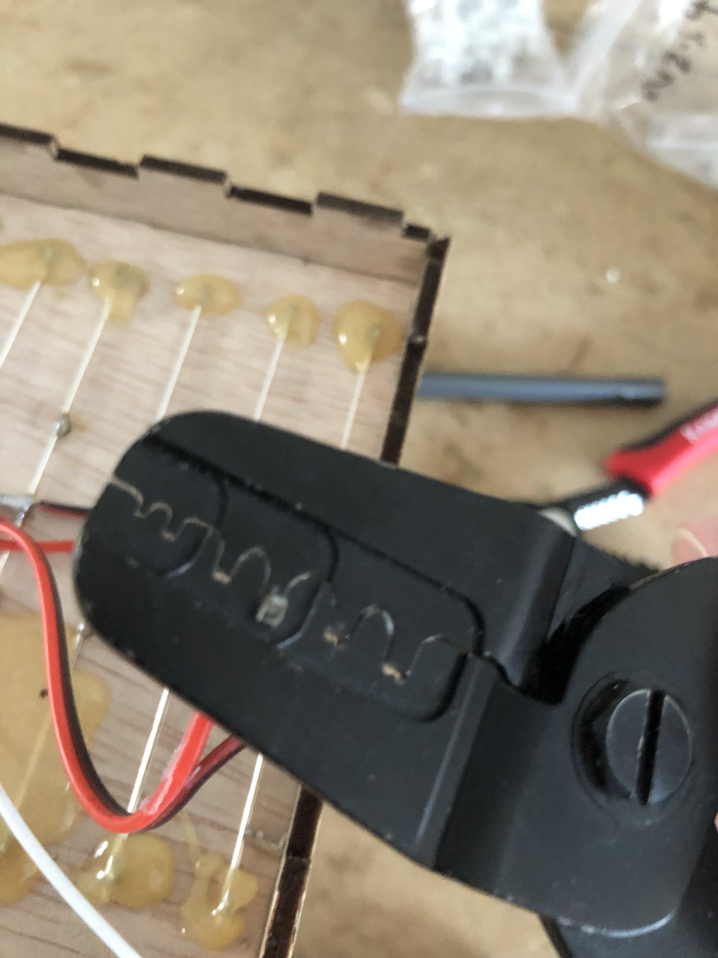
Tech Cube/Documents/Pictures/IMG_8220.jpeg
