MaltWhiskey/Technasium/Tech Cube/Documents/Pictures/IMG_8221.jpeg

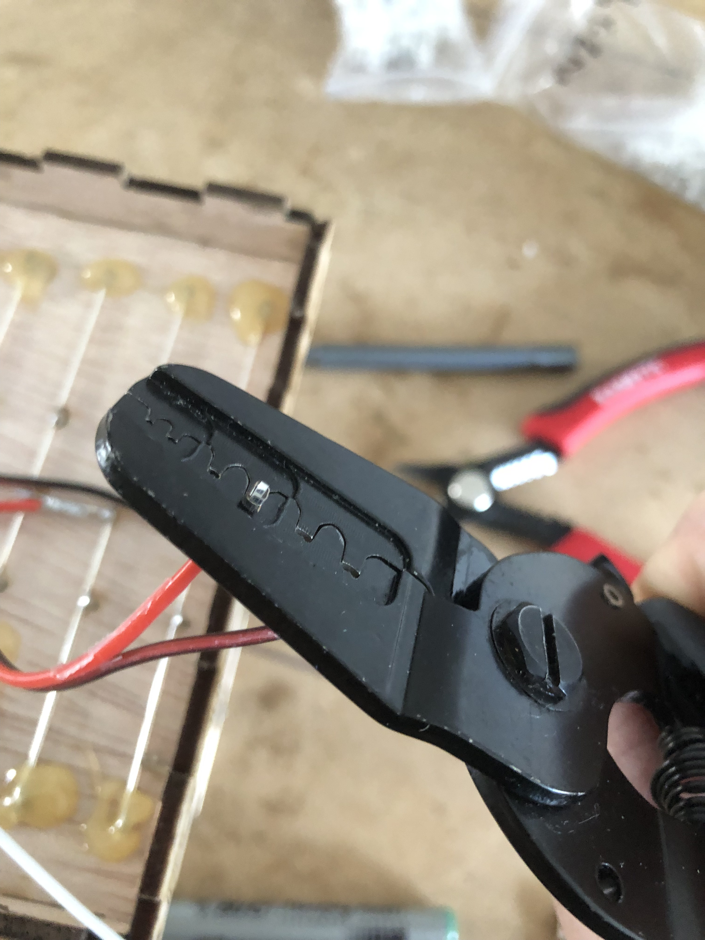
Tech Cube/Documents/Pictures/IMG_8221.jpeg
