MaltWhiskey/Technasium/Tech Cube/Documents/Pictures/IMG_8222.jpeg

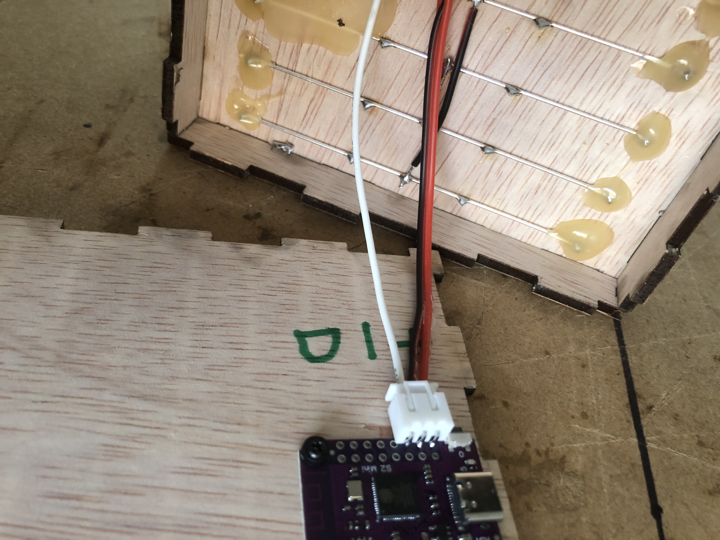
Tech Cube/Documents/Pictures/IMG_8222.jpeg
