MaltWhiskey/Technasium/Tech Cube/Documents/Pictures/IMG_8223.JPEG

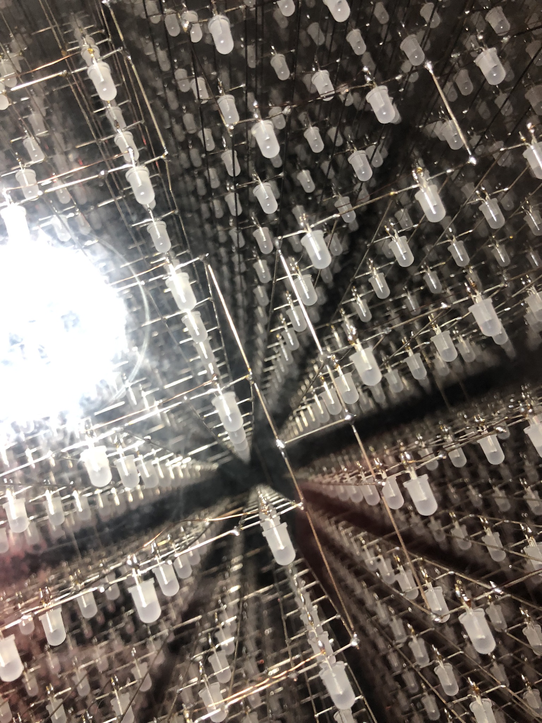
Tech Cube/Documents/Pictures/IMG_8223.JPEG
