MaltWhiskey/Technasium/Tech Cube/Documents/Pictures/IMG_8224.JPEG

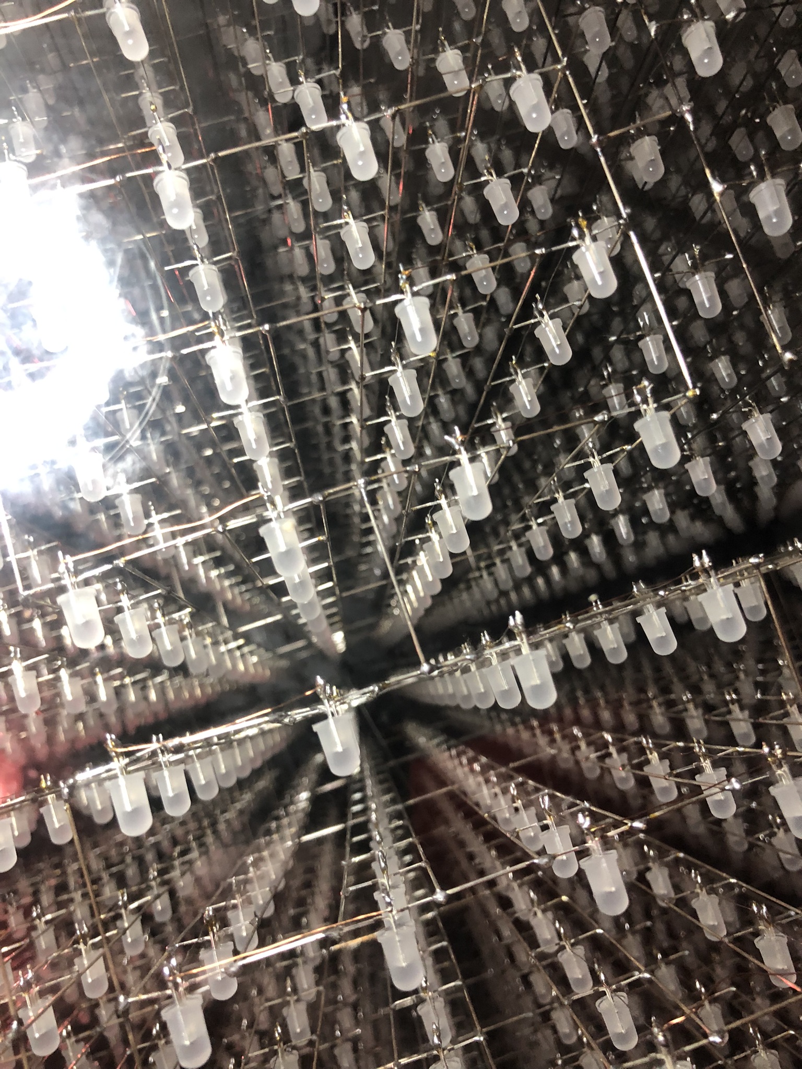
Tech Cube/Documents/Pictures/IMG_8224.JPEG
