MaltWhiskey/Technasium/Tech Cube/Documents/Pictures/IMG_8239.JPEG

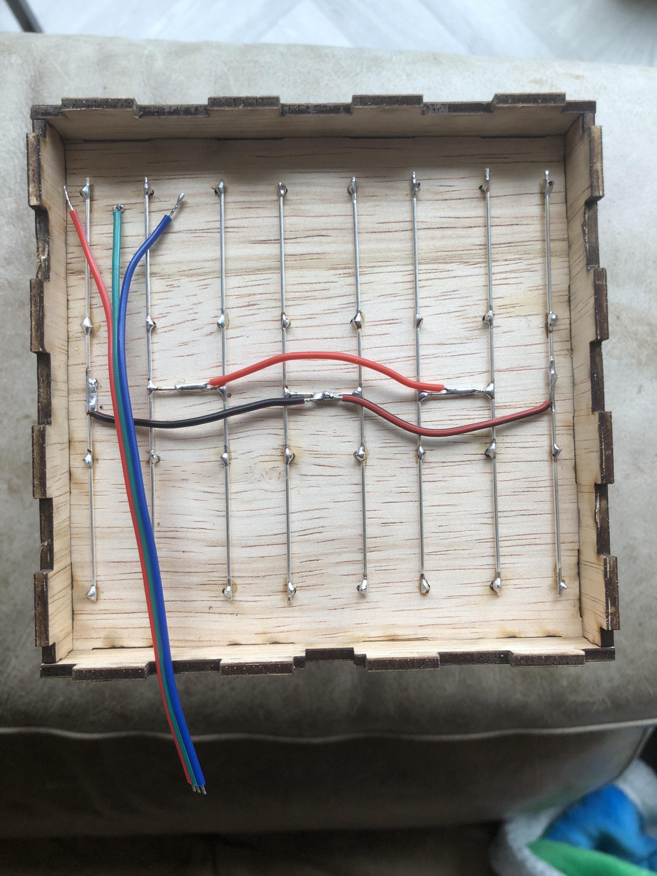
Tech Cube/Documents/Pictures/IMG_8239.JPEG
