MaltWhiskey/Technasium/Tech Cube/Documents/Pictures/IMG_8240.JPEG

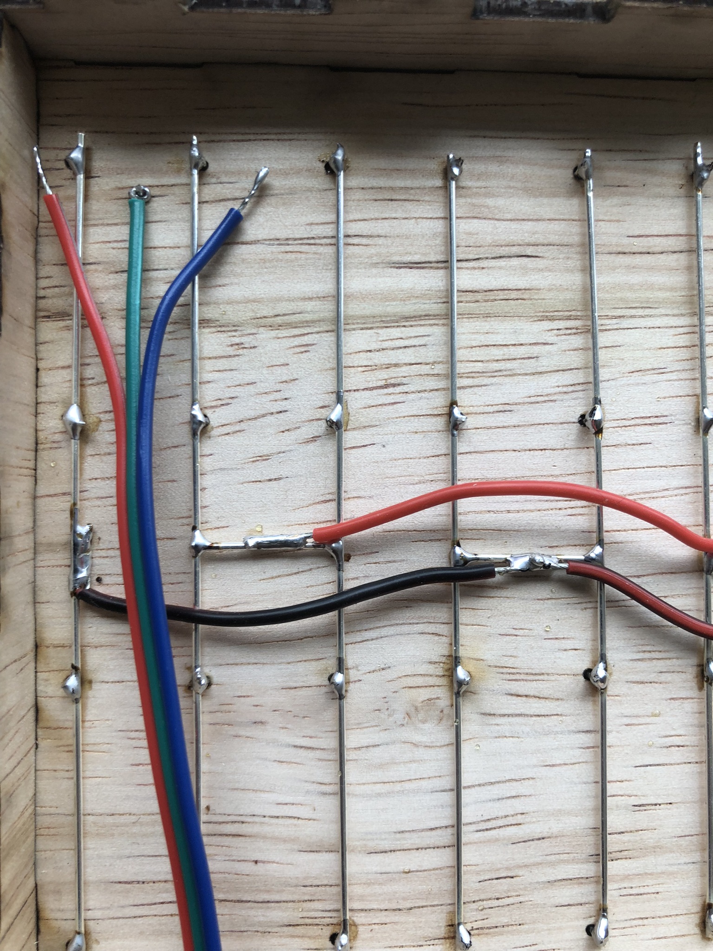
Tech Cube/Documents/Pictures/IMG_8240.JPEG
