MaltWhiskey/Technasium/Tech Cube/Documents/Pictures/IMG_8241.JPEG

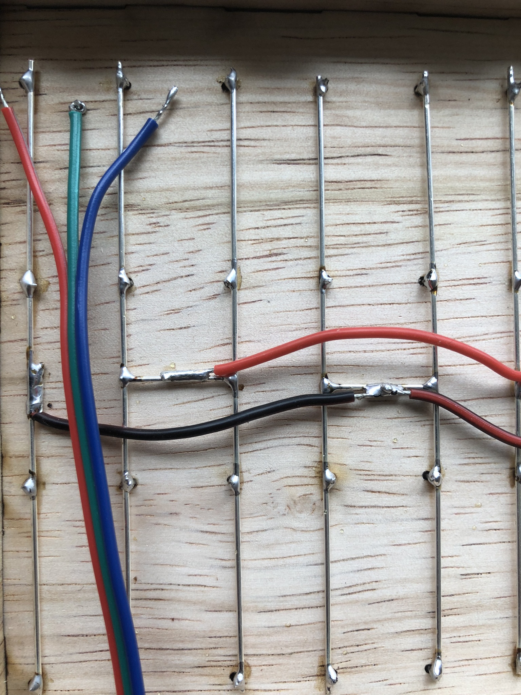
Tech Cube/Documents/Pictures/IMG_8241.JPEG
