MaltWhiskey/Technasium/Tech Cube/Documents/Pictures/IMG_8242.JPEG

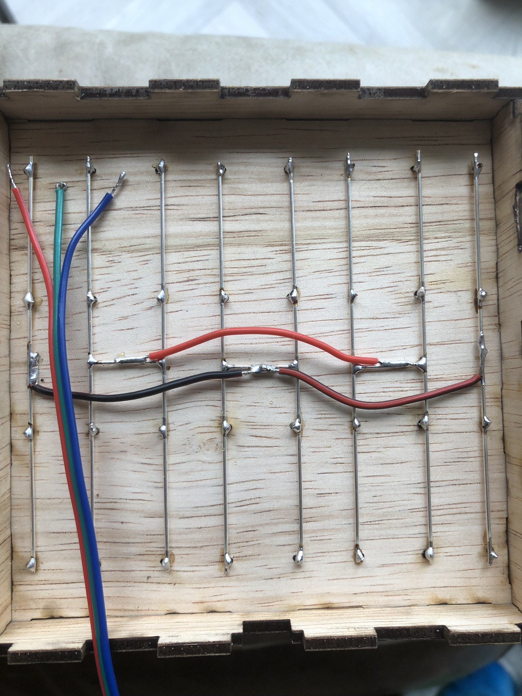
Tech Cube/Documents/Pictures/IMG_8242.JPEG
