MaltWhiskey/Technasium/Tech Cube/Documents/Pictures/IMG_8243.JPEG

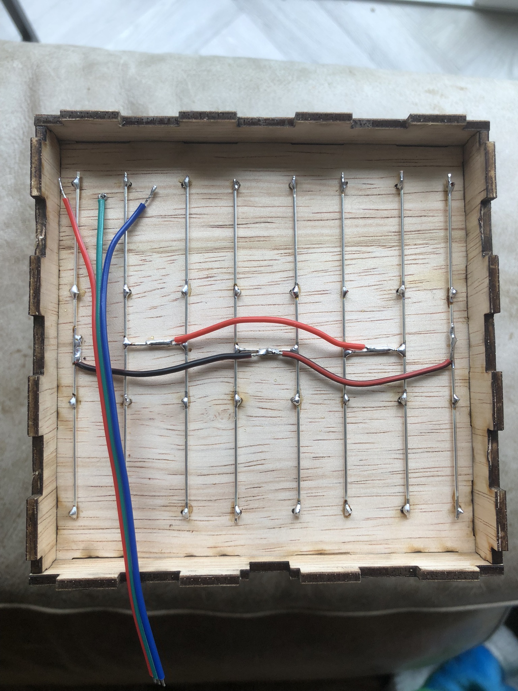
Tech Cube/Documents/Pictures/IMG_8243.JPEG
