MaltWhiskey/Technasium/Tech Cube/Documents/Pictures/IMG_8244.JPEG

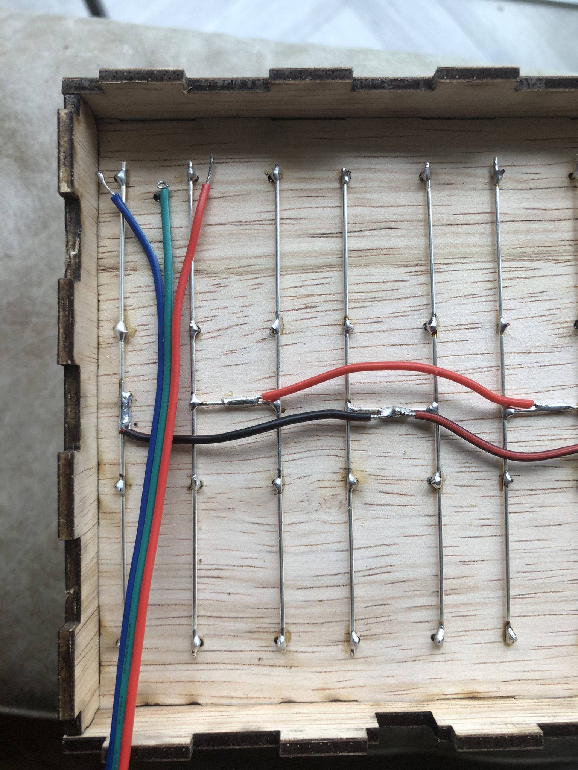
Tech Cube/Documents/Pictures/IMG_8244.JPEG
