MaltWhiskey/Technasium/Tech Cube/Documents/Pictures/IMG_8245.JPEG

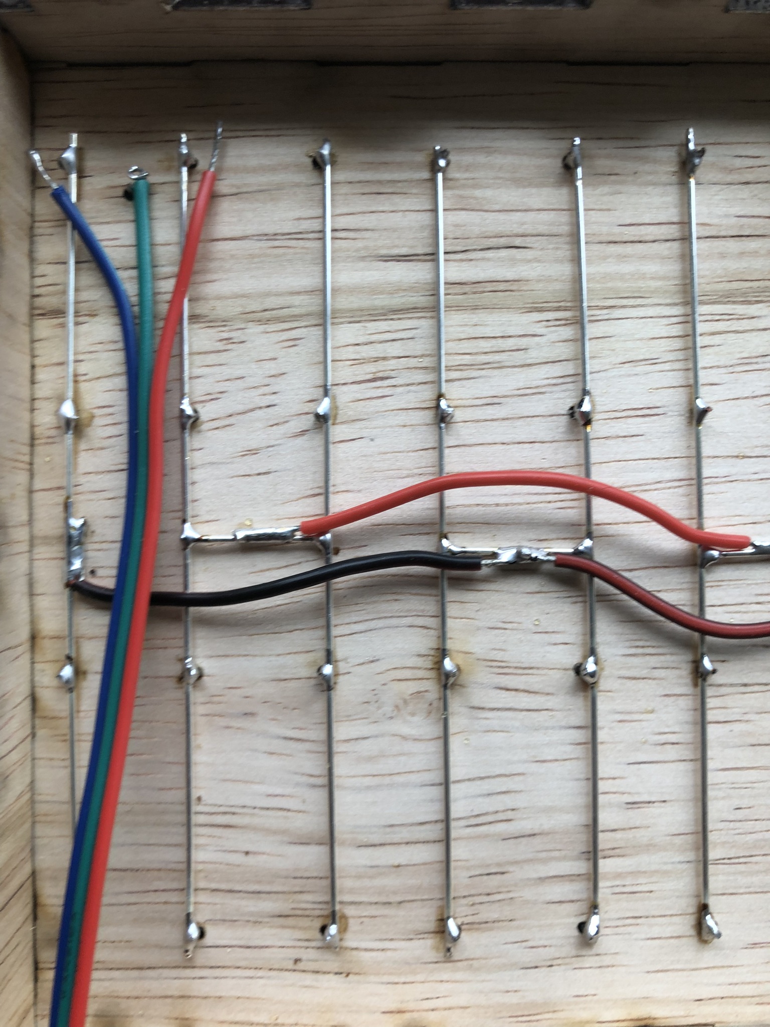
Tech Cube/Documents/Pictures/IMG_8245.JPEG
