MaltWhiskey/Technasium/Tech Cube/Documents/Pictures/IMG_8246.JPEG

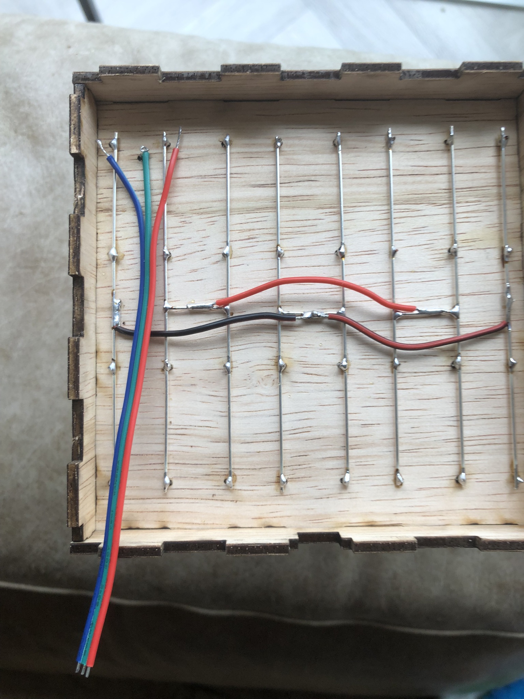
Tech Cube/Documents/Pictures/IMG_8246.JPEG
