MaltWhiskey/Technasium/Tech Cube/Documents/Pictures/IMG_8247.JPEG

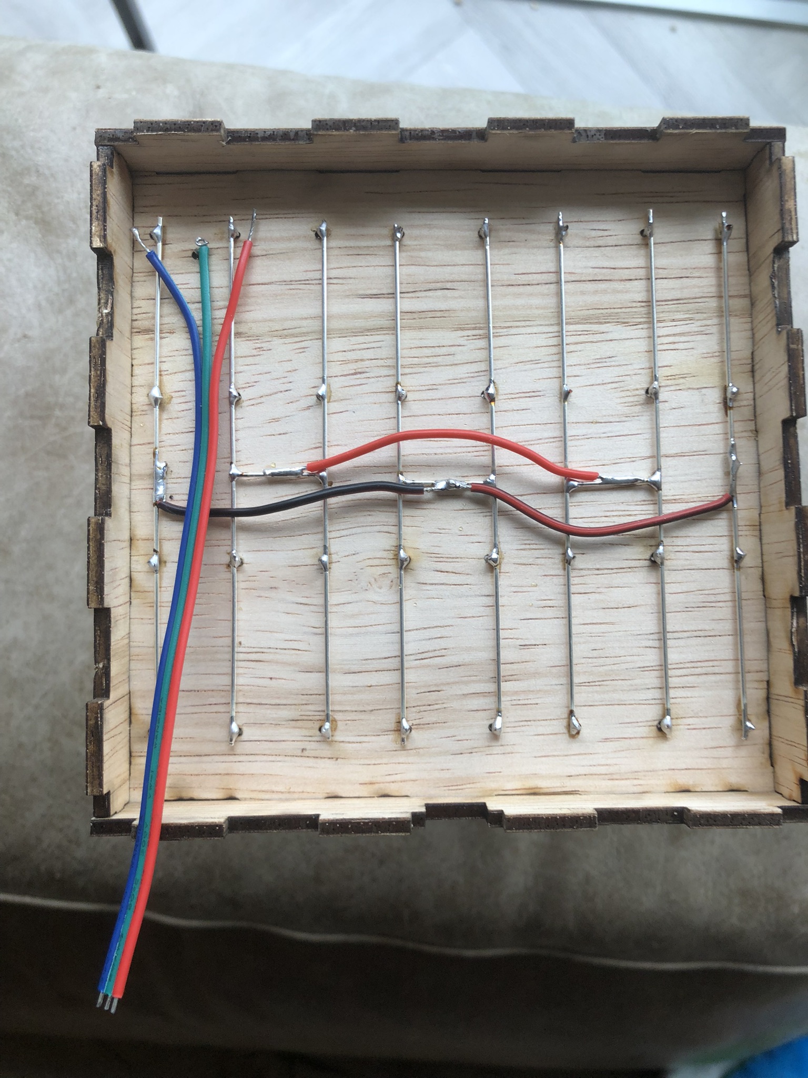
Tech Cube/Documents/Pictures/IMG_8247.JPEG
