MaltWhiskey/Technasium/Tech Cube/Documents/Pictures/IMG_8248.JPEG

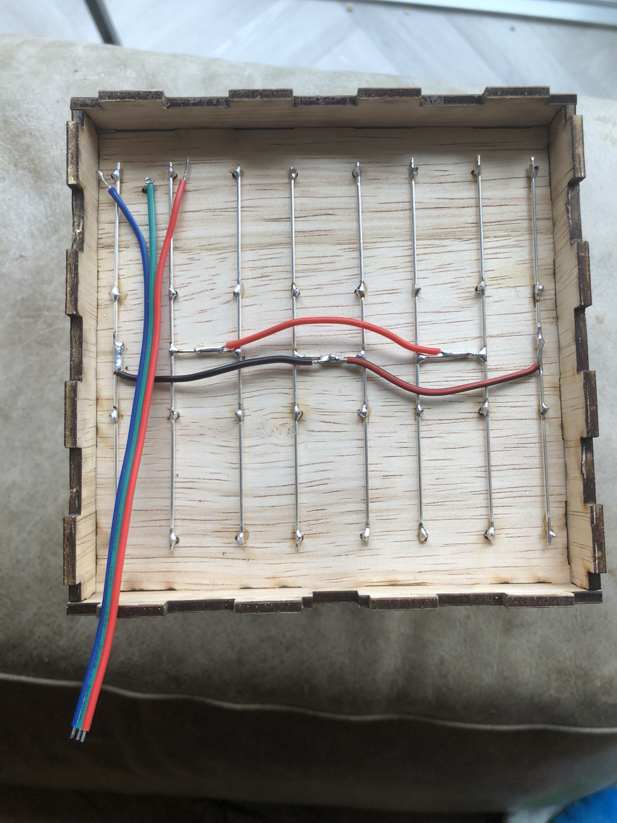
Tech Cube/Documents/Pictures/IMG_8248.JPEG
