MaltWhiskey/Technasium/Tech Cube/Documents/Pictures/IMG_8249.JPEG

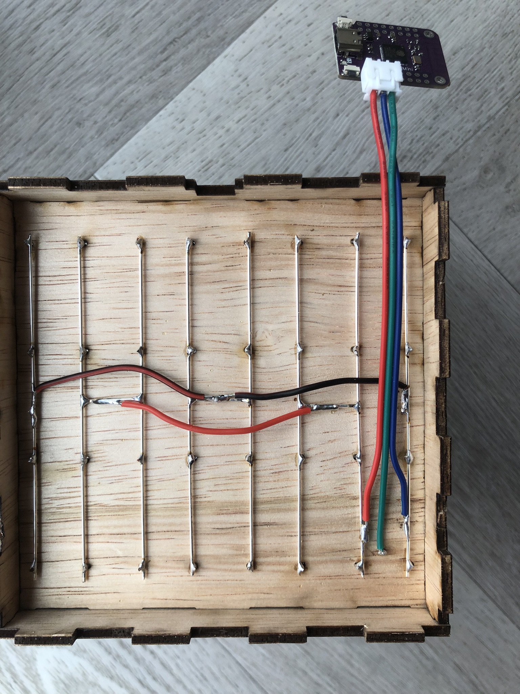
Tech Cube/Documents/Pictures/IMG_8249.JPEG
