MaltWhiskey/Technasium/Tech Cube/Documents/Pictures/IMG_8250.JPEG

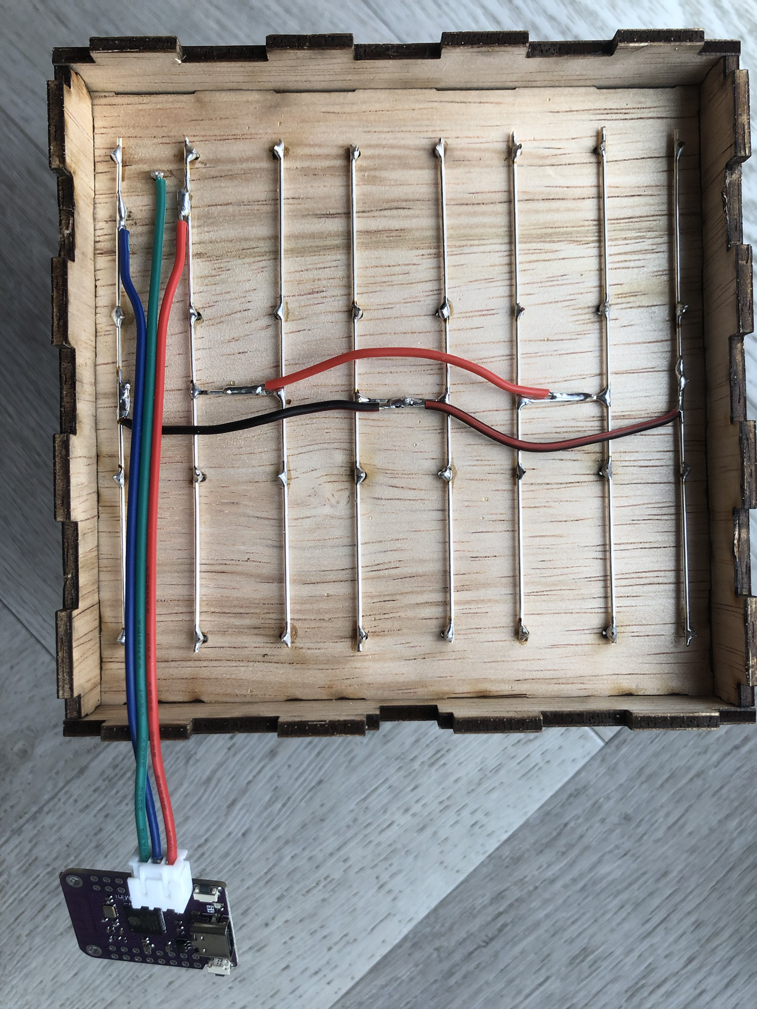
Tech Cube/Documents/Pictures/IMG_8250.JPEG
