MaltWhiskey/Technasium/Tech Cube/Documents/Pictures/IMG_8251.JPEG

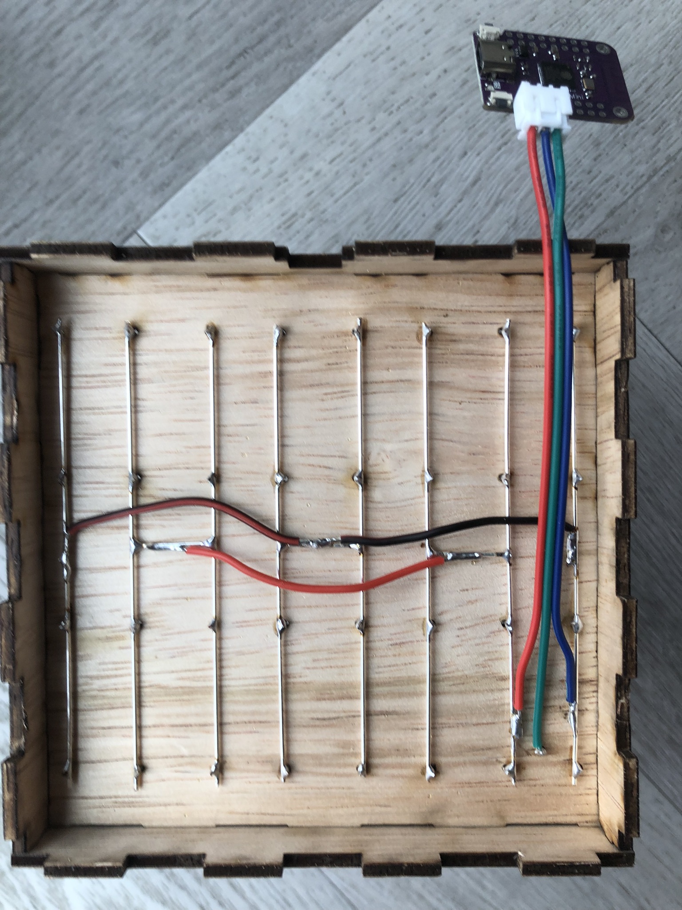
Tech Cube/Documents/Pictures/IMG_8251.JPEG
