MaltWhiskey/Technasium/Tech Cube/Documents/Pictures/IMG_8252.JPEG

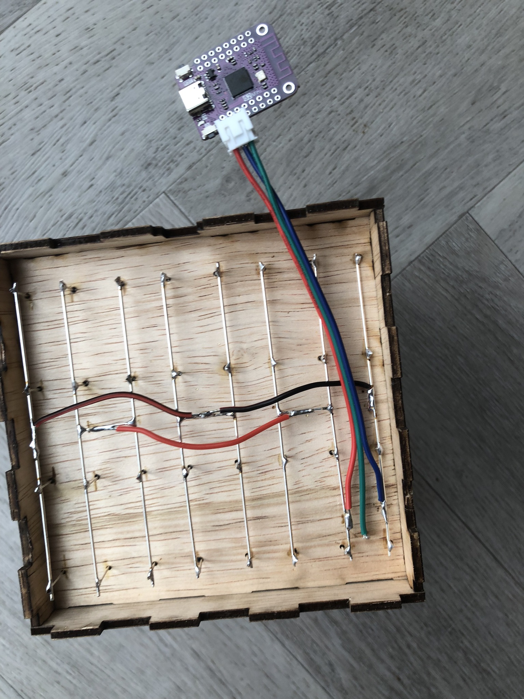
Tech Cube/Documents/Pictures/IMG_8252.JPEG
