MaltWhiskey/Technasium/Tech Cube/Documents/Pictures/IMG_8253.JPEG

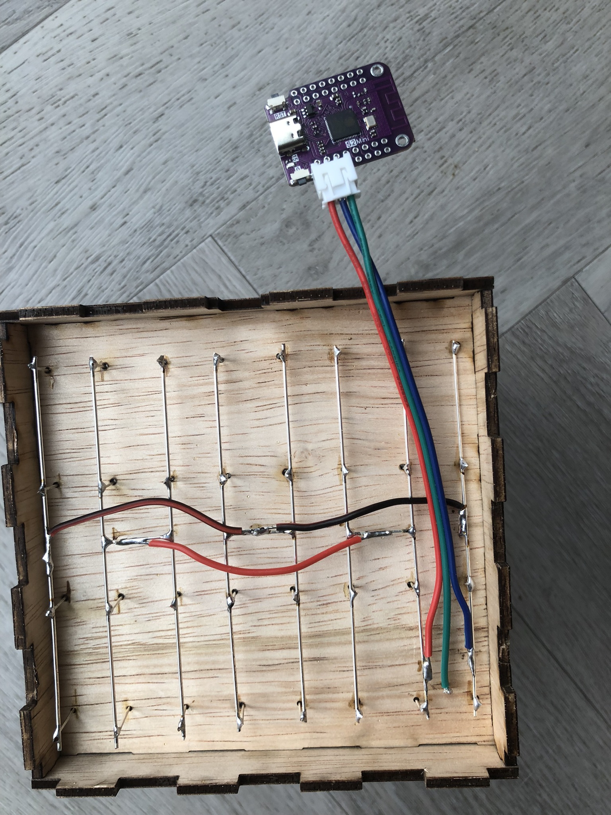
Tech Cube/Documents/Pictures/IMG_8253.JPEG
