MaltWhiskey/Technasium/Tech Cube/Documents/Pictures/IMG_8254.JPEG

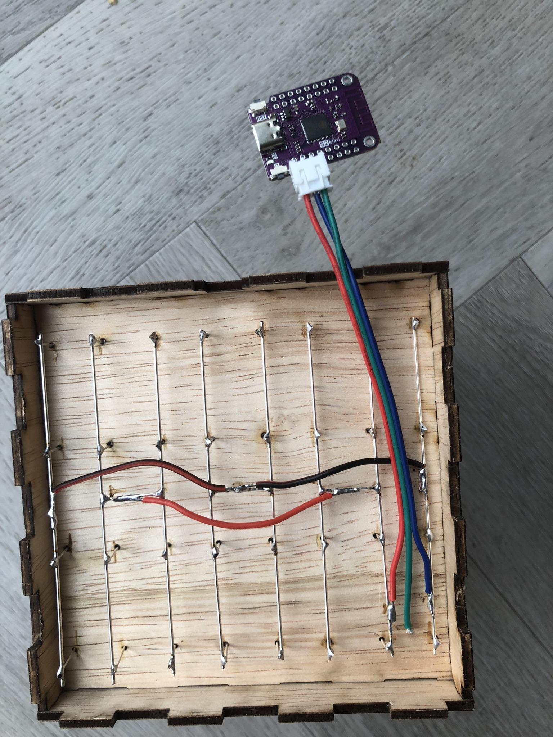
Tech Cube/Documents/Pictures/IMG_8254.JPEG
