MaltWhiskey/Technasium/Tech Cube/Documents/Pictures/IMG_8255.JPEG

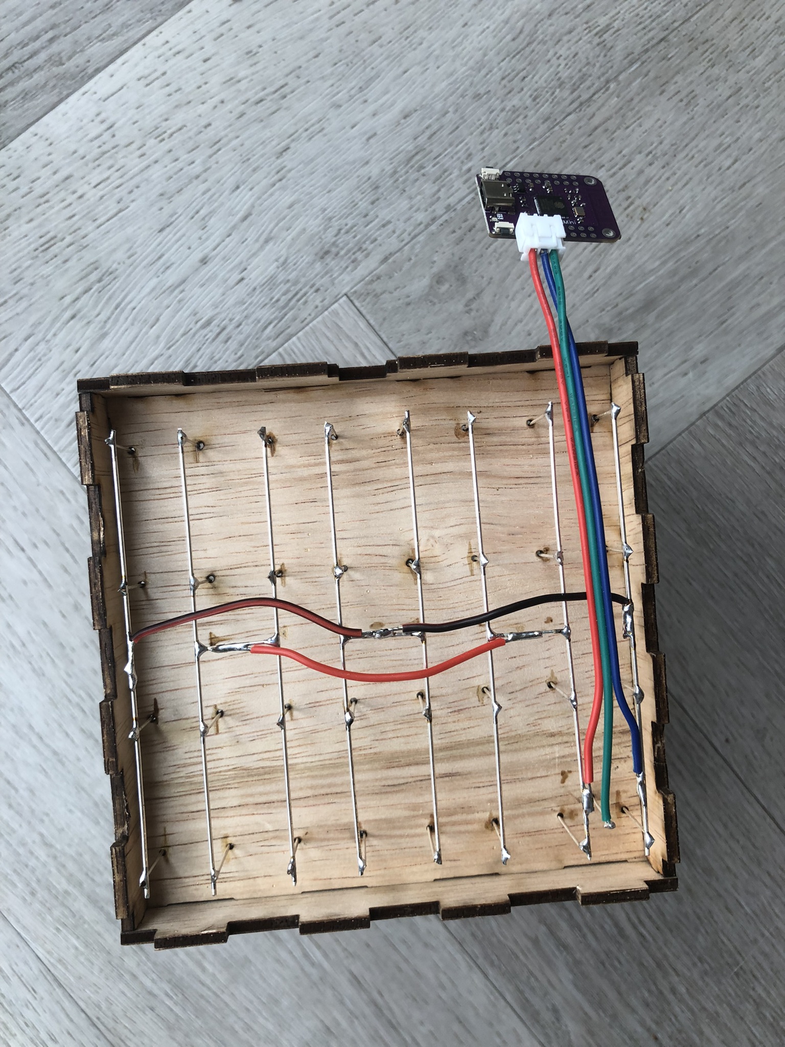
Tech Cube/Documents/Pictures/IMG_8255.JPEG
