MaltWhiskey/Technasium/Tech Cube/Documents/Pictures/IMG_8256.JPEG

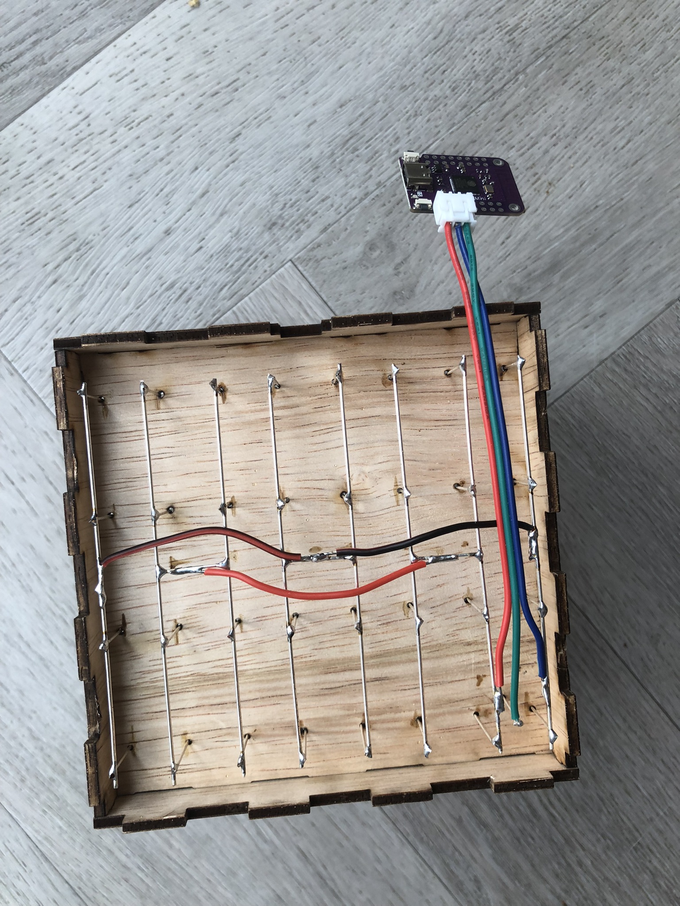
Tech Cube/Documents/Pictures/IMG_8256.JPEG
