MaltWhiskey/Technasium/Tech Cube/Documents/Pictures/IMG_8257.JPEG

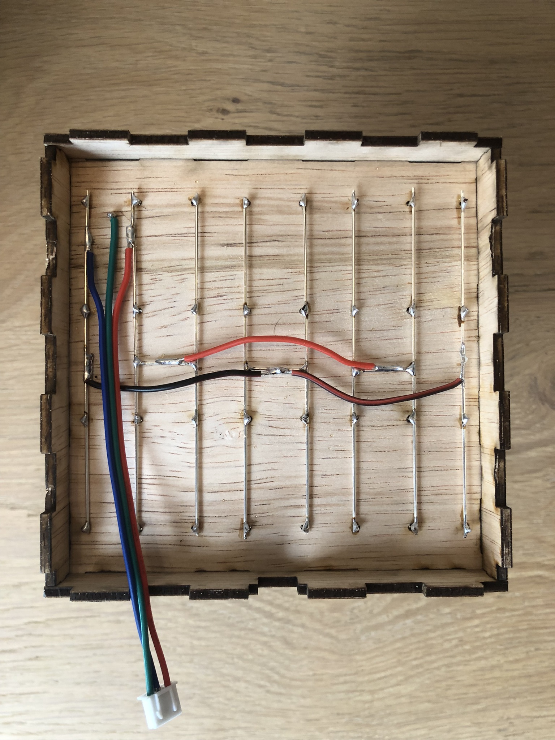
Tech Cube/Documents/Pictures/IMG_8257.JPEG
