MaltWhiskey/Technasium/Tech Cube/Documents/Pictures/IMG_8258.JPEG

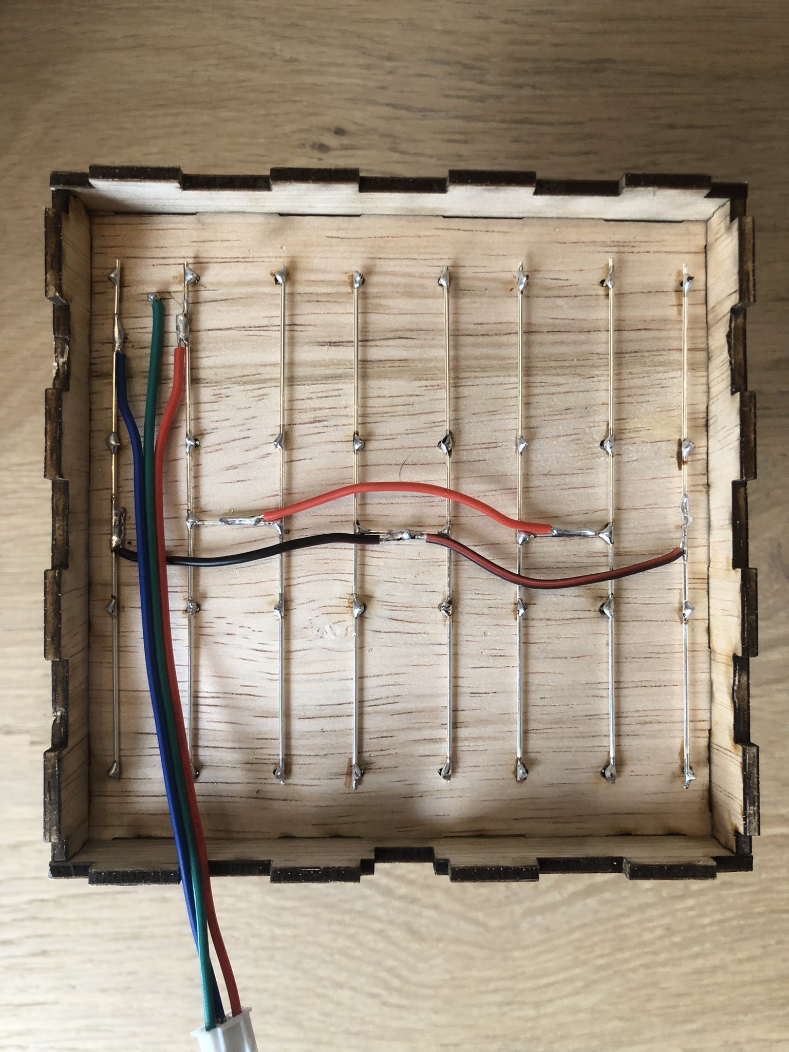
Tech Cube/Documents/Pictures/IMG_8258.JPEG
