MaltWhiskey/Technasium/Tech Cube/Documents/Pictures/IMG_8259.JPEG

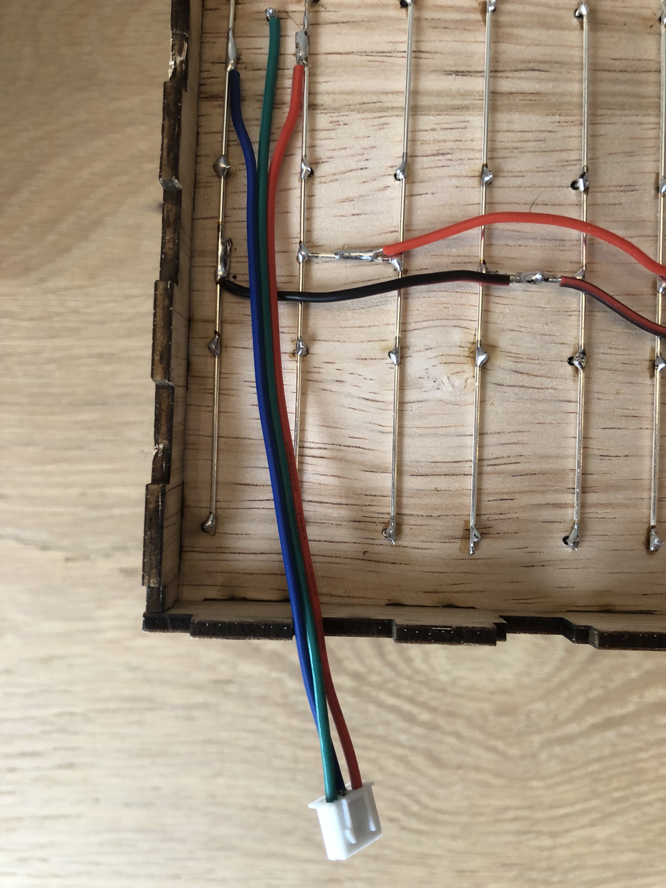
Tech Cube/Documents/Pictures/IMG_8259.JPEG
