MaltWhiskey/Technasium/Tech Cube/Documents/Pictures/IMG_8261.JPEG

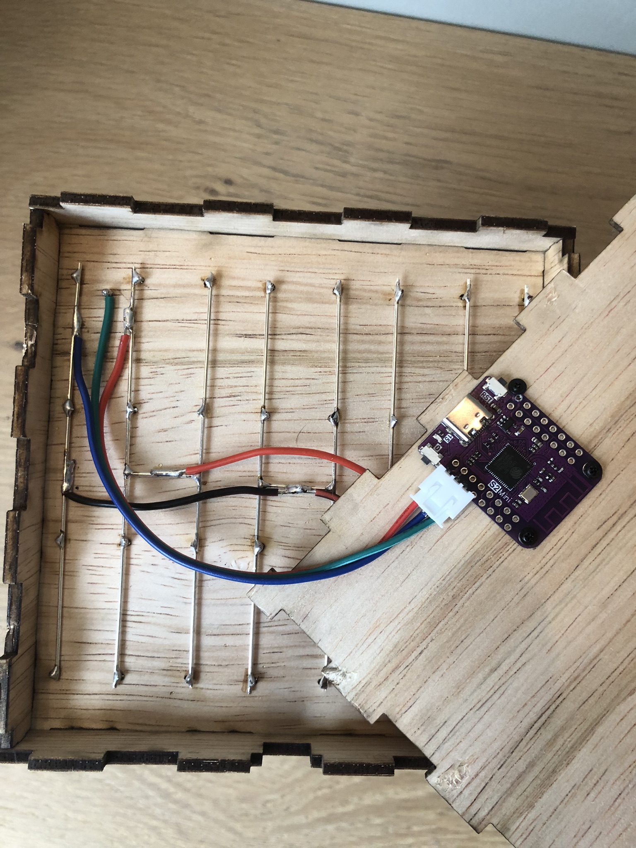
Tech Cube/Documents/Pictures/IMG_8261.JPEG
