MaltWhiskey/Technasium/Tech Cube/Documents/Pictures/IMG_8262.JPEG

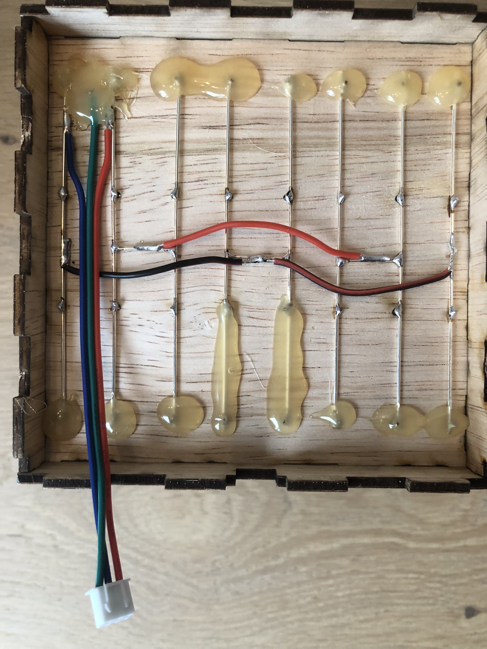
Tech Cube/Documents/Pictures/IMG_8262.JPEG
