MaltWhiskey/Technasium/Tech Cube/Documents/Pictures/IMG_8263.JPEG

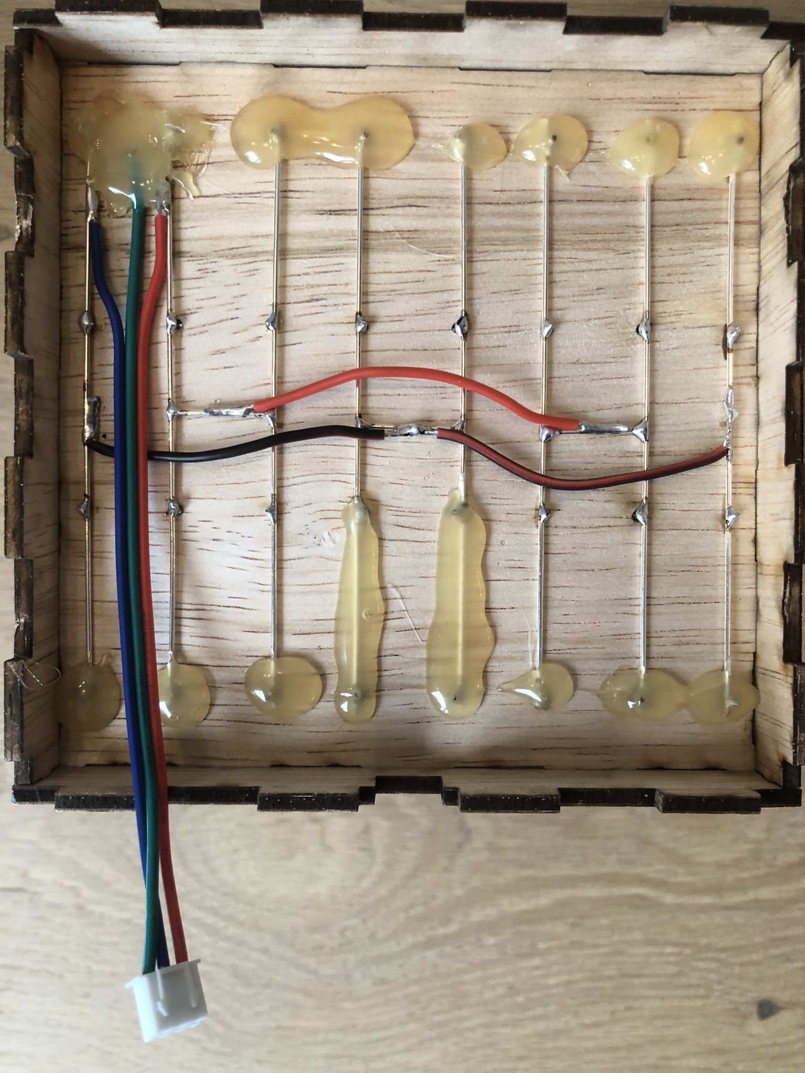
Tech Cube/Documents/Pictures/IMG_8263.JPEG
