MaltWhiskey/Technasium/Tech Cube/Documents/Pictures/IMG_8289.JPEG

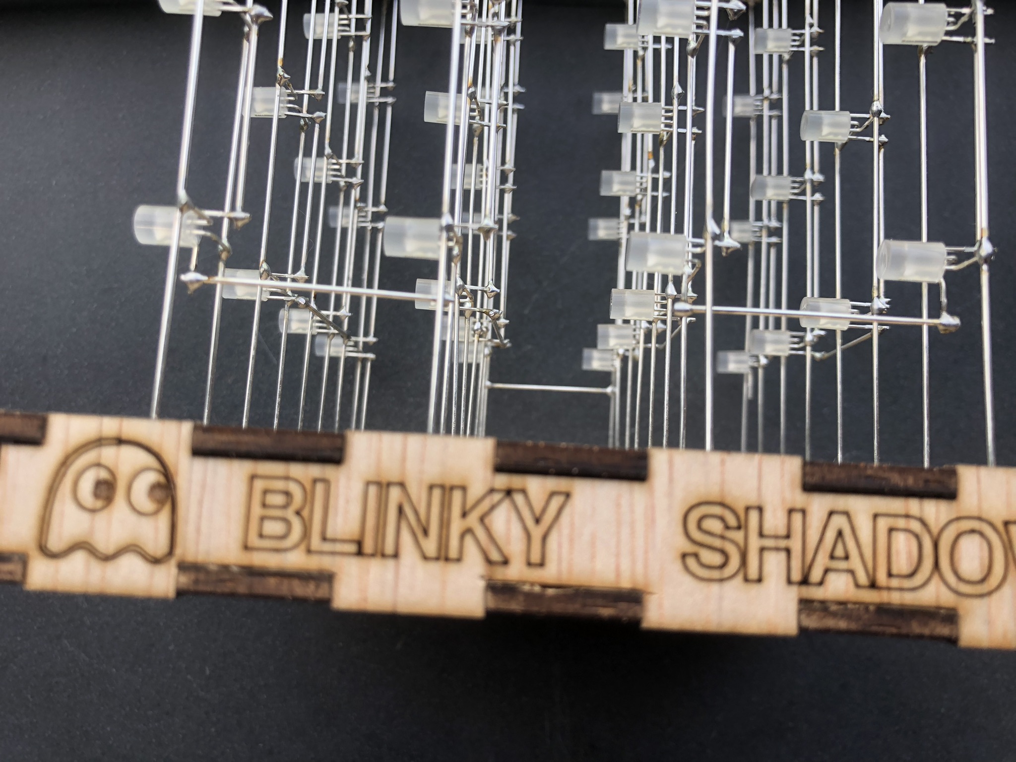
Tech Cube/Documents/Pictures/IMG_8289.JPEG
