MaltWhiskey/Technasium/Tech Cube/Documents/Pictures/IMG_8291.JPEG

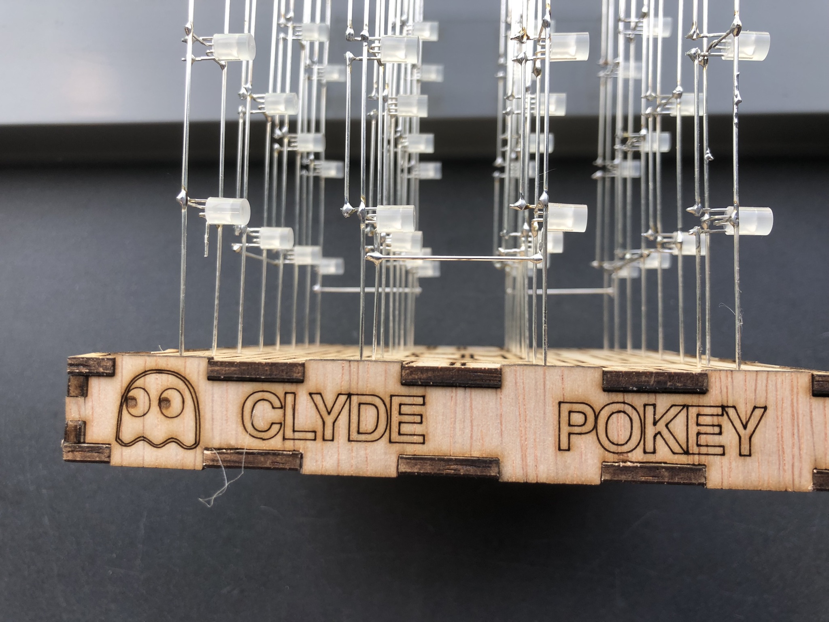
Tech Cube/Documents/Pictures/IMG_8291.JPEG
