MaltWhiskey/Technasium/Tech Cube/Documents/Pictures/IMG_8464.JPEG

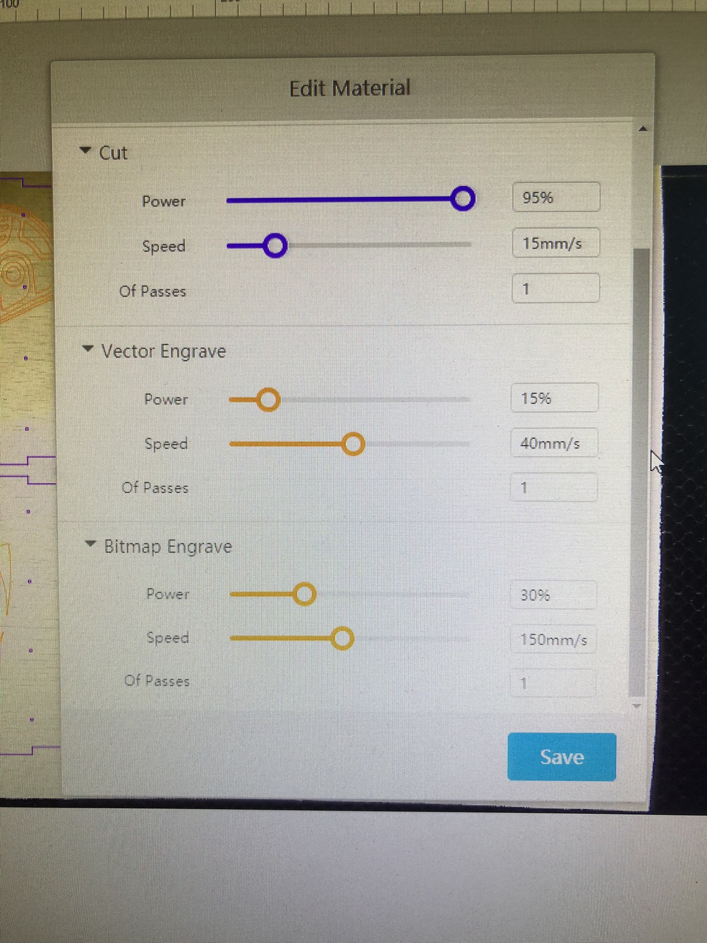
Tech Cube/Documents/Pictures/IMG_8464.JPEG
