MaltWhiskey/Technasium/Tech Cube/Documents/Pictures/IMG_8465.JPEG

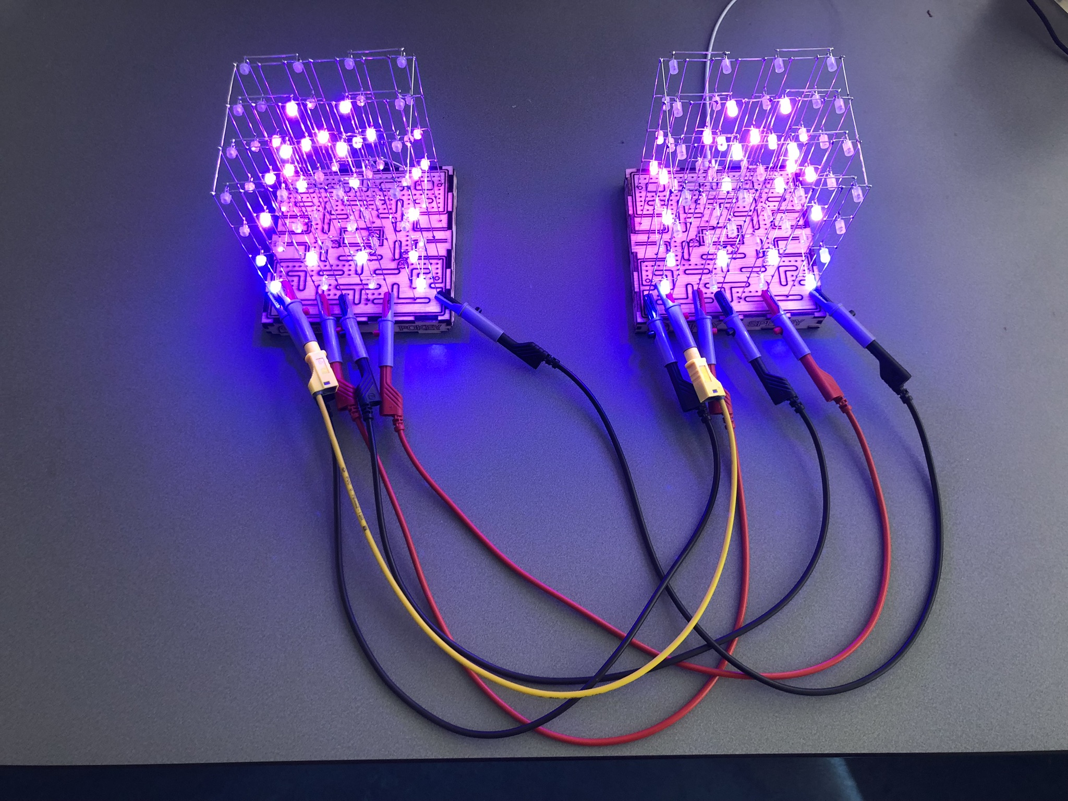
Tech Cube/Documents/Pictures/IMG_8465.JPEG
