MaltWhiskey/Technasium/Tech Cube/Documents/Pictures/IMG_8468.JPEG

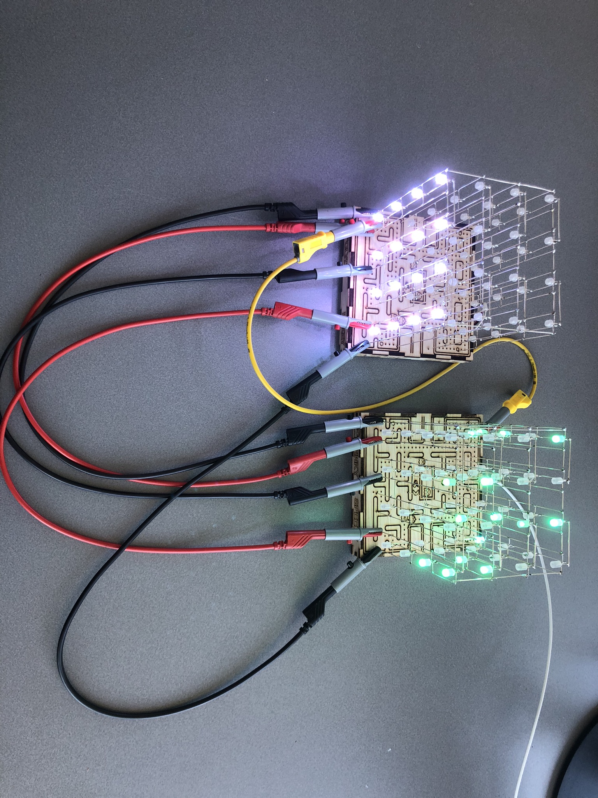
Tech Cube/Documents/Pictures/IMG_8468.JPEG
