MaltWhiskey/Technasium/Tech Cube/Software/Animation Example/src/img/Blobs.gif

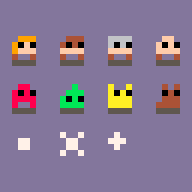
Tech Cube/Software/Animation Example/src/img/Blobs.gif
