MaltWhiskey/Technasium/Tech Cube/Documents/Tech Cube - BOM.xlsx

Sheet: Cost per LL
Item | Supplier | Order Date | Received | Description | Type | Qty | Cost | Units | Price | Unit Price | Units/LL | Cost/LL | LL | BTW
1 | AliExpress | 2023-03-24 | 2023-04-07 | Washer | M2x5x1mm | 1 | €0.79 | 100 | €0.79 | €0.01 | 2 | €0.02 | 50
2 | AliExpress | 2023-03-24 | 2023-04-07 | Wire | 22AWG 3pin | 1 | €15.93 | 50 | €15.93 | €0.32 | 0.2 | €0.06 | 250
3 | AliExpress | 2023-03-24 | 2023-04-07 | ESP32 | S2 mini | 50 | €2.25 | 1 | €112.66 | €2.25 | 1 | €2.25 | 50
4 | AliExpress | 2023-03-24 | 2023-04-07 | JSH XH 2.54 | 3Pin housing | 1 | €1.98 | 100 | €1.98 | €0.02 | 1 | €0.02 | 100
5 | AliExpress | 2023-03-24 | 2023-04-07 | JST XH 2.54 | Pin | 1 | €3.26 | 500 | €3.26 | €0.01 | 3 | €0.02 | 166.6666667
6 | AliExpress | 2023-03-24 | 2023-04-07 | JST XH 2.54 | 3Pin angled connector | 1 | €3.05 | 150 | €3.05 | €0.02 | 1 | €0.02 | 150
7 | AliExpress | 2023-03-24 | 2023-04-14 | WS2811 | F5 hat led | 3 | €65.67 | 1000 | €197.01 | €0.07 | 64 | €4.20 | 46.875 | €62.34
8 | AliExpress | 2023-03-24 | 2023-04-07 | Screw | M1.4x3mm | 1 | €2.01 | 200 | €2.01 | €0.01 | 2 | €0.02 | 100
9 | Rene |  |  | Wood | 122x61x3cm | 7 | €7.79 | 4 | €54.53 | €1.95 | 0.5 | €0.97 | 56
10 | Rene |  |  | Glue | Hotglue (bol.com) | 1 | €10.00 | 100 | €10.00 | €0.10 | 1 | €0.10 | 100
11 | Mouser | 2023-03-14 | 2023-03-21 | Solder | Kester 63/37 0.025" | 1 | €66.26 | 1 | €66.26 | €66.26 | 0.005 | €0.33 | 200
12 | Mouser | 2023-03-14 | 2023-03-21 | Solder | Kester 63/37 0.031" | 1 | €58.31 | 1 | €58.31 | €58.31 | 0.005 | €0.29 | 200
13 | Conrad | 2023-03-31 | 2023-04-08 | Wire | BLK vertind 0,80mm | 5 | €29.65 | 110 | €148.25 | €0.27 | 10 | €2.70 | 55
14 | Conrad | 2023-03-31 | 2023-04-08 | Wire | BLK vertind 1,00mm | 1 | €22.99 | 70 | €22.99 | €0.33 | 1 | €0.33 | 70
15 | AliExpress | 2023-03-31 | 2023-04-13 | USB-C | Bulk 1m | 1 | €48.02 | 100 | €48.02 | €0.48 | 1 | €0.48 | 100
16 | AliExpress | 2023-03-31 | 2023-04-13 | RGB LED | Common anode | 1 | €25.65 | 1000 | €25.65 | €0.03 | €10.00 | €0.26 | 100
 |  |  |  |  |  |  |  |  | Total |  |  | Total/LL | Total LL
 |  |  |  |  |  |  |  |  | €770.70 |  |  | €12.07 | 46.875

Sheet: Cost new assets
Item | Supplier | Order Date | Received | Description | Type | Qty | Cost | Units | Price | Unit Price | BTW
1 | AliExpress | 2023-03-24 | 2023-04-07 | Side cutter | Universel | 1 | €16.74 | 10 | €16.74 | €1.67
2 | AliExpress | 2023-03-24 | 2023-04-07 | Crimper | IWS-2820 | 1 | €19.34 | 1 | €19.34 | €19.34
3 | AliExpress | 2023-03-24 | 2023-04-07 | Pincer | Reversed | 1 | €9.67 | 1 | €9.67 | €9.67
4 | AliExpress | 2023-03-24 | 2023-03-28 | Fillament | PLA | 1 | €19.26 | 1 | €19.26 | €19.26
5 | AliExpress | 2023-03-24 | 2023-04-07 | Solderingstation | T245 130W | 7 | €55.02 | 1 | €385.14 | €55.02 | €30.64
6 | AliExpress | 2023-03-24 | 2023-04-07 | Side cutter | KWS-102 | 1 | €30.83 | 1 | €30.83 | €30.83
7 | AliExpress | 2023-03-31 | 2023-04-13 | Fume extractor | FA-400 | 4 | €28.52 | 1 | €114.08 | €28.52
8 | AliExpress | 2023-03-31 | 2023-04-13 | Fume extractor | FA-400 | 3 | €29.26 | 1 | €87.78 | €29.26
9 | AliExpress | 2023-03-31 | 2023-04-13 | Drill bit | 0,8mm | 1 | €1.34 | 1 | €1.34 | €1.34
 |  |  |  |  |  |  |  |  | Total
 |  |  |  |  |  |  |  |  | €684.18

Sheet: Cost current assets
Item | Supplier | Order Date | Received | Description | Type | Qty | Cost | Units | Price | Unit Price | Comment
1 | Technasium | 2023-01-01 | 2023-01-01 | Wrench | Table Wrench | 3 | €0.00 | 1 | €0.00 | €0.00 | 1 per table
2 | Technasium | 2023-01-01 | 2023-01-01 | Drill | Battery Powered | 3 | €0.00 | 1 | €0.00 | €0.00 | 1 per table
3 | Rene | 2023-03-28 |  | Cable | Power extension 4 sockets | 3 | €0.00 | 1 | €0.00 | €0.00 | 1 per table
4 | BINASK | 2023-03-29 | 2023-03-29 | Pincer | Regular | 7 | €0.00 | 1 | €0.00 | €0.00 | In biology cabinet A2.10
5 | Daniël | 2023-01-01 | 2023-04-13 | 3D prints | Jig and bender | 7 | €0.00 | 1 | €0.00 | €0.00
6 | Technasium | 2023-03-28 | 2023-03-28 | Duct tape | Generic | 1 | €0.00 | 1 | €0.00 | €0.00
7 | Rene | 2023-03-28 |  | File | Small size | 1 | €0.00 | 1 | €0.00 | €0.00 | For adjustment on 3D prints
8 | Rene | 2023-03-28 |  | PVC Tube | Storage tube 17 cm | 7 | €0.00 | 1 | €0.00 | €0.00
9 | Technasium | 2023-03-28 | 2023-03-28 | Storage | Soldering/Project assets | 1 | €0.00 | 1 | €0.00 | €0.00
10 | Rene | 2023-03-28 |  | Hardboard | For soldering | 8 | €0.00 | 1 | €0.00 | €0.00 | To protect tables
11 | Technasium | 2023-03-28 | 2023-03-28 | Wire | Practise soldering wire | 50 | €0.00 | 1 | €0.00 | €0.00 | Left over from other projects
12 | Daniël | 2023-01-01 | 2023-03-28 | Tester | Test RGB/WS2811 | 1 | €0.00 | 1 | €0.00 | €0.00
13 | Technasium | 2023-03-28 | 2023-03-28 | Solder | Bad/Good solder | 4 | €0.00 | 1 | €0.00 | €0.00
14 | Technasium | 2023-03-28 | 2023-03-28 | PSU | Lab bench powersupply | 1 | €0.00 | 1 | €0.00 | €0.00
15 | Technasium | 2023-03-28 | 2023-03-28 | Ruler | Metal | 1 | €0.00 | 1 | €0.00 | €0.00
 |  |  |  |  |  |  |  |  | Total
 |  |  |  |  |  |  |  |  | €0.00

Sheet: 2024
leerlingen | Thomas
 | Jesse
 | Mathijs
 | Luka
Description | Type | Present | Needed | Comment
Wire | 22AWG 3pin | 1 | 1
ESP32 | S2 mini | 40 | 10
JSH XH 2.54 | 3Pin housing | 100 | 10
JST XH 2.54 | Pin | 400 | 30
JST XH 2.54 | 3Pin angled connector | 100 | 10
WS2811 | F5 hat led | 1000 | 512
Wood | 122x61x3cm |  | 3
Glue | Hotglue (bol.com) |  | 1
Solder | Kester 63/37 0.031" | 1 | 1
Wire | BLK vertind 0,80mm |  | 2
Wire | BLK vertind 1,00mm |  | 1
USB-C | Bulk 1m |  | 10
RGB LED | Common anode | 1000 | 100
Side cutter | Universel | 8 | 8
Crimper | IWS-2820 | 1 | 1
Solderingstation | T245 130W | 7 | 8 | Extra soldeerstation van boven
Side cutter | KWS-102 | 3 | 3
Fume extractor | FA-400 | 7 | 8 | Van thuis meenemen
Drill bit | 0,8mm | 4 | 1
Wrench | Table Wrench | 3 | 1
Drill | Battery Powered | 3 | 1
Power | 4 Sockets + USB | 0 | 4 | IKEA
Pincer | Regular | 0 | 8 | Binask
3D prints | Jig and bender | 8 | 8 | Reserve printen
PVC Tube | Storage tube 17 cm | 5 | 8 | Grote kleiner maken
Storage | Soldering/Project assets | 0 | 1 | Bak voor spullen
Hardboard | For soldering |  | 8
Wire | Practise soldering wire | 1 | 1
Tester | Test RGB/WS2811 | 1 | 1 | Reserve maken
Solder | Bad/Good solder | 1 | 1
Ruler | Metal |  | 8 | Binask
