MaltWhiskey/Technasium/Tech Cube/Construction/3D print/Bender.stl

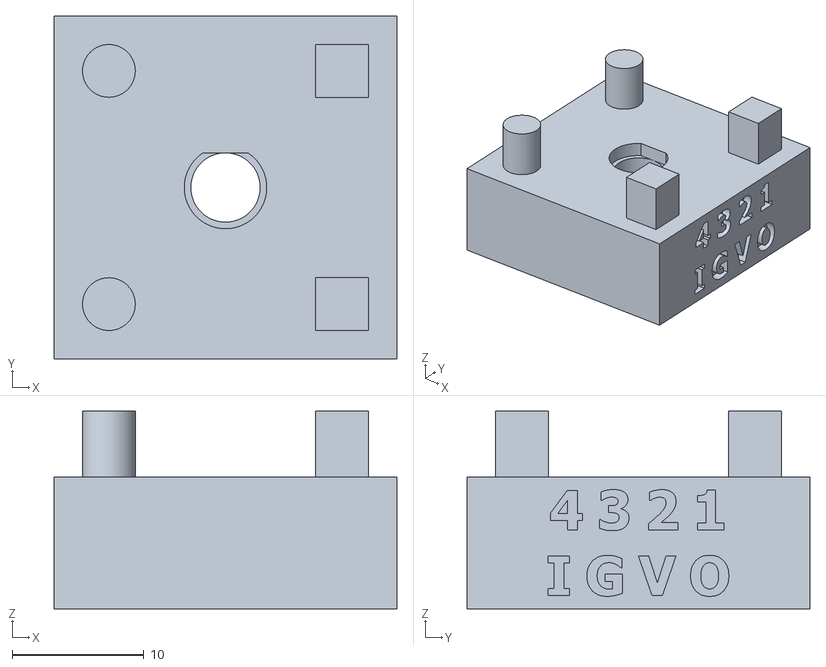
[picture p178: CAD file, 2023-05-08]
Tech Cube/Construction/3D print/Bender.stl
26.0 x 26.0 x 15.0
