MaltWhiskey/Technasium/Tech Cube/Construction/Box Design/Blank/Drill.dxf

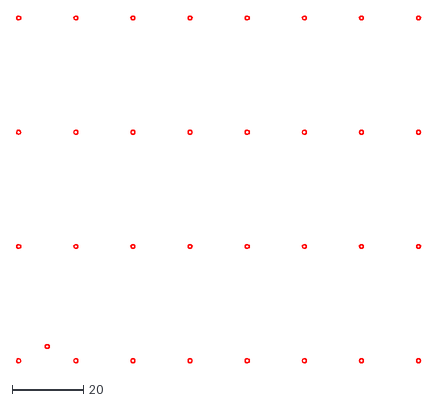
[picture p179: CAD file, 2023-05-08]
Tech Cube/Construction/Box Design/Blank/Drill.dxf
113.2 x 97.2
