MaltWhiskey/Technasium/Tech Cube/Construction/3D print/Lid R.stl

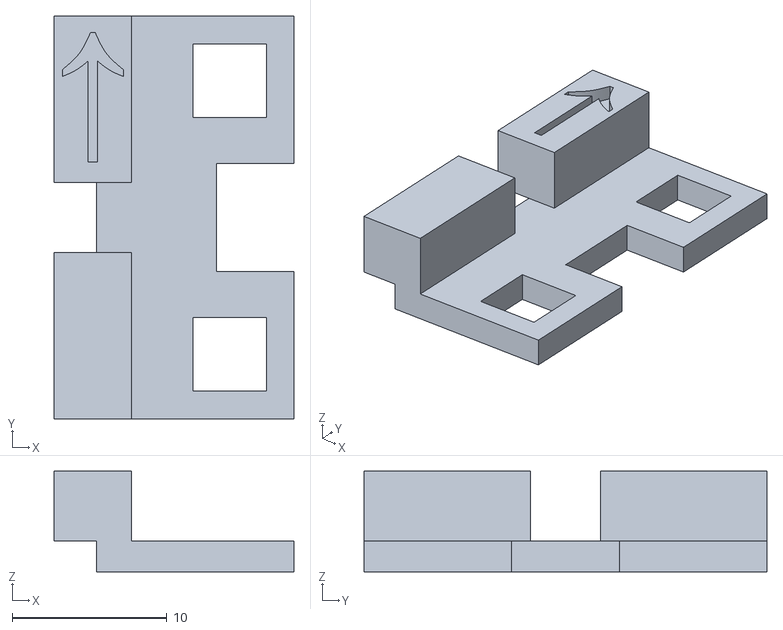
[picture p180: CAD file, 2023-05-08]
Tech Cube/Construction/3D print/Lid R.stl
15.5 x 26.0 x 6.50
