MaltWhiskey/Technasium/Tech Cube/Construction/Box Design/Blank/Outline.dxf

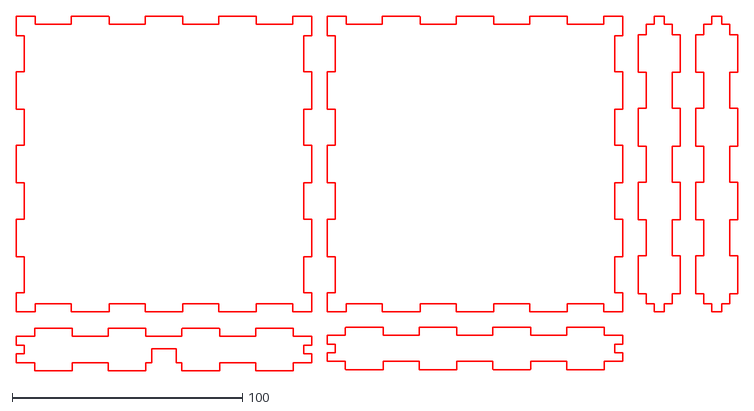
[picture p181: CAD file, 2023-05-08]
Tech Cube/Construction/Box Design/Blank/Outline.dxf
313.4 x 153.9
