MaltWhiskey/Technasium/Tech Cube/Construction/3D print/Lid L.stl

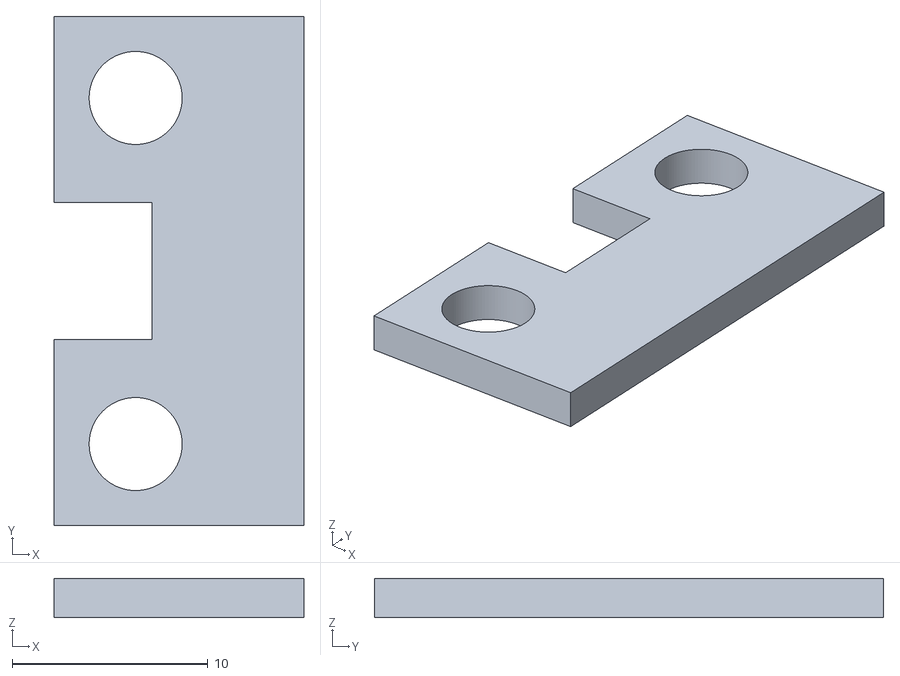
[picture p182: CAD file, 2023-05-08]
Tech Cube/Construction/3D print/Lid L.stl
12.8 x 26.0 x 2.00
