MaltWhiskey/Technasium/Tech Cube/Construction/3D print/Cap.stl

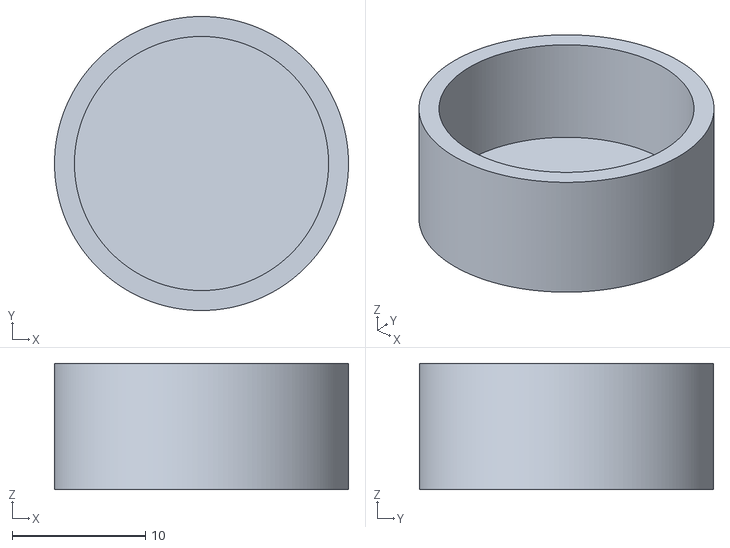
[picture p183: CAD file, 2023-05-08]
Tech Cube/Construction/3D print/Cap.stl
22.1 x 22.1 x 9.50
