MaltWhiskey/Technasium/Tech Cube/Construction/3D print/Frame.stl

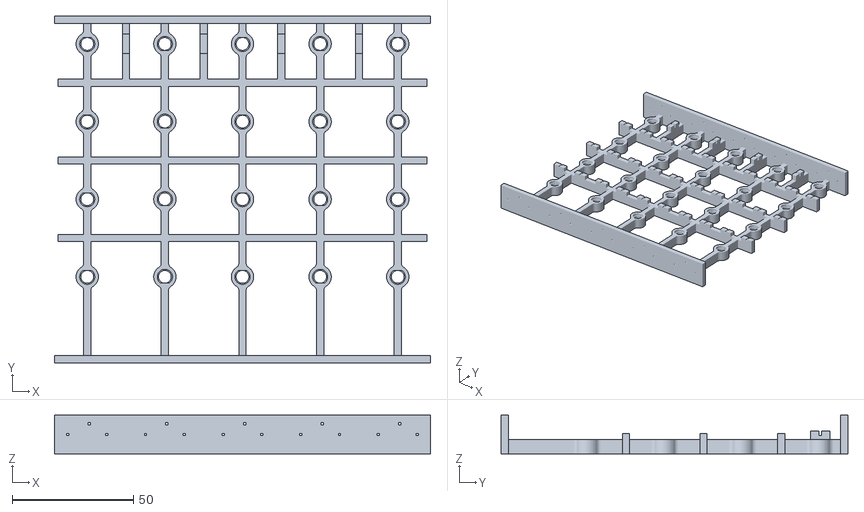
[picture p184: CAD file, 2023-05-08]
Tech Cube/Construction/3D print/Frame.stl
155.0 x 143.0 x 16.0
