MaltWhiskey/Technasium/Tech Cube/Construction/3D print/DIMTST.stl

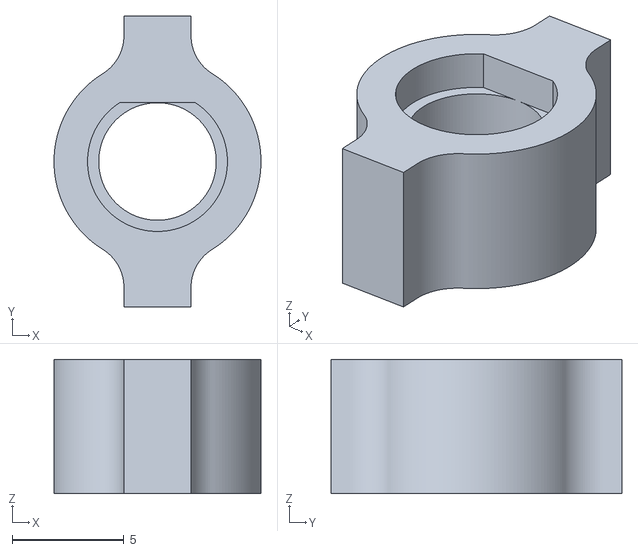
[picture p185: CAD file, 2023-05-08]
Tech Cube/Construction/3D print/DIMTST.stl
9.25 x 13.0 x 6.00
