MaltWhiskey/Technasium/(list of files, cad)

Other CAD files:
Tech Cube/Construction/Fusion 360/4 Plane Clip v11.f3d
Tech Cube/Construction/Fusion 360/4 Plane Clip v7.f3d
Tech Cube/Construction/Fusion 360/Tech Cube v14.f3d
