MaltWhiskey/Technasium/Tech Cube/Construction/3D print/readme.txt

Use the following slicer settings:
Wall Ordering = outside_in
Z Seam Alignment = random
Hole Horizontal Expansion = X

To get the right dimensions, first print the DIMTST to determine X
