MaltWhiskey/Technasium/Grogu Badge/Electronics/Grogu.kicad_sch

## KiCad design Grogu Badge/Electronics/Grogu.kicad_sch (2024-03-17)

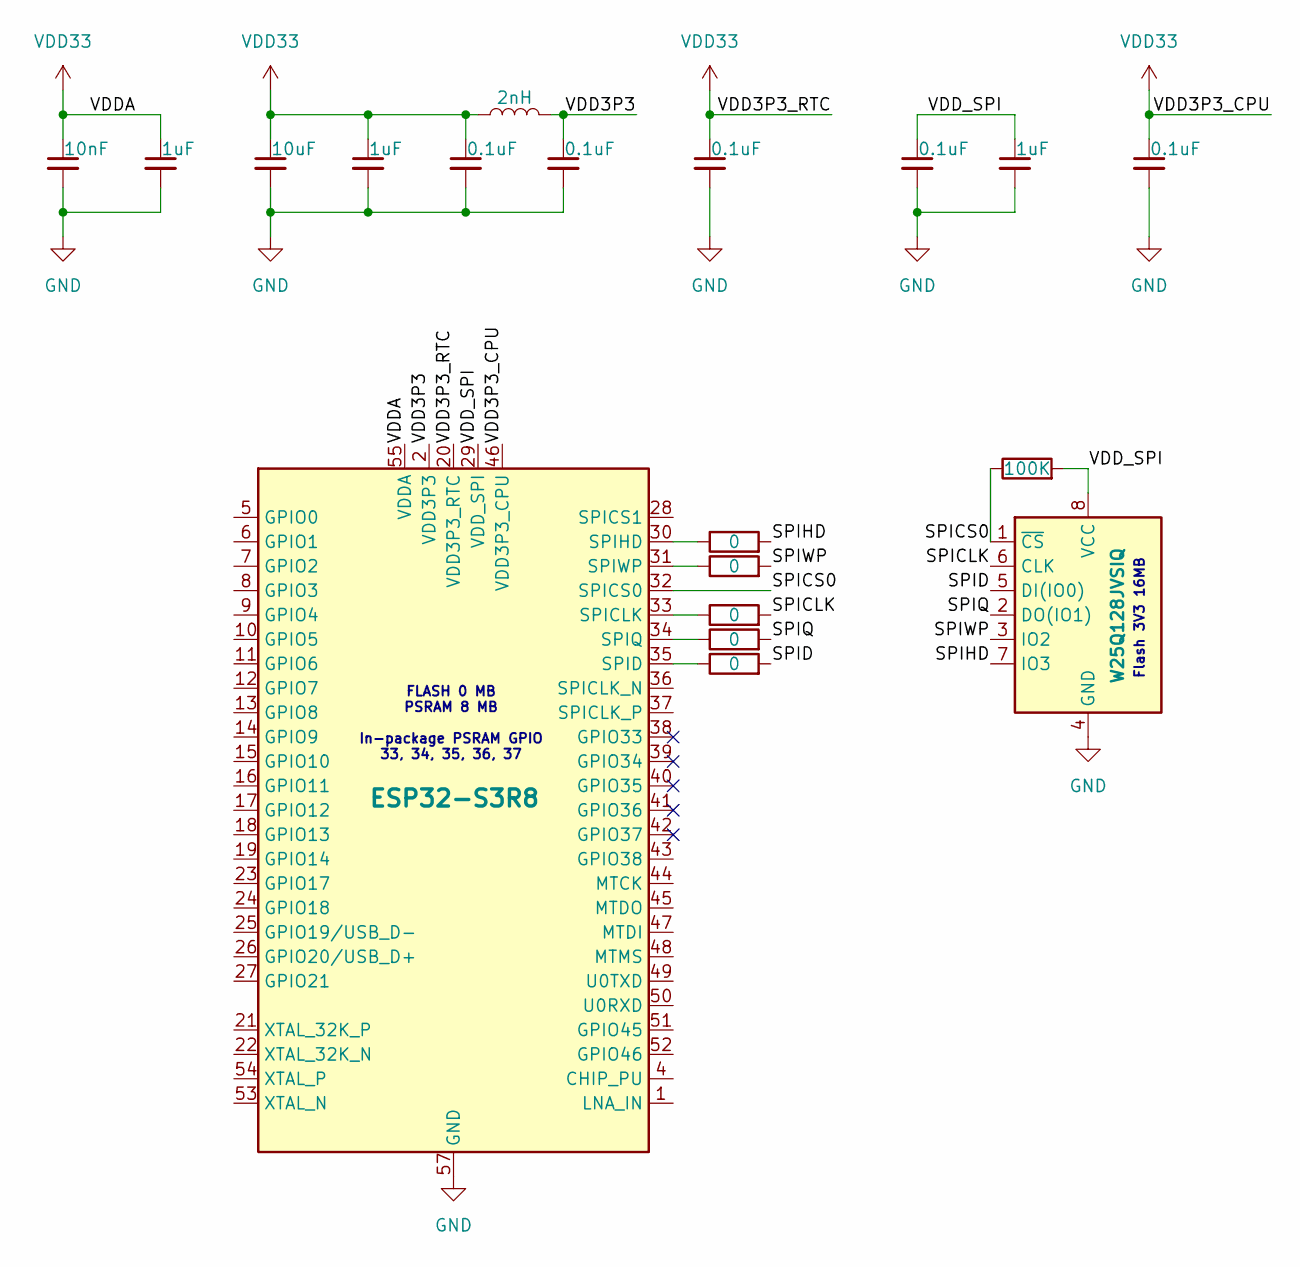
[picture p186: schematic Grogu.kicad_sch]

Parts:
C1, C10, C11, C12, C13: 0.1uF
C5: 10nF
C7, C9, C14: 1uF
C8: 10uF
L1: 2nH
R2, R3, R5, R6, R7: 0
R8: 100K
U1: ESP32-S3R8; QFN-56-1EP_7x7mm_P0.4mm_EP4x4mm
U2: W25Q128JVSIQ; SOIC-8_5.23x5.23mm_P1.27mm

Connections:
GND: C1.2, C5.2, C7.2, C8.2, C9.2, C10.2, C11.2, C12.2, C13.2, C14.2, U1.57 (GND), U2.4 (GND)
unnamed: R2.1, U1.30 (SPIHD)
unnamed: R3.1, U1.31 (SPIWP)
unnamed: R5.1, U1.33 (SPICLK)
unnamed: R6.1, U1.34 (SPIQ)
unnamed: R7.1, U1.35 (SPID)
SPICLK: R5.2, U2.6 (CLK)
SPICS0: R8.1, U1.32 (SPICS0), U2.1 (~CS)
SPID: R7.2, U2.5 (DI(IO0))
SPIHD: R2.2, U2.7 (IO3)
SPIQ: R6.2, U2.2 (DO(IO1))
SPIWP: R3.2, U2.3 (IO2)
VDD3P3: C11.1, L1.2, U1.2 (VDD3P3), U1.3 (VDD3P3)
VDD33: C1.1, C5.1, C7.1, C8.1, C9.1, C10.1, C12.1, L1.1, U1.20 (VDD3P3_RTC), U1.46 (VDD3P3_CPU), U1.55 (VDDA), U1.56 (VDDA)
VDD_SPI: C13.1, C14.1, R8.2, U1.29 (VDD_SPI), U2.8 (VCC)

Notes on the sheet:
Flash 3V3 16MB
FLASH 0 MB PSRAM 8 MB In-package PSRAM GPIO 33, 34, 35, 36, 37
