MaltWhiskey/Technasium/Halloween/Software/Pumpkin/src/magniet.h

const unsigned char magniet[] = {
    0x81, 0x81, 0x80, 0x7f, 0x7e, 0x7e, 0x7f, 0x80, 0x81, 0x81, 0x81, 0x80,
    0x80, 0x7f, 0x7f, 0x7f, 0x7f, 0x80, 0x7f, 0x7f, 0x7f, 0x80, 0x81, 0x81,
    0x80, 0x7f, 0x7e, 0x7e, 0x7e, 0x7f, 0x80, 0x81, 0x81, 0x81, 0x80, 0x7e,
    0x7d, 0x7d, 0x7f, 0x81, 0x82, 0x82, 0x82, 0x81, 0x80, 0x7f, 0x7e, 0x7e,
    0x7f, 0x7f, 0x7f, 0x7f, 0x7e, 0x7f, 0x7f, 0x7f, 0x7f, 0x7f, 0x7f, 0x7e,
    0x7d, 0x7d, 0x7d, 0x80, 0x81, 0x82, 0x81, 0x7f, 0x7e, 0x7e, 0x7e, 0x7f,
    0x80, 0x81, 0x82, 0x82, 0x81, 0x7f, 0x7d, 0x7d, 0x7d, 0x7f, 0x80, 0x81,
    0x81, 0x81, 0x80, 0x7e, 0x7d, 0x7d, 0x7e, 0x80, 0x81, 0x81, 0x81, 0x81,
    0x80, 0x80, 0x80, 0x80, 0x80, 0x7f, 0x7f, 0x7f, 0x7f, 0x80, 0x80, 0x81,
    0x81, 0x80, 0x7e, 0x7e, 0x7d, 0x7d, 0x7d, 0x7f, 0x80, 0x80, 0x7f, 0x7e,
    0x7d, 0x7c, 0x7c, 0x7c, 0x7d, 0x7d, 0x7e, 0x7f, 0x7f, 0x7e, 0x7d, 0x7c,
    0x7c, 0x7c, 0x7d, 0x7e, 0x7f, 0x80, 0x80, 0x80, 0x7f, 0x7f, 0x7e, 0x7e,
    0x7e, 0x7f, 0x80, 0x81, 0x82, 0x82, 0x82, 0x82, 0x81, 0x80, 0x80, 0x81,
    0x82, 0x82, 0x83, 0x82, 0x82, 0x81, 0x80, 0x7f, 0x7f, 0x80, 0x81, 0x82,
    0x82, 0x82, 0x81, 0x80, 0x80, 0x80, 0x81, 0x81, 0x81, 0x81, 0x80, 0x7f,
    0x7e, 0x7e, 0x7d, 0x7b, 0x79, 0x78, 0x76, 0x77, 0x77, 0x77, 0x78, 0x79,
    0x79, 0x78, 0x76, 0x75, 0x75, 0x77, 0x7a, 0x7d, 0x7f, 0x81, 0x82, 0x81,
    0x80, 0x7f, 0x80, 0x82, 0x84, 0x88, 0x8b, 0x8c, 0x8a, 0x87, 0x84, 0x85,
    0x86, 0x85, 0x86, 0x88, 0x8d, 0x8e, 0x8e, 0x8e, 0x90, 0x94, 0x98, 0x9a,
    0x9a, 0x9b, 0x98, 0x94, 0x8b, 0x83, 0x7a, 0x76, 0x76, 0x78, 0x71, 0x5d,
    0x49, 0x42, 0x4c, 0x59, 0x5b, 0x4d, 0x40, 0x49, 0x59, 0x5d, 0x4f, 0x4a,
    0x59, 0x76, 0x8c, 0x90, 0x8e, 0x93, 0xa1, 0xaa, 0xa6, 0xa1, 0xa8, 0xb4,
    0xbc, 0xb8, 0xb1, 0xa6, 0xa3, 0xa0, 0xa2, 0x9f, 0xa4, 0xa6, 0xa2, 0xa0,
    0x9a, 0x96, 0x93, 0x9b, 0x95, 0x90, 0xa3, 0xa5, 0x66, 0x23, 0x12, 0x4f,
    0x9e, 0xab, 0x5e, 0x1f, 0x27, 0x3f, 0x32, 0x1c, 0x2e, 0x2f, 0x5e, 0x89,
    0x79, 0x53, 0x49, 0x71, 0x8e, 0x88, 0x6e, 0x79, 0xad, 0xde, 0xd7, 0xac,
    0x93, 0x9c, 0xb0, 0xaf, 0x97, 0x86, 0x97, 0xb1, 0xb1, 0x96, 0x7b, 0x76,
    0x7b, 0x7e, 0x78, 0x6f, 0x6b, 0x70, 0x72, 0x64, 0x50, 0x3f, 0x3f, 0x52,
    0x6c, 0x7c, 0x7c, 0x6f, 0x66, 0x6f, 0x7b, 0x7e, 0x7f, 0x8d, 0xa7, 0xc1,
    0xc9, 0xc0, 0xbb, 0xbe, 0xcc, 0xd1, 0xc5, 0xb5, 0xac, 0xa5, 0x87, 0x5c,
    0x42, 0x57, 0x81, 0x8b, 0x61, 0x33, 0x27, 0x2e, 0x31, 0x1c, 0x1c, 0x30,
    0x50, 0x76, 0x7d, 0x6c, 0x5d, 0x64, 0x7f, 0x93, 0x92, 0x93, 0xa5, 0xc0,
    0xc9, 0xbb, 0xa5, 0xa1, 0xac, 0xb5, 0xad, 0xa3, 0x9d, 0x9c, 0x93, 0x76,
    0x55, 0x43, 0x4c, 0x66, 0x80, 0x81, 0x6a, 0x54, 0x5e, 0x78, 0x88, 0x82,
    0x7b, 0x94, 0xbc, 0xd3, 0xd5, 0xd4, 0xcc, 0xc3, 0xaa, 0x72, 0x3b, 0x25,
    0x34, 0x53, 0x61, 0x58, 0x54, 0x5f, 0x63, 0x55, 0x33, 0x28, 0x46, 0x80,
    0xaf, 0xb9, 0xb6, 0xb7, 0xb7, 0xa9, 0x88, 0x5b, 0x4d, 0x6a, 0x9a, 0xb1,
    0xa3, 0x83, 0x69, 0x60, 0x59, 0x4b, 0x51, 0x78, 0xa0, 0xbe, 0xbf, 0xa9,
    0x8a, 0x77, 0x61, 0x4b, 0x42, 0x55, 0x7c, 0xa4, 0xbe, 0xa6, 0x8a, 0x8d,
    0xa4, 0xb4, 0xac, 0x8f, 0x7e, 0x81, 0x95, 0xb1, 0xc4, 0xbf, 0xae, 0x65,
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
