MaltWhiskey/Technasium/Tech Cube 9x9x9/software/Infinity Display/src/core/INMP441.h

#ifndef INMP441_H
#define INMP441_H

namespace I2S_MIC {

void begin(uint32_t frequency);
uint16_t loop(int32_t *buffer, const uint16_t samples);
uint16_t loop(int16_t *buffer, const uint16_t samples);

}  // namespace I2S_MIC
#endif
