MaltWhiskey/Technasium/(commit log)

2023-03-09 Easy sample
2023-05-16 Clean up workspace
    [Tech Cube - BOM.csv, Tech Cube - BOM.xlsx]
2023-06-14 Hacked white frame for testing
2023-08-31 fresh init
    [4 Plane Clip v7.f3d, Bender.stl, Cap.stl, DIMTST.stl, Drill.dxf, Frame.stl, Grogu.kicad_pcb, Grogu.kicad_sch]
2023-08-31 New fusion version
    [4 Plane Clip v11.f3d]
2023-09-29 update led cube webpage
2023-12-30 buggy source control commit
    [4 Plane Clip v11.f3d, 4 Plane Clip v7.f3d, Bender.stl, Cap.stl, DIMTST.stl, Drill.dxf, Frame.stl, Grogu.kicad_pcb]
2024-02-16 bug in esp32 wificlient
    [Config.h, WebServer.cpp, WebServer.h]
2024-03-17 new mac
    [Grogu.kicad_pcb, Grogu.kicad_sch, HRO_TYPE-C-31-M-12.step, ICS-43434.step]
2024-04-22 Motor on Interrupt
2024-04-26 other motor
2024-04-27 update stepperdriver
2024-05-13 fix filenames advanced exemple
    [main.cpp]
2024-06-07 motor speed
