MaltWhiskey/Technasium/(notices)

Notices in the files:
Tech Cube 9x9x9/software/Infinity Display/src/fft/arduinoFFT.h:
This program is free software: you can redistribute it and/or modify
it under the terms of the GNU General Public License as published by
the Free Software Foundation, either version 3 of the License, or
(at your option) any later version.
